farmerkeith/SolarChargerTwoAmp10percent/readme.md

This project is a minimal change to the MPPT solar charger published by deba168 on Instructables.

The changes are just to make the charging process work, and prevent reverse current flow into the panel from the battery. 
Software is still being checked at this stage.
