farmerkeith/SolarChargerTwoAmp10percent/spreadsheets/TwoAmp10%Design.ods

Sheet: ModelDeba168
ModelDeba168: Published as MPPT version 3
Design parameters
 | Min | Nominal | Max
Vpp | 17 | 18 | 25
Vbb | 11.7 | 12 | 14.2
No. of modules | 1
Design current (Amps) | 5
PWM freq | 50,000
Capacitor C1 | ESR | Count | Diameter | Length | Capacitance | C2 count |  | Current
C1 ESR (milli Ohms) | 120 | 1 | 13.5 | 20.5 | 220 | 1 |  | 1 | 3.2 | 5 | 6.67 | 10 | 20
 |  | Count | Rdson 175C | Ciss | Crss | Transconductance | Vth | Vpl-Vth
Q1 MOSFET | IRFZ44N | 1 | 39.375 | 1470 | 88 | 19
Q2 MOSFET (per module) | IRFZ44N | 1 | 39.375 | 1470 | 88 | 19 | 3 | 0.10 | 0.17 | 0.26 | 0.37 | 0.53 | 1.05
Q3 MOSFET (per module) | IRFZ44N | 1 | 39.375 | 1470 | 88 | 19
Vdrv | 12 |  | IR2110 | IR2184 | IR2104
ZdrvON | 71.43 |  | 7.5 |  | 71.43
ZdrvOFF | 41.67 |  | 7.5 |  | 41.67
Toroid | In use |  |  | Data in waiting
Toroid type code | T94-26 |  |  | T94-26 | T106-26 | T130-26 | T157-26 | T225-26B
No. of turns | 24
No. of strands | 1 | Fill factor
Wire diameter | 0.518 | 0.031936996627653 | 20 AWG
OD | 23.9 |  |  | 23.9 | 26.924 | 33 | 39.9 | 57.15
ID | 14.2 |  |  | 14.2 | 14.478 | 19.8 | 24.1 | 35.7
W | 7.9 |  |  | 7.9 | 11.0998 | 11.09 | 14.5 | 25.4
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
