farmerkeith/SolarChargerTwoAmp10percent/spreadsheets/Results1.ods

Sheet: CurentTest_2A
 | charger | 301
 |  |  |  |  |  |  |  |  |  |  | Ipp
pwm1.current_Test:Time | 0.5 | target | 2 | battery_soc | 0.5 | pv_illumination | 0.5 | Vpp | 20.14 | Ipp | 2.8302 | IppL | 0.5322 | Ipp | delta | 2.298 | soc | 0 | Vbb | 11.4898 | Vpp | 21.033 | Ipp | 0.5871 | Ipp | delta | 0.0549 | Ibb | 1.075 | Tt/16 | 12 | Tt | 192 | Tp/16 | 5.4375 | Tp | 87 | Tpe/16 | 6.4375 | Tpe | 103 | track | 8 | current | up, | dcm: | dutyChange | 8 | Tt/16 | 13.5 | Tt | 216 | Tp/16 | 5.9375 | Tp | 95 | Tpe/16 | 10.8125 | Tpe
pwm1.current_Test:Time | 2.356 | target | 2 | battery_soc | 0 | pv_illumination | 1 | Vpp | 21.033 | Ipp | 0.5871 | IppL | 0.5322 | Ipp | delta | 0.0549 | soc | 0.0011 | Vbb | 11.4994 | Vpp | 21.018 | Ipp | 0.6222 | Ipp | delta | -0.0009 | Ibb | 1.137 | Tt/16 | 13.5 | Tt | 216 | Tp/16 | 5.9375 | Tp | 95 | Tpe/16 | 10.8125 | Tpe | 173 | track | 8 | current | up, | dcm: | dutyChange | 8 | Tt/16 | 14.6875 | Tt | 235 | Tp/16 | 6.4375 | Tp | 103 | Tpe/16 | 11.75 | Tpe
pwm1.current_Test:Time | 2.5 | target | 2 | battery_soc | 0 | pv_illumination | 1 | Vpp | 21.018 | Ipp | 0.6222 | IppL | 0.623 | Ipp | delta | -0.0009 | soc | 0.0022 | Vbb | 11.5117 | Vpp | 20.999 | Ipp | 0.6702 | Ipp | delta | -0.0012 | Ibb | 1.223 | Tt/16 | 14.6875 | Tt | 235 | Tp/16 | 6.4375 | Tp | 103 | Tpe/16 | 11.75 | Tpe | 188 | track | 8 | current | up, | dcm: | dutyChange | 8 | Tt/16 | 15.75 | Tt | 252 | Tp/16 | 6.9375 | Tp | 111 | Tpe/16 | 12.625 | Tpe
pwm1.current_Test:Time | 3 | target | 2 | battery_soc | 0 | pv_illumination | 1 | Vpp | 20.999 | Ipp | 0.6702 | IppL | 0.6715 | Ipp | delta | -0.0012 | soc | 0.0034 | Vbb | 11.5252 | Vpp | 20.977 | Ipp | 0.7232 | Ipp | delta | -0.0016 | Ibb | 1.316 | Tt/16 | 15.75 | Tt | 252 | Tp/16 | 6.9375 | Tp | 111 | Tpe/16 | 12.625 | Tpe | 202 | track | 8 | current | up, | dcm: | dutyChange | 8 | Tt/16 | 16.875 | Tt | 270 | Tp/16 | 7.4375 | Tp | 119 | Tpe/16 | 13.5 | Tpe
pwm1.current_Test:Time | 3.5 | target | 2 | battery_soc | 0 | pv_illumination | 1 | Vpp | 20.977 | Ipp | 0.7232 | IppL | 0.7247 | Ipp | delta | -0.0016 | soc | 0.0048 | Vbb | 11.5381 | Vpp | 20.956 | Ipp | 0.7729 | Ipp | delta | -0.0017 | Ibb | 1.404 | Tt/16 | 16.875 | Tt | 270 | Tp/16 | 7.4375 | Tp | 119 | Tpe/16 | 13.5 | Tpe | 216 | track | 8 | current | up, | dcm: | dutyChange | 8 | Tt/16 | 17.9375 | Tt | 287 | Tp/16 | 7.9375 | Tp | 127 | Tpe/16 | 14.375 | Tpe
pwm1.current_Test:Time | 4 | target | 2 | battery_soc | 0.01 | pv_illumination | 1 | Vpp | 20.956 | Ipp | 0.7729 | IppL | 0.7745 | Ipp | delta | -0.0017 | soc | 0.0062 | Vbb | 11.5516 | Vpp | 20.934 | Ipp | 0.8253 | Ipp | delta | -0.0017 | Ibb | 1.496 | Tt/16 | 17.9375 | Tt | 287 | Tp/16 | 7.9375 | Tp | 127 | Tpe/16 | 14.375 | Tpe | 230 | track | 8 | current | up, | dcm: | dutyChange | 8 | Tt/16 | 19.0625 | Tt | 305 | Tp/16 | 8.4375 | Tp | 135 | Tpe/16 | 15.25 | Tpe
pwm1.current_Test:Time | 4.5 | target | 2 | battery_soc | 0.01 | pv_illumination | 1 | Vpp | 20.934 | Ipp | 0.8253 | IppL | 0.827 | Ipp | delta | -0.0017 | soc | 0.0077 | Vbb | 11.5645 | Vpp | 20.914 | Ipp | 0.8742 | Ipp | delta | -0.0018 | Ibb | 1.581 | Tt/16 | 19.0625 | Tt | 305 | Tp/16 | 8.4375 | Tp | 135 | Tpe/16 | 15.25 | Tpe | 244 | track | 8 | current | up, | dcm: | dutyChange | 8 | Tt/16 | 20.125 | Tt | 322 | Tp/16 | 8.9375 | Tp | 143 | Tpe/16 | 16.125 | Tpe
pwm1.current_Test:Time | 5 | target | 2 | battery_soc | 0.01 | pv_illumination | 1 | Vpp | 20.914 | Ipp | 0.8742 | IppL | 0.876 | Ipp | delta | -0.0018 | soc | 0.0092 | Vbb | 11.578 | Vpp | 20.893 | Ipp | 0.9257 | Ipp | delta | -0.0021 | Ibb | 1.67 | Tt/16 | 20.125 | Tt | 322 | Tp/16 | 8.9375 | Tp | 143 | Tpe/16 | 16.125 | Tpe | 258 | track | 8 | current | up, | dcm: | dutyChange | 8 | Tt/16 | 21.25 | Tt | 340 | Tp/16 | 9.4375 | Tp | 151 | Tpe/16 | 17 | Tpe
pwm1.current_Test:Time | 5.5 | target | 2 | battery_soc | 0.01 | pv_illumination | 1 | Vpp | 20.893 | Ipp | 0.9257 | IppL | 0.9278 | Ipp | delta | -0.0021 | soc | 0.0109 | Vbb | 11.5908 | Vpp | 20.873 | Ipp | 0.9741 | Ipp | delta | -0.002 | Ibb | 1.754 | Tt/16 | 21.25 | Tt | 340 | Tp/16 | 9.4375 | Tp | 151 | Tpe/16 | 17 | Tpe | 272 | track | 8 | current | up, | dcm: | dutyChange | 8 | Tt/16 | 22.3125 | Tt | 357 | Tp/16 | 9.9375 | Tp | 159 | Tpe/16 | 17.875 | Tpe
pwm1.current_Test:Time | 6 | target | 2 | battery_soc | 0.01 | pv_illumination | 1 | Vpp | 20.873 | Ipp | 0.9741 | IppL | 0.9761 | Ipp | delta | -0.002 | soc | 0.0127 | Vbb | 11.6044 | Vpp | 20.853 | Ipp | 1.025 | Ipp | delta | -0.0021 | Ibb | 1.842 | Tt/16 | 22.3125 | Tt | 357 | Tp/16 | 9.9375 | Tp | 159 | Tpe/16 | 17.875 | Tpe | 286 | track | 8 | current | up, | dcm: | dutyChange | 8 | Tt/16 | 23.4375 | Tt | 375 | Tp/16 | 10.4375 | Tp | 167 | Tpe/16 | 18.75 | Tpe
pwm1.current_Test:Time | 6.5 | target | 2 | battery_soc | 0.01 | pv_illumination | 1 | Vpp | 20.853 | Ipp | 1.025 | IppL | 1.0271 | Ipp | delta | -0.0021 | soc | 0.0145 | Vbb | 11.6172 | Vpp | 20.833 | Ipp | 1.0726 | Ipp | delta | -0.0021 | Ibb | 1.924 | Tt/16 | 23.4375 | Tt | 375 | Tp/16 | 10.4375 | Tp | 167 | Tpe/16 | 18.75 | Tpe | 300 | track | 8 | current | up, | dcm: | dutyChange | 8 | Tt/16 | 24.4375 | Tt | 391 | Tp/16 | 10.9375 | Tp | 175 | Tpe/16 | 19.5625 | Tpe
pwm1.current_Test:Time | 7 | target | 2 | battery_soc | 0.02 | pv_illumination | 1 | Vpp | 20.833 | Ipp | 1.0726 | IppL | 1.0747 | Ipp | delta | -0.0021 | soc | 0.0164 | Vbb | 11.6313 | Vpp | 20.812 | Ipp | 1.1254 | Ipp | delta | -0.0024 | Ibb | 2.014 | Tt/16 | 24.4375 | Tt | 391 | Tp/16 | 10.9375 | Tp | 175 | Tpe/16 | 19.5625 | Tpe | 313 | track | 8 | current | up, | dcm: | dutyChange | 8 | Tt/16 | 20 | Tt | 320 | Tp/16 | 11.4375 | Tp | 183 | Tpe/16 | 20.4375 | Tpe
pwm1.current_Test:Time | 7.5 | target | 2 | battery_soc | 0.02 | pv_illumination | 1 | Vpp | 20.812 | Ipp | 1.1254 | IppL | 1.1279 | Ipp | delta | -0.0024 | soc | 0.0185 | Vbb | 11.8879 | Vpp | 20.339 | Ipp | 2.3135 | Ipp | delta | 0 | Ibb | 3.958 | Tt/16 | 20 | Tt | 320 | Tp/16 | 11.4375 | Tp | 183 | Tpe/16 | 20.4375 | Tpe | 327 | track | 4 | current | dn, | ccm: | dutyChange | -4 | Tt/16 | 20 | Tt | 320 | Tp/16 | 11.1875 | Tp | 179 | Tpe/16 | 20.4375 | Tpe
pwm1.current_Test:Time | 8 | target | 2 | battery_soc | 0.02 | pv_illumination | 1 | Vpp | 20.339 | Ipp | 2.3135 | IppL | 2.3135 | Ipp | delta | 0 | soc | 0.0225 | Vbb | 11.4027 | Vpp | 21.252 | Ipp | 0.0656 | Ipp | delta | 0 | Ibb | 0.122 | Tt/16 | 20 | Tt | 320 | Tp/16 | 11.1875 | Tp | 179 | Tpe/16 | 20.4375 | Tpe | 327 | track | 5 | current | up, | ccm: | dutyChange | 4 | Tt/16 | 26.625 | Tt | 426 | Tp/16 | 11.4375 | Tp | 183 | Tpe/16 | 21.3125 | Tpe
pwm1.current_Test:Time | 8.5 | target | 2 | battery_soc | 0.02 | pv_illumination | 1 | Vpp | 21.252 | Ipp | 0.0656 | IppL | 0.0656 | Ipp | delta | 0 | soc | 0.0226 | Vbb | 11.6515 | Vpp | 20.8 | Ipp | 1.1545 | Ipp | delta | -0.0553 | Ibb | 2.061 | Tt/16 | 26.625 | Tt | 426 | Tp/16 | 11.4375 | Tp | 183 | Tpe/16 | 21.3125 | Tpe | 341 | track | 5 | current | up, | dcm: | dutyChange | 4 | Tt/16 | 20 | Tt | 320 | Tp/16 | 11.6875 | Tp | 187 | Tpe/16 | 20.8125 | Tpe
pwm1.current_Test:Time | 9.455 | target | 2 | battery_soc | 0.02 | pv_illumination | 1 | Vpp | 20.8 | Ipp | 1.1545 | IppL | 1.2098 | Ipp | delta | -0.0553 | soc | 0.0247 | Vbb | 12.111 | Vpp | 19.938 | Ipp | 3.3645 | Ipp | delta | 0 | Ibb | 5.539 | Tt/16 | 20 | Tt | 320 | Tp/16 | 11.6875 | Tp | 187 | Tpe/16 | 20.8125 | Tpe | 333 | track | 1 | current | dn, | ccm: | dutyChange | -1 | Tt/16 | 20 | Tt | 320 | Tp/16 | 11.625 | Tp | 186 | Tpe/16 | 20.8125 | Tpe
pwm1.current_Test:Time | 9.5 | target | 2 | battery_soc | 0.03 | pv_illumination | 1 | Vpp | 19.938 | Ipp | 3.3645 | IppL | 3.3645 | Ipp | delta | 0 | soc | 0.0305 | Vbb | 11.6287 | Vpp | 20.836 | Ipp | 1.0653 | Ipp | delta | 0 | Ibb | 1.909 | Tt/16 | 20 | Tt | 320 | Tp/16 | 11.625 | Tp | 186 | Tpe/16 | 20.8125 | Tpe | 333 | track | 2 | current | up, | ccm: | dutyChange | 1 | Tt/16 | 20 | Tt | 320 | Tp/16 | 11.6875 | Tp | 187 | Tpe/16 | 20.8125 | Tpe
pwm1.current_Test:Time | 10 | target | 2 | battery_soc | 0.03 | pv_illumination | 1 | Vpp | 20.836 | Ipp | 1.0653 | IppL | 1.0653 | Ipp | delta | 0 | soc | 0.0323 | Vbb | 12.1443 | Vpp | 19.899 | Ipp | 3.4691 | Ipp | delta | 0 | Ibb | 5.684 | Tt/16 | 20 | Tt | 320 | Tp/16 | 11.6875 | Tp | 187 | Tpe/16 | 20.8125 | Tpe | 333 | track | 0 | current | dn, | ccm: | dutyChange | -1 | Tt/16 | 20 | Tt | 320 | Tp/16 | 11.625 | Tp | 186 | Tpe/16 | 20.8125 | Tpe
pwm1.current_Test:Time | 10.5 | target | 2 | battery_soc | 0.04 | pv_illumination | 1 | Vpp | 19.899 | Ipp | 3.4691 | IppL | 3.4691 | Ipp | delta | 0 | soc | 0.0382 | Vbb | 11.6098 | Vpp | 20.893 | Ipp | 0.9252 | Ipp | delta | 0 | Ibb | 1.665 | Tt/16 | 20 | Tt | 320 | Tp/16 | 11.625 | Tp | 186 | Tpe/16 | 20.8125 | Tpe | 333 | track | 2 | current | up, | ccm: | dutyChange | 1 | Tt/16 | 26.25 | Tt | 420 | Tp/16 | 11.6875 | Tp | 187 | Tpe/16 | 21 | Tpe
pwm1.current_Test:Time | 11 | target | 2 | battery_soc | 0.04 | pv_illumination | 1 | Vpp | 20.893 | Ipp | 0.9252 | IppL | 0.9252 | Ipp | delta | 0 | soc | 0.0398 | Vbb | 11.6802 | Vpp | 20.784 | Ipp | 1.1935 | Ipp | delta | -0.0142 | Ibb | 2.124 | Tt/16 | 26.25 | Tt | 420 | Tp/16 | 11.6875 | Tp | 187 | Tpe/16 | 21 | Tpe | 336 | track | 3 | current | up, | dcm: | dutyChange | 1 | Tt/16 | 20 | Tt | 320 | Tp/16 | 11.75 | Tp | 188 | Tpe/16 | 20.875 | Tpe
pwm1.current_Test:Time | 11.5 | target | 2 | battery_soc | 0.04 | pv_illumination | 1 | Vpp | 20.784 | Ipp | 1.1935 | IppL | 1.2077 | Ipp | delta | -0.0142 | soc | 0.042 | Vbb | 12.1647 | Vpp | 19.881 | Ipp | 3.518 | Ipp | delta | 0 | Ibb | 5.75 | Tt/16 | 20 | Tt | 320 | Tp/16 | 11.75 | Tp | 188 | Tpe/16 | 20.875 | Tpe | 334 | track | 0 | current | dn, | ccm: | dutyChange | -1 | Tt/16 | 20 | Tt | 320 | Tp/16 | 11.6875 | Tp | 187 | Tpe/16 | 20.875 | Tpe
pwm1.current_Test:Time | 12 | target | 2 | battery_soc | 0.05 | pv_illumination | 1 | Vpp | 19.881 | Ipp | 3.518 | IppL | 3.518 | Ipp | delta | 0 | soc | 0.048 | Vbb | 11.6629 | Vpp | 20.817 | Ipp | 1.1131 | Ipp | delta | 0 | Ibb | 1.987 | Tt/16 | 20 | Tt | 320 | Tp/16 | 11.6875 | Tp | 187 | Tpe/16 | 20.875 | Tpe | 334 | track | 2 | current | up, | ccm: | dutyChange | 1 | Tt/16 | 20 | Tt | 320 | Tp/16 | 11.75 | Tp | 188 | Tpe/16 | 20.875 | Tpe
pwm1.current_Test:Time | 12.5 | target | 2 | battery_soc | 0.05 | pv_illumination | 1 | Vpp | 20.817 | Ipp | 1.1131 | IppL | 1.1131 | Ipp | delta | 0 | soc | 0.0499 | Vbb | 12.1929 | Vpp | 19.852 | Ipp | 3.5972 | Ipp | delta | 0 | Ibb | 5.857 | Tt/16 | 20 | Tt | 320 | Tp/16 | 11.75 | Tp | 188 | Tpe/16 | 20.875 | Tpe | 334 | track | 0 | current | dn, | ccm: | dutyChange | -1 | Tt/16 | 20 | Tt | 320 | Tp/16 | 11.6875 | Tp | 187 | Tpe/16 | 20.875 | Tpe
pwm1.current_Test:Time | 13 | target | 2 | battery_soc | 0.06 | pv_illumination | 1 | Vpp | 19.852 | Ipp | 3.5972 | IppL | 3.5972 | Ipp | delta | 0 | soc | 0.056 | Vbb | 11.6492 | Vpp | 20.865 | Ipp | 0.9946 | Ipp | delta | 0 | Ibb | 1.782 | Tt/16 | 20 | Tt | 320 | Tp/16 | 11.6875 | Tp | 187 | Tpe/16 | 20.875 | Tpe | 334 | track | 2 | current | up, | ccm: | dutyChange | 1 | Tt/16 | 26.25 | Tt | 420 | Tp/16 | 11.75 | Tp | 188 | Tpe/16 | 21 | Tpe
pwm1.current_Test:Time | 13.5 | target | 2 | battery_soc | 0.06 | pv_illumination | 1 | Vpp | 20.865 | Ipp | 0.9946 | IppL | 0.9946 | Ipp | delta | 0 | soc | 0.0577 | Vbb | 11.7067 | Vpp | 20.781 | Ipp | 1.2008 | Ipp | delta | -0.011 | Ibb | 2.132 | Tt/16 | 26.25 | Tt | 420 | Tp/16 | 11.75 | Tp | 188 | Tpe/16 | 21 | Tpe | 336 | track | 3 | current | up, | dcm: | dutyChange | 1 | Tt/16 | 20 | Tt | 320 | Tp/16 | 11.8125 | Tp | 189 | Tpe/16 | 20.9375 | Tpe
pwm1.current_Test:Time | 14 | target | 2 | battery_soc | 0.06 | pv_illumination | 1 | Vpp | 20.781 | Ipp | 1.2008 | IppL | 1.2118 | Ipp | delta | -0.011 | soc | 0.0598 | Vbb | 12.221 | Vpp | 19.821 | Ipp | 3.681 | Ipp | delta | 0 | Ibb | 5.97 | Tt/16 | 20 | Tt | 320 | Tp/16 | 11.8125 | Tp | 189 | Tpe/16 | 20.9375 | Tpe | 335 | track | 0 | current | dn, | ccm: | dutyChange | -1 | Tt/16 | 20 | Tt | 320 | Tp/16 | 11.75 | Tp | 188 | Tpe/16 | 20.9375 | Tpe
pwm1.current_Test:Time | 14.5 | target | 2 | battery_soc | 0.07 | pv_illumination | 1 | Vpp | 19.821 | Ipp | 3.681 | IppL | 3.681 | Ipp | delta | 0 | soc | 0.0661 | Vbb | 11.6956 | Vpp | 20.802 | Ipp | 1.1495 | Ipp | delta | 0 | Ibb | 2.045 | Tt/16 | 20 | Tt | 320 | Tp/16 | 11.75 | Tp | 188 | Tpe/16 | 20.9375 | Tpe | 335 | track | 2 | current | up, | ccm: | dutyChange | 1 | Tt/16 | 20 | Tt | 320 | Tp/16 | 11.8125 | Tp | 189 | Tpe/16 | 20.9375 | Tpe
pwm1.current_Test:Time | 15 | target | 2 | battery_soc | 0.07 | pv_illumination | 1 | Vpp | 20.802 | Ipp | 1.1495 | IppL | 1.1495 | Ipp | delta | 0 | soc | 0.068 | Vbb | 12.2436 | Vpp | 19.802 | Ipp | 3.7319 | Ipp | delta | 0 | Ibb | 6.036 | Tt/16 | 20 | Tt | 320 | Tp/16 | 11.8125 | Tp | 189 | Tpe/16 | 20.9375 | Tpe | 335 | track | 0 | current | dn, | ccm: | dutyChange | -1 | Tt/16 | 20 | Tt | 320 | Tp/16 | 11.75 | Tp | 188 | Tpe/16 | 20.9375 | Tpe
pwm1.current_Test:Time | 15.5 | target | 2 | battery_soc | 0.07 | pv_illumination | 1 | Vpp | 19.802 | Ipp | 3.7319 | IppL | 3.7319 | Ipp | delta | 0 | soc | 0.0743 | Vbb | 11.6874 | Vpp | 20.84 | Ipp | 1.0551 | Ipp | delta | 0 | Ibb | 1.881 | Tt/16 | 20 | Tt | 320 | Tp/16 | 11.75 | Tp | 188 | Tpe/16 | 20.9375 | Tpe | 335 | track | 2 | current | up, | ccm: | dutyChange | 1 | Tt/16 | 20 | Tt | 320 | Tp/16 | 11.8125 | Tp | 189 | Tpe/16 | 20.9375 | Tpe
pwm1.current_Test:Time | 16 | target | 2 | battery_soc | 0.08 | pv_illumination | 1 | Vpp | 20.84 | Ipp | 1.0551 | IppL | 1.0551 | Ipp | delta | 0 | soc | 0.0761 | Vbb | 12.2633 | Vpp | 19.788 | Ipp | 3.7693 | Ipp | delta | 0 | Ibb | 6.082 | Tt/16 | 20 | Tt | 320 | Tp/16 | 11.8125 | Tp | 189 | Tpe/16 | 20.9375 | Tpe | 335 | track | 0 | current | dn, | ccm: | dutyChange | -1 | Tt/16 | 20 | Tt | 320 | Tp/16 | 11.75 | Tp | 188 | Tpe/16 | 20.9375 | Tpe
pwm1.current_Test:Time | 16.5 | target | 2 | battery_soc | 0.08 | pv_illumination | 1 | Vpp | 19.788 | Ipp | 3.7693 | IppL | 3.7693 | Ipp | delta | 0 | soc | 0.0825 | Vbb | 11.6819 | Vpp | 20.874 | Ipp | 0.9733 | Ipp | delta | 0 | Ibb | 1.739 | Tt/16 | 20 | Tt | 320 | Tp/16 | 11.75 | Tp | 188 | Tpe/16 | 20.9375 | Tpe | 335 | track | 2 | current | up, | ccm: | dutyChange | 1 | Tt/16 | 26.3125 | Tt | 421 | Tp/16 | 11.8125 | Tp | 189 | Tpe/16 | 21.0625 | Tpe
pwm1.current_Test:Time | 17 | target | 2 | battery_soc | 0.08 | pv_illumination | 1 | Vpp | 20.874 | Ipp | 0.9733 | IppL | 0.9733 | Ipp | delta | 0 | soc | 0.0842 | Vbb | 11.7453 | Vpp | 20.779 | Ipp | 1.2062 | Ipp | delta | -0.0124 | Ibb | 2.134 | Tt/16 | 26.3125 | Tt | 421 | Tp/16 | 11.8125 | Tp | 189 | Tpe/16 | 21.0625 | Tpe | 337 | track | 3 | current | up, | dcm: | dutyChange | 1 | Tt/16 | 20 | Tt | 320 | Tp/16 | 11.875 | Tp | 190 | Tpe/16 | 21 | Tpe
pwm1.current_Test:Time | 17.5 | target | 2 | battery_soc | 0.09 | pv_illumination | 1 | Vpp | 20.779 | Ipp | 1.2062 | IppL | 1.2186 | Ipp | delta | -0.0124 | soc | 0.0863 | Vbb | 12.2776 | Vpp | 19.782 | Ipp | 3.7873 | Ipp | delta | 0 | Ibb | 6.102 | Tt/16 | 20 | Tt | 320 | Tp/16 | 11.875 | Tp | 190 | Tpe/16 | 21 | Tpe | 336 | track | 0 | current | dn, | ccm: | dutyChange | -1 | Tt/16 | 20 | Tt | 320 | Tp/16 | 11.8125 | Tp | 189 | Tpe/16 | 21 | Tpe
pwm1.current_Test:Time | 18 | target | 2 | battery_soc | 0.09 | pv_illumination | 1 | Vpp | 19.782 | Ipp | 3.7873 | IppL | 3.7873 | Ipp | delta | 0 | soc | 0.0927 | Vbb | 11.7402 | Vpp | 20.787 | Ipp | 1.1848 | Ipp | delta | 0 | Ibb | 2.098 | Tt/16 | 20 | Tt | 320 | Tp/16 | 11.8125 | Tp | 189 | Tpe/16 | 21 | Tpe | 336 | track | 2 | current | up, | ccm: | dutyChange | 1 | Tt/16 | 20 | Tt | 320 | Tp/16 | 11.875 | Tp | 190 | Tpe/16 | 21 | Tpe
pwm1.current_Test:Time | 18.5 | target | 2 | battery_soc | 0.09 | pv_illumination | 1 | Vpp | 20.787 | Ipp | 1.1848 | IppL | 1.1848 | Ipp | delta | 0 | soc | 0.0947 | Vbb | 12.2946 | Vpp | 19.773 | Ipp | 3.8108 | Ipp | delta | 0 | Ibb | 6.129 | Tt/16 | 20 | Tt | 320 | Tp/16 | 11.875 | Tp | 190 | Tpe/16 | 21 | Tpe | 336 | track | 0 | current | dn, | ccm: | dutyChange | -1 | Tt/16 | 20 | Tt | 320 | Tp/16 | 11.8125 | Tp | 189 | Tpe/16 | 21 | Tpe
pwm1.current_Test:Time | 19 | target | 2 | battery_soc | 0.1 | pv_illumination | 1 | Vpp | 19.773 | Ipp | 3.8108 | IppL | 3.8108 | Ipp | delta | 0 | soc | 0.1011 | Vbb | 11.7373 | Vpp | 20.816 | Ipp | 1.1138 | Ipp | delta | 0 | Ibb | 1.975 | Tt/16 | 20 | Tt | 320 | Tp/16 | 11.8125 | Tp | 189 | Tpe/16 | 21 | Tpe | 336 | track | 2 | current | up, | ccm: | dutyChange | 1 | Tt/16 | 20 | Tt | 320 | Tp/16 | 11.875 | Tp | 190 | Tpe/16 | 21 | Tpe
pwm1.current_Test:Time | 19.5 | target | 2 | battery_soc | 0.1 | pv_illumination | 1 | Vpp | 20.816 | Ipp | 1.1138 | IppL | 1.1138 | Ipp | delta | 0 | soc | 0.103 | Vbb | 12.3094 | Vpp | 19.768 | Ipp | 3.8239 | Ipp | delta | 0 | Ibb | 6.141 | Tt/16 | 20 | Tt | 320 | Tp/16 | 11.875 | Tp | 190 | Tpe/16 | 21 | Tpe | 336 | track | 0 | current | dn, | ccm: | dutyChange | -1 | Tt/16 | 20 | Tt | 320 | Tp/16 | 11.8125 | Tp | 189 | Tpe/16 | 21 | Tpe
pwm1.current_Test:Time | 20 | target | 2 | battery_soc | 0.11 | pv_illumination | 1 | Vpp | 19.768 | Ipp | 3.8239 | IppL | 3.8239 | Ipp | delta | 0 | soc | 0.1095 | Vbb | 11.7364 | Vpp | 20.841 | Ipp | 1.0525 | Ipp | delta | 0 | Ibb | 1.869 | Tt/16 | 20 | Tt | 320 | Tp/16 | 11.8125 | Tp | 189 | Tpe/16 | 21 | Tpe | 336 | track | 2 | current | up, | ccm: | dutyChange | 1 | Tt/16 | 20 | Tt | 320 | Tp/16 | 11.875 | Tp | 190 | Tpe/16 | 21 | Tpe
pwm1.current_Test:Time | 20.5 | target | 2 | battery_soc | 0.11 | pv_illumination | 1 | Vpp | 20.841 | Ipp | 1.0525 | IppL | 1.0525 | Ipp | delta | 0 | soc | 0.1112 | Vbb | 12.3222 | Vpp | 19.767 | Ipp | 3.8282 | Ipp | delta | 0 | Ibb | 6.141 | Tt/16 | 20 | Tt | 320 | Tp/16 | 11.875 | Tp | 190 | Tpe/16 | 21 | Tpe | 336 | track | 0 | current | dn, | ccm: | dutyChange | -1 | Tt/16 | 20 | Tt | 320 | Tp/16 | 11.8125 | Tp | 189 | Tpe/16 | 21 | Tpe
pwm1.current_Test:Time | 21 | target | 2 | battery_soc | 0.12 | pv_illumination | 1 | Vpp | 19.767 | Ipp | 3.8282 | IppL | 3.8282 | Ipp | delta | 0 | soc | 0.1177 | Vbb | 11.7371 | Vpp | 20.863 | Ipp | 0.9995 | Ipp | delta | 0 | Ibb | 1.777 | Tt/16 | 20 | Tt | 320 | Tp/16 | 11.8125 | Tp | 189 | Tpe/16 | 21 | Tpe | 336 | track | 2 | current | up, | ccm: | dutyChange | 1 | Tt/16 | 26.3125 | Tt | 421 | Tp/16 | 11.875 | Tp | 190 | Tpe/16 | 21.0625 | Tpe
pwm1.current_Test:Time | 21.5 | target | 2 | battery_soc | 0.12 | pv_illumination | 1 | Vpp | 20.863 | Ipp | 0.9995 | IppL | 0.9995 | Ipp | delta | 0 | soc | 0.1194 | Vbb | 11.796 | Vpp | 20.777 | Ipp | 1.2113 | Ipp | delta | -0.0114 | Ibb | 2.134 | Tt/16 | 26.3125 | Tt | 421 | Tp/16 | 11.875 | Tp | 190 | Tpe/16 | 21.0625 | Tpe | 337 | track | 3 | current | up, | dcm: | dutyChange | 1 | Tt/16 | 20 | Tt | 320 | Tp/16 | 11.9375 | Tp | 191 | Tpe/16 | 21 | Tpe
pwm1.current_Test:Time | 22 | target | 2 | battery_soc | 0.12 | pv_illumination | 1 | Vpp | 20.777 | Ipp | 1.2113 | IppL | 1.2227 | Ipp | delta | -0.0114 | soc | 0.1215 | Vbb | 12.3349 | Vpp | 19.763 | Ipp | 3.8381 | Ipp | delta | 0 | Ibb | 6.149 | Tt/16 | 20 | Tt | 320 | Tp/16 | 11.9375 | Tp | 191 | Tpe/16 | 21 | Tpe | 336 | track | 0 | current | dn, | ccm: | dutyChange | -1 | Tt/16 | 20 | Tt | 320 | Tp/16 | 11.875 | Tp | 190 | Tpe/16 | 21 | Tpe
pwm1.current_Test:Time | 22.5 | target | 2 | battery_soc | 0.13 | pv_illumination | 1 | Vpp | 19.763 | Ipp | 3.8381 | IppL | 3.8381 | Ipp | delta | 0 | soc | 0.128 | Vbb | 11.7965 | Vpp | 20.775 | Ipp | 1.2166 | Ipp | delta | 0 | Ibb | 2.143 | Tt/16 | 20 | Tt | 320 | Tp/16 | 11.875 | Tp | 190 | Tpe/16 | 21 | Tpe | 336 | track | 2 | current | up, | ccm: | dutyChange | 1 | Tt/16 | 20 | Tt | 320 | Tp/16 | 11.9375 | Tp | 191 | Tpe/16 | 21 | Tpe
pwm1.current_Test:Time | 23 | target | 2 | battery_soc | 0.13 | pv_illumination | 1 | Vpp | 20.775 | Ipp | 1.2166 | IppL | 1.2166 | Ipp | delta | 0 | soc | 0.13 | Vbb | 12.3467 | Vpp | 19.764 | Ipp | 3.8359 | Ipp | delta | 0 | Ibb | 6.14 | Tt/16 | 20 | Tt | 320 | Tp/16 | 11.9375 | Tp | 191 | Tpe/16 | 21 | Tpe | 336 | track | 0 | current | dn, | ccm: | dutyChange | -1 | Tt/16 | 20 | Tt | 320 | Tp/16 | 11.875 | Tp | 190 | Tpe/16 | 21 | Tpe
pwm1.current_Test:Time | 23.5 | target | 2 | battery_soc | 0.14 | pv_illumination | 1 | Vpp | 19.764 | Ipp | 3.8359 | IppL | 3.8359 | Ipp | delta | 0 | soc | 0.1364 | Vbb | 11.7984 | Vpp | 20.794 | Ipp | 1.1677 | Ipp | delta | 0 | Ibb | 2.058 | Tt/16 | 20 | Tt | 320 | Tp/16 | 11.875 | Tp | 190 | Tpe/16 | 21 | Tpe | 336 | track | 2 | current | up, | ccm: | dutyChange | 1 | Tt/16 | 20 | Tt | 320 | Tp/16 | 11.9375 | Tp | 191 | Tpe/16 | 21 | Tpe
pwm1.current_Test:Time | 24 | target | 2 | battery_soc | 0.14 | pv_illumination | 1 | Vpp | 20.794 | Ipp | 1.1677 | IppL | 1.1677 | Ipp | delta | 0 | soc | 0.1384 | Vbb | 12.3569 | Vpp | 19.767 | Ipp | 3.827 | Ipp | delta | 0 | Ibb | 6.122 | Tt/16 | 20 | Tt | 320 | Tp/16 | 11.9375 | Tp | 191 | Tpe/16 | 21 | Tpe | 336 | track | 0 | current | dn, | ccm: | dutyChange | -1 | Tt/16 | 20 | Tt | 320 | Tp/16 | 11.875 | Tp | 190 | Tpe/16 | 21 | Tpe
pwm1.current_Test:Time | 24.5 | target | 2 | battery_soc | 0.14 | pv_illumination | 1 | Vpp | 19.767 | Ipp | 3.827 | IppL | 3.827 | Ipp | delta | 0 | soc | 0.1448 | Vbb | 11.8016 | Vpp | 20.812 | Ipp | 1.1252 | Ipp | delta | 0 | Ibb | 1.984 | Tt/16 | 20 | Tt | 320 | Tp/16 | 11.875 | Tp | 190 | Tpe/16 | 21 | Tpe | 336 | track | 2 | current | up, | ccm: | dutyChange | 1 | Tt/16 | 20 | Tt | 320 | Tp/16 | 11.9375 | Tp | 191 | Tpe/16 | 21 | Tpe
pwm1.current_Test:Time | 25 | target | 2 | battery_soc | 0.15 | pv_illumination | 1 | Vpp | 20.812 | Ipp | 1.1252 | IppL | 1.1252 | Ipp | delta | 0 | soc | 0.1467 | Vbb | 12.3659 | Vpp | 19.772 | Ipp | 3.8126 | Ipp | delta | 0 | Ibb | 6.096 | Tt/16 | 20 | Tt | 320 | Tp/16 | 11.9375 | Tp | 191 | Tpe/16 | 21 | Tpe | 336 | track | 0 | current | dn, | ccm: | dutyChange | -1 | Tt/16 | 20 | Tt | 320 | Tp/16 | 11.875 | Tp | 190 | Tpe/16 | 21 | Tpe
pwm1.current_Test:Time | 25.5 | target | 2 | battery_soc | 0.15 | pv_illumination | 1 | Vpp | 19.772 | Ipp | 3.8126 | IppL | 3.8126 | Ipp | delta | 0 | soc | 0.1531 | Vbb | 11.8057 | Vpp | 20.827 | Ipp | 1.088 | Ipp | delta | 0 | Ibb | 1.919 | Tt/16 | 20 | Tt | 320 | Tp/16 | 11.875 | Tp | 190 | Tpe/16 | 21 | Tpe | 336 | track | 2 | current | up, | ccm: | dutyChange | 1 | Tt/16 | 20 | Tt | 320 | Tp/16 | 11.9375 | Tp | 191 | Tpe/16 | 21 | Tpe
pwm1.current_Test:Time | 26 | target | 2 | battery_soc | 0.15 | pv_illumination | 1 | Vpp | 20.827 | Ipp | 1.088 | IppL | 1.088 | Ipp | delta | 0 | soc | 0.1549 | Vbb | 12.3738 | Vpp | 19.779 | Ipp | 3.7938 | Ipp | delta | 0 | Ibb | 6.064 | Tt/16 | 20 | Tt | 320 | Tp/16 | 11.9375 | Tp | 191 | Tpe/16 | 21 | Tpe | 336 | track | 0 | current | dn, | ccm: | dutyChange | -1 | Tt/16 | 20 | Tt | 320 | Tp/16 | 11.875 | Tp | 190 | Tpe/16 | 21 | Tpe
pwm1.current_Test:Time | 26.5 | target | 2 | battery_soc | 0.16 | pv_illumination | 1 | Vpp | 19.779 | Ipp | 3.7938 | IppL | 3.7938 | Ipp | delta | 0 | soc | 0.1613 | Vbb | 11.8107 | Vpp | 20.84 | Ipp | 1.0553 | Ipp | delta | 0 | Ibb | 1.862 | Tt/16 | 20 | Tt | 320 | Tp/16 | 11.875 | Tp | 190 | Tpe/16 | 21 | Tpe | 336 | track | 2 | current | up, | ccm: | dutyChange | 1 | Tt/16 | 20 | Tt | 320 | Tp/16 | 11.9375 | Tp | 191 | Tpe/16 | 21 | Tpe
pwm1.current_Test:Time | 27 | target | 2 | battery_soc | 0.16 | pv_illumination | 1 | Vpp | 20.84 | Ipp | 1.0553 | IppL | 1.0553 | Ipp | delta | 0 | soc | 0.1631 | Vbb | 12.3809 | Vpp | 19.788 | Ipp | 3.7712 | Ipp | delta | 0 | Ibb | 6.027 | Tt/16 | 20 | Tt | 320 | Tp/16 | 11.9375 | Tp | 191 | Tpe/16 | 21 | Tpe | 336 | track | 0 | current | dn, | ccm: | dutyChange | -1 | Tt/16 | 20 | Tt | 320 | Tp/16 | 11.875 | Tp | 190 | Tpe/16 | 21 | Tpe
pwm1.current_Test:Time | 27.5 | target | 2 | battery_soc | 0.17 | pv_illumination | 1 | Vpp | 19.788 | Ipp | 3.7712 | IppL | 3.7712 | Ipp | delta | 0 | soc | 0.1694 | Vbb | 11.8163 | Vpp | 20.852 | Ipp | 1.0263 | Ipp | delta | 0 | Ibb | 1.811 | Tt/16 | 20 | Tt | 320 | Tp/16 | 11.875 | Tp | 190 | Tpe/16 | 21 | Tpe | 336 | track | 2 | current | up, | ccm: | dutyChange | 1 | Tt/16 | 20 | Tt | 320 | Tp/16 | 11.9375 | Tp | 191 | Tpe/16 | 21 | Tpe
pwm1.current_Test:Time | 28 | target | 2 | battery_soc | 0.17 | pv_illumination | 1 | Vpp | 20.852 | Ipp | 1.0263 | IppL | 1.0263 | Ipp | delta | 0 | soc | 0.1711 | Vbb | 12.3872 | Vpp | 19.797 | Ipp | 3.7458 | Ipp | delta | 0 | Ibb | 5.986 | Tt/16 | 20 | Tt | 320 | Tp/16 | 11.9375 | Tp | 191 | Tpe/16 | 21 | Tpe | 336 | track | 0 | current | dn, | ccm: | dutyChange | -1 | Tt/16 | 20 | Tt | 320 | Tp/16 | 11.875 | Tp | 190 | Tpe/16 | 21 | Tpe
pwm1.current_Test:Time | 28.5 | target | 2 | battery_soc | 0.18 | pv_illumination | 1 | Vpp | 19.797 | Ipp | 3.7458 | IppL | 3.7458 | Ipp | delta | 0 | soc | 0.1774 | Vbb | 11.8224 | Vpp | 20.863 | Ipp | 1.0004 | Ipp | delta | 0 | Ibb | 1.765 | Tt/16 | 20 | Tt | 320 | Tp/16 | 11.875 | Tp | 190 | Tpe/16 | 21 | Tpe | 336 | track | 2 | current | up, | ccm: | dutyChange | 1 | Tt/16 | 26.3125 | Tt | 421 | Tp/16 | 11.9375 | Tp | 191 | Tpe/16 | 21.0625 | Tpe
pwm1.current_Test:Time | 29 | target | 2 | battery_soc | 0.18 | pv_illumination | 1 | Vpp | 20.863 | Ipp | 1.0004 | IppL | 1.0004 | Ipp | delta | 0 | soc | 0.1791

Sheet: CurrentTest_2A.2
 | charger | 301
 |  |  |  |  |  |  |  |  |  |  |  |  |  |  |  |  |  |  |  | Vbb |  |  |  | Ipp
pwm1.current_Test:Time | 0.5 | target | 2 | battery_soc | 0.5 | pv_illumination | 0.5 | Vpp | 20.14 | Ipp | 2.8302 | IppL | 0.5322 | Ipp | delta | 2.298 | soc | 0 | Vbb | 11.4898 | Vpp | 21.033 | Ipp | 0.5871 | Ipp | delta | 0.0549 | Ibb | 1.075 | Tt/16 | 12 | Tt | 192 | Tp/16 | 5.4375 | Tp | 87 | Tpe/16 | 6.4375 | Tpe | 103 | track | 8 | current | up, | dcm: | dutyChange | 8 | Tt/16 | 13.5 | Tt | 216 | Tp/16 | 5.9375 | Tp | 95 | Tpe/16 | 10.8125 | Tpe
pwm1.current_Test:Time | 2.356 | target | 2 | battery_soc | 0 | pv_illumination | 1 | Vpp | 21.033 | Ipp | 0.5871 | IppL | 0.5322 | Ipp | delta | 0.0549 | soc | 0.0011 | Vbb | 11.4994 | Vpp | 21.018 | Ipp | 0.6222 | Ipp | delta | -0.0009 | Ibb | 1.137 | Tt/16 | 13.5 | Tt | 216 | Tp/16 | 5.9375 | Tp | 95 | Tpe/16 | 10.8125 | Tpe | 173 | track | 8 | current | up, | dcm: | dutyChange | 8 | Tt/16 | 14.6875 | Tt | 235 | Tp/16 | 6.4375 | Tp | 103 | Tpe/16 | 11.75 | Tpe
pwm1.current_Test:Time | 2.5 | target | 2 | battery_soc | 0 | pv_illumination | 1 | Vpp | 21.018 | Ipp | 0.6222 | IppL | 0.623 | Ipp | delta | -0.0009 | soc | 0.0022 | Vbb | 11.5117 | Vpp | 20.999 | Ipp | 0.6702 | Ipp | delta | -0.0012 | Ibb | 1.223 | Tt/16 | 14.6875 | Tt | 235 | Tp/16 | 6.4375 | Tp | 103 | Tpe/16 | 11.75 | Tpe | 188 | track | 8 | current | up, | dcm: | dutyChange | 8 | Tt/16 | 15.75 | Tt | 252 | Tp/16 | 6.9375 | Tp | 111 | Tpe/16 | 12.625 | Tpe
pwm1.current_Test:Time | 3 | target | 2 | battery_soc | 0 | pv_illumination | 1 | Vpp | 20.999 | Ipp | 0.6702 | IppL | 0.6715 | Ipp | delta | -0.0012 | soc | 0.0034 | Vbb | 11.5252 | Vpp | 20.977 | Ipp | 0.7232 | Ipp | delta | -0.0016 | Ibb | 1.316 | Tt/16 | 15.75 | Tt | 252 | Tp/16 | 6.9375 | Tp | 111 | Tpe/16 | 12.625 | Tpe | 202 | track | 8 | current | up, | dcm: | dutyChange | 8 | Tt/16 | 16.875 | Tt | 270 | Tp/16 | 7.4375 | Tp | 119 | Tpe/16 | 13.5 | Tpe
pwm1.current_Test:Time | 3.5 | target | 2 | battery_soc | 0 | pv_illumination | 1 | Vpp | 20.977 | Ipp | 0.7232 | IppL | 0.7247 | Ipp | delta | -0.0016 | soc | 0.0048 | Vbb | 11.5381 | Vpp | 20.956 | Ipp | 0.7729 | Ipp | delta | -0.0017 | Ibb | 1.404 | Tt/16 | 16.875 | Tt | 270 | Tp/16 | 7.4375 | Tp | 119 | Tpe/16 | 13.5 | Tpe | 216 | track | 8 | current | up, | dcm: | dutyChange | 8 | Tt/16 | 17.9375 | Tt | 287 | Tp/16 | 7.9375 | Tp | 127 | Tpe/16 | 14.375 | Tpe
pwm1.current_Test:Time | 4 | target | 2 | battery_soc | 0.01 | pv_illumination | 1 | Vpp | 20.956 | Ipp | 0.7729 | IppL | 0.7745 | Ipp | delta | -0.0017 | soc | 0.0062 | Vbb | 11.5516 | Vpp | 20.934 | Ipp | 0.8253 | Ipp | delta | -0.0017 | Ibb | 1.496 | Tt/16 | 17.9375 | Tt | 287 | Tp/16 | 7.9375 | Tp | 127 | Tpe/16 | 14.375 | Tpe | 230 | track | 8 | current | up, | dcm: | dutyChange | 8 | Tt/16 | 19.0625 | Tt | 305 | Tp/16 | 8.4375 | Tp | 135 | Tpe/16 | 15.25 | Tpe
pwm1.current_Test:Time | 4.5 | target | 2 | battery_soc | 0.01 | pv_illumination | 1 | Vpp | 20.934 | Ipp | 0.8253 | IppL | 0.827 | Ipp | delta | -0.0017 | soc | 0.0077 | Vbb | 11.5645 | Vpp | 20.914 | Ipp | 0.8742 | Ipp | delta | -0.0018 | Ibb | 1.581 | Tt/16 | 19.0625 | Tt | 305 | Tp/16 | 8.4375 | Tp | 135 | Tpe/16 | 15.25 | Tpe | 244 | track | 8 | current | up, | dcm: | dutyChange | 8 | Tt/16 | 20.125 | Tt | 322 | Tp/16 | 8.9375 | Tp | 143 | Tpe/16 | 16.125 | Tpe
pwm1.current_Test:Time | 5 | target | 2 | battery_soc | 0.01 | pv_illumination | 1 | Vpp | 20.914 | Ipp | 0.8742 | IppL | 0.876 | Ipp | delta | -0.0018 | soc | 0.0092 | Vbb | 11.578 | Vpp | 20.893 | Ipp | 0.9257 | Ipp | delta | -0.0021 | Ibb | 1.67 | Tt/16 | 20.125 | Tt | 322 | Tp/16 | 8.9375 | Tp | 143 | Tpe/16 | 16.125 | Tpe | 258 | track | 8 | current | up, | dcm: | dutyChange | 8 | Tt/16 | 21.25 | Tt | 340 | Tp/16 | 9.4375 | Tp | 151 | Tpe/16 | 17 | Tpe
pwm1.current_Test:Time | 5.5 | target | 2 | battery_soc | 0.01 | pv_illumination | 1 | Vpp | 20.893 | Ipp | 0.9257 | IppL | 0.9278 | Ipp | delta | -0.0021 | soc | 0.0109 | Vbb | 11.5908 | Vpp | 20.873 | Ipp | 0.9741 | Ipp | delta | -0.002 | Ibb | 1.754 | Tt/16 | 21.25 | Tt | 340 | Tp/16 | 9.4375 | Tp | 151 | Tpe/16 | 17 | Tpe | 272 | track | 8 | current | up, | dcm: | dutyChange | 8 | Tt/16 | 22.3125 | Tt | 357 | Tp/16 | 9.9375 | Tp | 159 | Tpe/16 | 17.875 | Tpe
pwm1.current_Test:Time | 6 | target | 2 | battery_soc | 0.01 | pv_illumination | 1 | Vpp | 20.873 | Ipp | 0.9741 | IppL | 0.9761 | Ipp | delta | -0.002 | soc | 0.0127 | Vbb | 11.6044 | Vpp | 20.853 | Ipp | 1.025 | Ipp | delta | -0.0021 | Ibb | 1.842 | Tt/16 | 22.3125 | Tt | 357 | Tp/16 | 9.9375 | Tp | 159 | Tpe/16 | 17.875 | Tpe | 286 | track | 8 | current | up, | dcm: | dutyChange | 8 | Tt/16 | 23.4375 | Tt | 375 | Tp/16 | 10.4375 | Tp | 167 | Tpe/16 | 18.75 | Tpe
pwm1.current_Test:Time | 6.5 | target | 2 | battery_soc | 0.01 | pv_illumination | 1 | Vpp | 20.853 | Ipp | 1.025 | IppL | 1.0271 | Ipp | delta | -0.0021 | soc | 0.0145 | Vbb | 11.6172 | Vpp | 20.833 | Ipp | 1.0726 | Ipp | delta | -0.0021 | Ibb | 1.924 | Tt/16 | 23.4375 | Tt | 375 | Tp/16 | 10.4375 | Tp | 167 | Tpe/16 | 18.75 | Tpe | 300 | track | 8 | current | up, | dcm: | dutyChange | 8 | Tt/16 | 24.4375 | Tt | 391 | Tp/16 | 10.9375 | Tp | 175 | Tpe/16 | 19.5625 | Tpe
pwm1.current_Test:Time | 7 | target | 2 | battery_soc | 0.02 | pv_illumination | 1 | Vpp | 20.833 | Ipp | 1.0726 | IppL | 1.0747 | Ipp | delta | -0.0021 | soc | 0.0164 | Vbb | 11.6313 | Vpp | 20.812 | Ipp | 1.1254 | Ipp | delta | -0.0024 | Ibb | 2.014 | Tt/16 | 24.4375 | Tt | 391 | Tp/16 | 10.9375 | Tp | 175 | Tpe/16 | 19.5625 | Tpe | 313 | track | 8 | current | up, | dcm: | dutyChange | 8 | Tt/16 | 20 | Tt | 320 | Tp/16 | 11.4375 | Tp | 183 | Tpe/16 | 20.4375 | Tpe
pwm1.current_Test:Time | 7.5 | target | 2 | battery_soc | 0.02 | pv_illumination | 1 | Vpp | 20.812 | Ipp | 1.1254 | IppL | 1.1279 | Ipp | delta | -0.0024 | soc | 0.0185 | Vbb | 11.8879 | Vpp | 20.339 | Ipp | 2.3135 | Ipp | delta | 0 | Ibb | 3.958 | Tt/16 | 20 | Tt | 320 | Tp/16 | 11.4375 | Tp | 183 | Tpe/16 | 20.4375 | Tpe | 327 | track | 4 | current | dn, | ccm: | dutyChange | -4 | Tt/16 | 20 | Tt | 320 | Tp/16 | 11.1875 | Tp | 179 | Tpe/16 | 20.4375 | Tpe
pwm1.current_Test:Time | 8 | target | 2 | battery_soc | 0.02 | pv_illumination | 1 | Vpp | 20.339 | Ipp | 2.3135 | IppL | 2.3135 | Ipp | delta | 0 | soc | 0.0225 | Vbb | 11.4027 | Vpp | 21.252 | Ipp | 0.0656 | Ipp | delta | 0 | Ibb | 0.122 | Tt/16 | 20 | Tt | 320 | Tp/16 | 11.1875 | Tp | 179 | Tpe/16 | 20.4375 | Tpe | 327 | track | 5 | current | up, | ccm: | dutyChange | 4 | Tt/16 | 26.625 | Tt | 426 | Tp/16 | 11.4375 | Tp | 183 | Tpe/16 | 21.3125 | Tpe
pwm1.current_Test:Time | 8.5 | target | 2 | battery_soc | 0.02 | pv_illumination | 1 | Vpp | 21.252 | Ipp | 0.0656 | IppL | 0.0656 | Ipp | delta | 0 | soc | 0.0226 | Vbb | 11.6515 | Vpp | 20.8 | Ipp | 1.1545 | Ipp | delta | -0.0553 | Ibb | 2.061 | Tt/16 | 26.625 | Tt | 426 | Tp/16 | 11.4375 | Tp | 183 | Tpe/16 | 21.3125 | Tpe | 341 | track | 5 | current | up, | dcm: | dutyChange | 4 | Tt/16 | 20 | Tt | 320 | Tp/16 | 11.6875 | Tp | 187 | Tpe/16 | 20.8125 | Tpe
pwm1.current_Test:Time | 9.455 | target | 2 | battery_soc | 0.02 | pv_illumination | 1 | Vpp | 20.8 | Ipp | 1.1545 | IppL | 1.2098 | Ipp | delta | -0.0553 | soc | 0.0247 | Vbb | 12.111 | Vpp | 19.938 | Ipp | 3.3645 | Ipp | delta | 0 | Ibb | 5.539 | Tt/16 | 20 | Tt | 320 | Tp/16 | 11.6875 | Tp | 187 | Tpe/16 | 20.8125 | Tpe | 333 | track | 1 | current | dn, | ccm: | dutyChange | -1 | Tt/16 | 20 | Tt | 320 | Tp/16 | 11.625 | Tp | 186 | Tpe/16 | 20.8125 | Tpe
pwm1.current_Test:Time | 9.5 | target | 2 | battery_soc | 0.03 | pv_illumination | 1 | Vpp | 19.938 | Ipp | 3.3645 | IppL | 3.3645 | Ipp | delta | 0 | soc | 0.0305 | Vbb | 11.6287 | Vpp | 20.836 | Ipp | 1.0653 | Ipp | delta | 0 | Ibb | 1.909 | Tt/16 | 20 | Tt | 320 | Tp/16 | 11.625 | Tp | 186 | Tpe/16 | 20.8125 | Tpe | 333 | track | 2 | current | up, | ccm: | dutyChange | 1 | Tt/16 | 20 | Tt | 320 | Tp/16 | 11.6875 | Tp | 187 | Tpe/16 | 20.8125 | Tpe
pwm1.current_Test:Time | 10 | target | 2 | battery_soc | 0.03 | pv_illumination | 1 | Vpp | 20.836 | Ipp | 1.0653 | IppL | 1.0653 | Ipp | delta | 0 | soc | 0.0323 | Vbb | 12.1443 | Vpp | 19.899 | Ipp | 3.4691 | Ipp | delta | 0 | Ibb | 5.684 | Tt/16 | 20 | Tt | 320 | Tp/16 | 11.6875 | Tp | 187 | Tpe/16 | 20.8125 | Tpe | 333 | track | 0 | current | dn, | ccm: | dutyChange | -1 | Tt/16 | 20 | Tt | 320 | Tp/16 | 11.625 | Tp | 186 | Tpe/16 | 20.8125 | Tpe
pwm1.current_Test:Time | 10.5 | target | 2 | battery_soc | 0.04 | pv_illumination | 1 | Vpp | 19.899 | Ipp | 3.4691 | IppL | 3.4691 | Ipp | delta | 0 | soc | 0.0382 | Vbb | 11.6098 | Vpp | 20.893 | Ipp | 0.9252 | Ipp | delta | 0 | Ibb | 1.665 | Tt/16 | 20 | Tt | 320 | Tp/16 | 11.625 | Tp | 186 | Tpe/16 | 20.8125 | Tpe | 333 | track | 2 | current | up, | ccm: | dutyChange | 1 | Tt/16 | 26.25 | Tt | 420 | Tp/16 | 11.6875 | Tp | 187 | Tpe/16 | 21 | Tpe
pwm1.current_Test:Time | 11 | target | 2 | battery_soc | 0.04 | pv_illumination | 1 | Vpp | 20.893 | Ipp | 0.9252 | IppL | 0.9252 | Ipp | delta | 0 | soc | 0.0398 | Vbb | 11.6802 | Vpp | 20.784 | Ipp | 1.1935 | Ipp | delta | -0.0142 | Ibb | 2.124 | Tt/16 | 26.25 | Tt | 420 | Tp/16 | 11.6875 | Tp | 187 | Tpe/16 | 21 | Tpe | 336 | track | 3 | current | up, | dcm: | dutyChange | 1 | Tt/16 | 20 | Tt | 320 | Tp/16 | 11.75 | Tp | 188 | Tpe/16 | 20.875 | Tpe
pwm1.current_Test:Time | 11.5 | target | 2 | battery_soc | 0.04 | pv_illumination | 1 | Vpp | 20.784 | Ipp | 1.1935 | IppL | 1.2077 | Ipp | delta | -0.0142 | soc | 0.042 | Vbb | 12.1647 | Vpp | 19.881 | Ipp | 3.518 | Ipp | delta | 0 | Ibb | 5.75 | Tt/16 | 20 | Tt | 320 | Tp/16 | 11.75 | Tp | 188 | Tpe/16 | 20.875 | Tpe | 334 | track | 0 | current | dn, | ccm: | dutyChange | -1 | Tt/16 | 20 | Tt | 320 | Tp/16 | 11.6875 | Tp | 187 | Tpe/16 | 20.875 | Tpe
pwm1.current_Test:Time | 12 | target | 2 | battery_soc | 0.05 | pv_illumination | 1 | Vpp | 19.881 | Ipp | 3.518 | IppL | 3.518 | Ipp | delta | 0 | soc | 0.048 | Vbb | 11.6629 | Vpp | 20.817 | Ipp | 1.1131 | Ipp | delta | 0 | Ibb | 1.987 | Tt/16 | 20 | Tt | 320 | Tp/16 | 11.6875 | Tp | 187 | Tpe/16 | 20.875 | Tpe | 334 | track | 2 | current | up, | ccm: | dutyChange | 1 | Tt/16 | 20 | Tt | 320 | Tp/16 | 11.75 | Tp | 188 | Tpe/16 | 20.875 | Tpe
pwm1.current_Test:Time | 12.5 | target | 2 | battery_soc | 0.05 | pv_illumination | 1 | Vpp | 20.817 | Ipp | 1.1131 | IppL | 1.1131 | Ipp | delta | 0 | soc | 0.0499 | Vbb | 12.1929 | Vpp | 19.852 | Ipp | 3.5972 | Ipp | delta | 0 | Ibb | 5.857 | Tt/16 | 20 | Tt | 320 | Tp/16 | 11.75 | Tp | 188 | Tpe/16 | 20.875 | Tpe | 334 | track | 0 | current | dn, | ccm: | dutyChange | -1 | Tt/16 | 20 | Tt | 320 | Tp/16 | 11.6875 | Tp | 187 | Tpe/16 | 20.875 | Tpe
pwm1.current_Test:Time | 13 | target | 2 | battery_soc | 0.06 | pv_illumination | 1 | Vpp | 19.852 | Ipp | 3.5972 | IppL | 3.5972 | Ipp | delta | 0 | soc | 0.056 | Vbb | 11.6492 | Vpp | 20.865 | Ipp | 0.9946 | Ipp | delta | 0 | Ibb | 1.782 | Tt/16 | 20 | Tt | 320 | Tp/16 | 11.6875 | Tp | 187 | Tpe/16 | 20.875 | Tpe | 334 | track | 2 | current | up, | ccm: | dutyChange | 1 | Tt/16 | 26.25 | Tt | 420 | Tp/16 | 11.75 | Tp | 188 | Tpe/16 | 21 | Tpe
pwm1.current_Test:Time | 13.5 | target | 2 | battery_soc | 0.06 | pv_illumination | 1 | Vpp | 20.865 | Ipp | 0.9946 | IppL | 0.9946 | Ipp | delta | 0 | soc | 0.0577 | Vbb | 11.7067 | Vpp | 20.781 | Ipp | 1.2008 | Ipp | delta | -0.011 | Ibb | 2.132 | Tt/16 | 26.25 | Tt | 420 | Tp/16 | 11.75 | Tp | 188 | Tpe/16 | 21 | Tpe | 336 | track | 3 | current | up, | dcm: | dutyChange | 1 | Tt/16 | 20 | Tt | 320 | Tp/16 | 11.8125 | Tp | 189 | Tpe/16 | 20.9375 | Tpe
pwm1.current_Test:Time | 14 | target | 2 | battery_soc | 0.06 | pv_illumination | 1 | Vpp | 20.781 | Ipp | 1.2008 | IppL | 1.2118 | Ipp | delta | -0.011 | soc | 0.0598 | Vbb | 12.221 | Vpp | 19.821 | Ipp | 3.681 | Ipp | delta | 0 | Ibb | 5.97 | Tt/16 | 20 | Tt | 320 | Tp/16 | 11.8125 | Tp | 189 | Tpe/16 | 20.9375 | Tpe | 335 | track | 0 | current | dn, | ccm: | dutyChange | -1 | Tt/16 | 20 | Tt | 320 | Tp/16 | 11.75 | Tp | 188 | Tpe/16 | 20.9375 | Tpe
pwm1.current_Test:Time | 14.5 | target | 2 | battery_soc | 0.07 | pv_illumination | 1 | Vpp | 19.821 | Ipp | 3.681 | IppL | 3.681 | Ipp | delta | 0 | soc | 0.0661 | Vbb | 11.6956 | Vpp | 20.802 | Ipp | 1.1495 | Ipp | delta | 0 | Ibb | 2.045 | Tt/16 | 20 | Tt | 320 | Tp/16 | 11.75 | Tp | 188 | Tpe/16 | 20.9375 | Tpe | 335 | track | 2 | current | up, | ccm: | dutyChange | 1 | Tt/16 | 20 | Tt | 320 | Tp/16 | 11.8125 | Tp | 189 | Tpe/16 | 20.9375 | Tpe
pwm1.current_Test:Time | 15 | target | 2 | battery_soc | 0.07 | pv_illumination | 1 | Vpp | 20.802 | Ipp | 1.1495 | IppL | 1.1495 | Ipp | delta | 0 | soc | 0.068 | Vbb | 12.2436 | Vpp | 19.802 | Ipp | 3.7319 | Ipp | delta | 0 | Ibb | 6.036 | Tt/16 | 20 | Tt | 320 | Tp/16 | 11.8125 | Tp | 189 | Tpe/16 | 20.9375 | Tpe | 335 | track | 0 | current | dn, | ccm: | dutyChange | -1 | Tt/16 | 20 | Tt | 320 | Tp/16 | 11.75 | Tp | 188 | Tpe/16 | 20.9375 | Tpe
pwm1.current_Test:Time | 15.5 | target | 2 | battery_soc | 0.07 | pv_illumination | 1 | Vpp | 19.802 | Ipp | 3.7319 | IppL | 3.7319 | Ipp | delta | 0 | soc | 0.0743 | Vbb | 11.6874 | Vpp | 20.84 | Ipp | 1.0551 | Ipp | delta | 0 | Ibb | 1.881 | Tt/16 | 20 | Tt | 320 | Tp/16 | 11.75 | Tp | 188 | Tpe/16 | 20.9375 | Tpe | 335 | track | 2 | current | up, | ccm: | dutyChange | 1 | Tt/16 | 20 | Tt | 320 | Tp/16 | 11.8125 | Tp | 189 | Tpe/16 | 20.9375 | Tpe
pwm1.current_Test:Time | 16 | target | 2 | battery_soc | 0.08 | pv_illumination | 1 | Vpp | 20.84 | Ipp | 1.0551 | IppL | 1.0551 | Ipp | delta | 0 | soc | 0.0761 | Vbb | 12.2633 | Vpp | 19.788 | Ipp | 3.7693 | Ipp | delta | 0 | Ibb | 6.082 | Tt/16 | 20 | Tt | 320 | Tp/16 | 11.8125 | Tp | 189 | Tpe/16 | 20.9375 | Tpe | 335 | track | 0 | current | dn, | ccm: | dutyChange | -1 | Tt/16 | 20 | Tt | 320 | Tp/16 | 11.75 | Tp | 188 | Tpe/16 | 20.9375 | Tpe
pwm1.current_Test:Time | 16.5 | target | 2 | battery_soc | 0.08 | pv_illumination | 1 | Vpp | 19.788 | Ipp | 3.7693 | IppL | 3.7693 | Ipp | delta | 0 | soc | 0.0825 | Vbb | 11.6819 | Vpp | 20.874 | Ipp | 0.9733 | Ipp | delta | 0 | Ibb | 1.739 | Tt/16 | 20 | Tt | 320 | Tp/16 | 11.75 | Tp | 188 | Tpe/16 | 20.9375 | Tpe | 335 | track | 2 | current | up, | ccm: | dutyChange | 1 | Tt/16 | 26.3125 | Tt | 421 | Tp/16 | 11.8125 | Tp | 189 | Tpe/16 | 21.0625 | Tpe
pwm1.current_Test:Time | 17 | target | 2 | battery_soc | 0.08 | pv_illumination | 1 | Vpp | 20.874 | Ipp | 0.9733 | IppL | 0.9733 | Ipp | delta | 0 | soc | 0.0842 | Vbb | 11.7453 | Vpp | 20.779 | Ipp | 1.2062 | Ipp | delta | -0.0124 | Ibb | 2.134 | Tt/16 | 26.3125 | Tt | 421 | Tp/16 | 11.8125 | Tp | 189 | Tpe/16 | 21.0625 | Tpe | 337 | track | 3 | current | up, | dcm: | dutyChange | 1 | Tt/16 | 20 | Tt | 320 | Tp/16 | 11.875 | Tp | 190 | Tpe/16 | 21 | Tpe
pwm1.current_Test:Time | 17.5 | target | 2 | battery_soc | 0.09 | pv_illumination | 1 | Vpp | 20.779 | Ipp | 1.2062 | IppL | 1.2186 | Ipp | delta | -0.0124 | soc | 0.0863 | Vbb | 12.2776 | Vpp | 19.782 | Ipp | 3.7873 | Ipp | delta | 0 | Ibb | 6.102 | Tt/16 | 20 | Tt | 320 | Tp/16 | 11.875 | Tp | 190 | Tpe/16 | 21 | Tpe | 336 | track | 0 | current | dn, | ccm: | dutyChange | -1 | Tt/16 | 20 | Tt | 320 | Tp/16 | 11.8125 | Tp | 189 | Tpe/16 | 21 | Tpe
pwm1.current_Test:Time | 18 | target | 2 | battery_soc | 0.09 | pv_illumination | 1 | Vpp | 19.782 | Ipp | 3.7873 | IppL | 3.7873 | Ipp | delta | 0 | soc | 0.0927 | Vbb | 11.7402 | Vpp | 20.787 | Ipp | 1.1848 | Ipp | delta | 0 | Ibb | 2.098 | Tt/16 | 20 | Tt | 320 | Tp/16 | 11.8125 | Tp | 189 | Tpe/16 | 21 | Tpe | 336 | track | 2 | current | up, | ccm: | dutyChange | 1 | Tt/16 | 20 | Tt | 320 | Tp/16 | 11.875 | Tp | 190 | Tpe/16 | 21 | Tpe
pwm1.current_Test:Time | 18.5 | target | 2 | battery_soc | 0.09 | pv_illumination | 1 | Vpp | 20.787 | Ipp | 1.1848 | IppL | 1.1848 | Ipp | delta | 0 | soc | 0.0947 | Vbb | 12.2946 | Vpp | 19.773 | Ipp | 3.8108 | Ipp | delta | 0 | Ibb | 6.129 | Tt/16 | 20 | Tt | 320 | Tp/16 | 11.875 | Tp | 190 | Tpe/16 | 21 | Tpe | 336 | track | 0 | current | dn, | ccm: | dutyChange | -1 | Tt/16 | 20 | Tt | 320 | Tp/16 | 11.8125 | Tp | 189 | Tpe/16 | 21 | Tpe
pwm1.current_Test:Time | 19 | target | 2 | battery_soc | 0.1 | pv_illumination | 1 | Vpp | 19.773 | Ipp | 3.8108 | IppL | 3.8108 | Ipp | delta | 0 | soc | 0.1011 | Vbb | 11.7373 | Vpp | 20.816 | Ipp | 1.1138 | Ipp | delta | 0 | Ibb | 1.975 | Tt/16 | 20 | Tt | 320 | Tp/16 | 11.8125 | Tp | 189 | Tpe/16 | 21 | Tpe | 336 | track | 2 | current | up, | ccm: | dutyChange | 1 | Tt/16 | 20 | Tt | 320 | Tp/16 | 11.875 | Tp | 190 | Tpe/16 | 21 | Tpe
pwm1.current_Test:Time | 19.5 | target | 2 | battery_soc | 0.1 | pv_illumination | 1 | Vpp | 20.816 | Ipp | 1.1138 | IppL | 1.1138 | Ipp | delta | 0 | soc | 0.103 | Vbb | 12.3094 | Vpp | 19.768 | Ipp | 3.8239 | Ipp | delta | 0 | Ibb | 6.141 | Tt/16 | 20 | Tt | 320 | Tp/16 | 11.875 | Tp | 190 | Tpe/16 | 21 | Tpe | 336 | track | 0 | current | dn, | ccm: | dutyChange | -1 | Tt/16 | 20 | Tt | 320 | Tp/16 | 11.8125 | Tp | 189 | Tpe/16 | 21 | Tpe
pwm1.current_Test:Time | 20 | target | 2 | battery_soc | 0.11 | pv_illumination | 1 | Vpp | 19.768 | Ipp | 3.8239 | IppL | 3.8239 | Ipp | delta | 0 | soc | 0.1095 | Vbb | 11.7364 | Vpp | 20.841 | Ipp | 1.0525 | Ipp | delta | 0 | Ibb | 1.869 | Tt/16 | 20 | Tt | 320 | Tp/16 | 11.8125 | Tp | 189 | Tpe/16 | 21 | Tpe | 336 | track | 2 | current | up, | ccm: | dutyChange | 1 | Tt/16 | 20 | Tt | 320 | Tp/16 | 11.875 | Tp | 190 | Tpe/16 | 21 | Tpe
pwm1.current_Test:Time | 20.5 | target | 2 | battery_soc | 0.11 | pv_illumination | 1 | Vpp | 20.841 | Ipp | 1.0525 | IppL | 1.0525 | Ipp | delta | 0 | soc | 0.1112 | Vbb | 12.3222 | Vpp | 19.767 | Ipp | 3.8282 | Ipp | delta | 0 | Ibb | 6.141 | Tt/16 | 20 | Tt | 320 | Tp/16 | 11.875 | Tp | 190 | Tpe/16 | 21 | Tpe | 336 | track | 0 | current | dn, | ccm: | dutyChange | -1 | Tt/16 | 20 | Tt | 320 | Tp/16 | 11.8125 | Tp | 189 | Tpe/16 | 21 | Tpe
pwm1.current_Test:Time | 21 | target | 2 | battery_soc | 0.12 | pv_illumination | 1 | Vpp | 19.767 | Ipp | 3.8282 | IppL | 3.8282 | Ipp | delta | 0 | soc | 0.1177 | Vbb | 11.7371 | Vpp | 20.863 | Ipp | 0.9995 | Ipp | delta | 0 | Ibb | 1.777 | Tt/16 | 20 | Tt | 320 | Tp/16 | 11.8125 | Tp | 189 | Tpe/16 | 21 | Tpe | 336 | track | 2 | current | up, | ccm: | dutyChange | 1 | Tt/16 | 26.3125 | Tt | 421 | Tp/16 | 11.875 | Tp | 190 | Tpe/16 | 21.0625 | Tpe
pwm1.current_Test:Time | 21.5 | target | 2 | battery_soc | 0.12 | pv_illumination | 1 | Vpp | 20.863 | Ipp | 0.9995 | IppL | 0.9995 | Ipp | delta | 0 | soc | 0.1194 | Vbb | 11.796 | Vpp | 20.777 | Ipp | 1.2113 | Ipp | delta | -0.0114 | Ibb | 2.134 | Tt/16 | 26.3125 | Tt | 421 | Tp/16 | 11.875 | Tp | 190 | Tpe/16 | 21.0625 | Tpe | 337 | track | 3 | current | up, | dcm: | dutyChange | 1 | Tt/16 | 20 | Tt | 320 | Tp/16 | 11.9375 | Tp | 191 | Tpe/16 | 21 | Tpe
pwm1.current_Test:Time | 22 | target | 2 | battery_soc | 0.12 | pv_illumination | 1 | Vpp | 20.777 | Ipp | 1.2113 | IppL | 1.2227 | Ipp | delta | -0.0114 | soc | 0.1215 | Vbb | 12.3349 | Vpp | 19.763 | Ipp | 3.8381 | Ipp | delta | 0 | Ibb | 6.149 | Tt/16 | 20 | Tt | 320 | Tp/16 | 11.9375 | Tp | 191 | Tpe/16 | 21 | Tpe | 336 | track | 0 | current | dn, | ccm: | dutyChange | -1 | Tt/16 | 20 | Tt | 320 | Tp/16 | 11.875 | Tp | 190 | Tpe/16 | 21 | Tpe
pwm1.current_Test:Time | 22.5 | target | 2 | battery_soc | 0.13 | pv_illumination | 1 | Vpp | 19.763 | Ipp | 3.8381 | IppL | 3.8381 | Ipp | delta | 0 | soc | 0.128 | Vbb | 11.7965 | Vpp | 20.775 | Ipp | 1.2166 | Ipp | delta | 0 | Ibb | 2.143 | Tt/16 | 20 | Tt | 320 | Tp/16 | 11.875 | Tp | 190 | Tpe/16 | 21 | Tpe | 336 | track | 2 | current | up, | ccm: | dutyChange | 1 | Tt/16 | 20 | Tt | 320 | Tp/16 | 11.9375 | Tp | 191 | Tpe/16 | 21 | Tpe
pwm1.current_Test:Time | 23 | target | 2 | battery_soc | 0.13 | pv_illumination | 1 | Vpp | 20.775 | Ipp | 1.2166 | IppL | 1.2166 | Ipp | delta | 0 | soc | 0.13 | Vbb | 12.3467 | Vpp | 19.764 | Ipp | 3.8359 | Ipp | delta | 0 | Ibb | 6.14 | Tt/16 | 20 | Tt | 320 | Tp/16 | 11.9375 | Tp | 191 | Tpe/16 | 21 | Tpe | 336 | track | 0 | current | dn, | ccm: | dutyChange | -1 | Tt/16 | 20 | Tt | 320 | Tp/16 | 11.875 | Tp | 190 | Tpe/16 | 21 | Tpe
pwm1.current_Test:Time | 23.5 | target | 2 | battery_soc | 0.14 | pv_illumination | 1 | Vpp | 19.764 | Ipp | 3.8359 | IppL | 3.8359 | Ipp | delta | 0 | soc | 0.1364 | Vbb | 11.7984 | Vpp | 20.794 | Ipp | 1.1677 | Ipp | delta | 0 | Ibb | 2.058 | Tt/16 | 20 | Tt | 320 | Tp/16 | 11.875 | Tp | 190 | Tpe/16 | 21 | Tpe | 336 | track | 2 | current | up, | ccm: | dutyChange | 1 | Tt/16 | 20 | Tt | 320 | Tp/16 | 11.9375 | Tp | 191 | Tpe/16 | 21 | Tpe
pwm1.current_Test:Time | 24 | target | 2 | battery_soc | 0.14 | pv_illumination | 1 | Vpp | 20.794 | Ipp | 1.1677 | IppL | 1.1677 | Ipp | delta | 0 | soc | 0.1384 | Vbb | 12.3569 | Vpp | 19.767 | Ipp | 3.827 | Ipp | delta | 0 | Ibb | 6.122 | Tt/16 | 20 | Tt | 320 | Tp/16 | 11.9375 | Tp | 191 | Tpe/16 | 21 | Tpe | 336 | track | 0 | current | dn, | ccm: | dutyChange | -1 | Tt/16 | 20 | Tt | 320 | Tp/16 | 11.875 | Tp | 190 | Tpe/16 | 21 | Tpe
pwm1.current_Test:Time | 24.5 | target | 2 | battery_soc | 0.14 | pv_illumination | 1 | Vpp | 19.767 | Ipp | 3.827 | IppL | 3.827 | Ipp | delta | 0 | soc | 0.1448 | Vbb | 11.8016 | Vpp | 20.812 | Ipp | 1.1252 | Ipp | delta | 0 | Ibb | 1.984 | Tt/16 | 20 | Tt | 320 | Tp/16 | 11.875 | Tp | 190 | Tpe/16 | 21 | Tpe | 336 | track | 2 | current | up, | ccm: | dutyChange | 1 | Tt/16 | 20 | Tt | 320 | Tp/16 | 11.9375 | Tp | 191 | Tpe/16 | 21 | Tpe
pwm1.current_Test:Time | 25 | target | 2 | battery_soc | 0.15 | pv_illumination | 1 | Vpp | 20.812 | Ipp | 1.1252 | IppL | 1.1252 | Ipp | delta | 0 | soc | 0.1467 | Vbb | 12.3659 | Vpp | 19.772 | Ipp | 3.8126 | Ipp | delta | 0 | Ibb | 6.096 | Tt/16 | 20 | Tt | 320 | Tp/16 | 11.9375 | Tp | 191 | Tpe/16 | 21 | Tpe | 336 | track | 0 | current | dn, | ccm: | dutyChange | -1 | Tt/16 | 20 | Tt | 320 | Tp/16 | 11.875 | Tp | 190 | Tpe/16 | 21 | Tpe
pwm1.current_Test:Time | 25.5 | target | 2 | battery_soc | 0.15 | pv_illumination | 1 | Vpp | 19.772 | Ipp | 3.8126 | IppL | 3.8126 | Ipp | delta | 0 | soc | 0.1531 | Vbb | 11.8057 | Vpp | 20.827 | Ipp | 1.088 | Ipp | delta | 0 | Ibb | 1.919 | Tt/16 | 20 | Tt | 320 | Tp/16 | 11.875 | Tp | 190 | Tpe/16 | 21 | Tpe | 336 | track | 2 | current | up, | ccm: | dutyChange | 1 | Tt/16 | 20 | Tt | 320 | Tp/16 | 11.9375 | Tp | 191 | Tpe/16 | 21 | Tpe
pwm1.current_Test:Time | 26 | target | 2 | battery_soc | 0.15 | pv_illumination | 1 | Vpp | 20.827 | Ipp | 1.088 | IppL | 1.088 | Ipp | delta | 0 | soc | 0.1549 | Vbb | 12.3738 | Vpp | 19.779 | Ipp | 3.7938 | Ipp | delta | 0 | Ibb | 6.064 | Tt/16 | 20 | Tt | 320 | Tp/16 | 11.9375 | Tp | 191 | Tpe/16 | 21 | Tpe | 336 | track | 0 | current | dn, | ccm: | dutyChange | -1 | Tt/16 | 20 | Tt | 320 | Tp/16 | 11.875 | Tp | 190 | Tpe/16 | 21 | Tpe
pwm1.current_Test:Time | 26.5 | target | 2 | battery_soc | 0.16 | pv_illumination | 1 | Vpp | 19.779 | Ipp | 3.7938 | IppL | 3.7938 | Ipp | delta | 0 | soc | 0.1613 | Vbb | 11.8107 | Vpp | 20.84 | Ipp | 1.0553 | Ipp | delta | 0 | Ibb | 1.862 | Tt/16 | 20 | Tt | 320 | Tp/16 | 11.875 | Tp | 190 | Tpe/16 | 21 | Tpe | 336 | track | 2 | current | up, | ccm: | dutyChange | 1 | Tt/16 | 20 | Tt | 320 | Tp/16 | 11.9375 | Tp | 191 | Tpe/16 | 21 | Tpe
pwm1.current_Test:Time | 27 | target | 2 | battery_soc | 0.16 | pv_illumination | 1 | Vpp | 20.84 | Ipp | 1.0553 | IppL | 1.0553 | Ipp | delta | 0 | soc | 0.1631 | Vbb | 12.3809 | Vpp | 19.788 | Ipp | 3.7712 | Ipp | delta | 0 | Ibb | 6.027 | Tt/16 | 20 | Tt | 320 | Tp/16 | 11.9375 | Tp | 191 | Tpe/16 | 21 | Tpe | 336 | track | 0 | current | dn, | ccm: | dutyChange | -1 | Tt/16 | 20 | Tt | 320 | Tp/16 | 11.875 | Tp | 190 | Tpe/16 | 21 | Tpe
pwm1.current_Test:Time | 27.5 | target | 2 | battery_soc | 0.17 | pv_illumination | 1 | Vpp | 19.788 | Ipp | 3.7712 | IppL | 3.7712 | Ipp | delta | 0 | soc | 0.1694 | Vbb | 11.8163 | Vpp | 20.852 | Ipp | 1.0263 | Ipp | delta | 0 | Ibb | 1.811 | Tt/16 | 20 | Tt | 320 | Tp/16 | 11.875 | Tp | 190 | Tpe/16 | 21 | Tpe | 336 | track | 2 | current | up, | ccm: | dutyChange | 1 | Tt/16 | 20 | Tt | 320 | Tp/16 | 11.9375 | Tp | 191 | Tpe/16 | 21 | Tpe
pwm1.current_Test:Time | 28 | target | 2 | battery_soc | 0.17 | pv_illumination | 1 | Vpp | 20.852 | Ipp | 1.0263 | IppL | 1.0263 | Ipp | delta | 0 | soc | 0.1711 | Vbb | 12.3872 | Vpp | 19.797 | Ipp | 3.7458 | Ipp | delta | 0 | Ibb | 5.986 | Tt/16 | 20 | Tt | 320 | Tp/16 | 11.9375 | Tp | 191 | Tpe/16 | 21 | Tpe | 336 | track | 0 | current | dn, | ccm: | dutyChange | -1 | Tt/16 | 20 | Tt | 320 | Tp/16 | 11.875 | Tp | 190 | Tpe/16 | 21 | Tpe
pwm1.current_Test:Time | 28.5 | target | 2 | battery_soc | 0.18 | pv_illumination | 1 | Vpp | 19.797 | Ipp | 3.7458 | IppL | 3.7458 | Ipp | delta | 0 | soc | 0.1774 | Vbb | 11.8224 | Vpp | 20.863 | Ipp | 1.0004 | Ipp | delta | 0 | Ibb | 1.765 | Tt/16 | 20 | Tt | 320 | Tp/16 | 11.875 | Tp | 190 | Tpe/16 | 21 | Tpe | 336 | track | 2 | current | up, | ccm: | dutyChange | 1 | Tt/16 | 26.3125 | Tt | 421 | Tp/16 | 11.9375 | Tp | 191 | Tpe/16 | 21.0625 | Tpe
pwm1.current_Test:Time | 29 | target | 2 | battery_soc | 0.18 | pv_illumination | 1 | Vpp | 20.863 | Ipp | 1.0004 | IppL | 1.0004 | Ipp | delta | 0 | soc | 0.1791 | Vbb | 11.8805 | Vpp | 20.776 | Ipp | 1.2124 | Ipp | delta | -0.0116 | Ibb | 2.12 | Tt/16 | 26.3125 | Tt | 421 | Tp/16 | 11.9375 | Tp | 191 | Tpe/16 | 21.0625 | Tpe | 337 | track | 3 | current | up, | dcm: | dutyChange | 1 | Tt/16 | 20 | Tt | 320 | Tp/16 | 12 | Tp | 192 | Tpe/16 | 20.9375 | Tpe
pwm1.current_Test:Time | 29.5 | target | 2 | battery_soc | 0.18 | pv_illumination | 1 | Vpp | 20.776 | Ipp | 1.2124 | IppL | 1.224 | Ipp | delta | -0.0116 | soc | 0.1812 | Vbb | 12.3954 | Vpp | 19.801 | Ipp | 3.7349 | Ipp | delta | 0 | Ibb | 5.966 | Tt/16 | 20 | Tt | 320 | Tp/16 | 12 | Tp | 192 | Tpe/16 | 20.9375 | Tpe | 335 | track | 0 | current | dn, | ccm: | dutyChange | -1 | Tt/16 | 20 | Tt | 320 | Tp/16 | 11.9375 | Tp | 191 | Tpe/16 | 20.9375 | Tpe
pwm1.current_Test:Time | 30 | target | 2 | battery_soc | 0.19 | pv_illumination | 1 | Vpp | 19.801 | Ipp | 3.7349 | IppL | 3.7349 | Ipp | delta | 0 | soc | 0.1874 | Vbb | 11.8849 | Vpp | 20.767 | Ipp | 1.2348 | Ipp | delta | 0 | Ibb | 2.158 | Tt/16 | 20 | Tt | 320 | Tp/16 | 11.9375 | Tp | 191 | Tpe/16 | 20.9375 | Tpe | 335 | track | 2 | current | up, | ccm: | dutyChange | 1 | Tt/16 | 20 | Tt | 320 | Tp/16 | 12 | Tp | 192 | Tpe/16 | 20.9375 | Tpe
pwm1.current_Test:Time | 30.5 | target | 2 | battery_soc | 0.19 | pv_illumination | 1 | Vpp | 20.767 | Ipp | 1.2348 | IppL | 1.2348 | Ipp | delta | 0 | soc | 0.1895 | Vbb | 12.4033 | Vpp | 19.808 | Ipp | 3.7154 | Ipp | delta | 0 | Ibb | 5.934 | Tt/16 | 20 | Tt | 320 | Tp/16 | 12 | Tp | 192 | Tpe/16 | 20.9375 | Tpe | 335 | track | 0 | current | dn, | ccm: | dutyChange | -1 | Tt/16 | 20 | Tt | 320 | Tp/16 | 11.9375 | Tp | 191 | Tpe/16 | 20.9375 | Tpe
pwm1.current_Test:Time | 31 | target | 2 | battery_soc | 0.2 | pv_illumination | 1 | Vpp | 19.808 | Ipp | 3.7154 | IppL | 3.7154 | Ipp | delta | 0 | soc | 0.1957 | Vbb | 11.8899 | Vpp | 20.78 | Ipp | 1.2021 | Ipp | delta | 0 | Ibb | 2.101 | Tt/16 | 20 | Tt | 320 | Tp/16 | 11.9375 | Tp | 191 | Tpe/16 | 20.9375 | Tpe | 335 | track | 2 | current | up, | ccm: | dutyChange | 1 | Tt/16 | 20 | Tt | 320 | Tp/16 | 12 | Tp | 192 | Tpe/16 | 20.9375 | Tpe
pwm1.current_Test:Time | 31.5 | target | 2 | battery_soc | 0.2 | pv_illumination | 1 | Vpp | 20.78 | Ipp | 1.2021 | IppL | 1.2021 | Ipp | delta | 0 | soc | 0.1977 | Vbb | 12.4104 | Vpp | 19.817 | Ipp | 3.6924 | Ipp | delta | 0 | Ibb | 5.896 | Tt/16 | 20 | Tt | 320 | Tp/16 | 12 | Tp | 192 | Tpe/16 | 20.9375 | Tpe | 335 | track | 0 | current | dn, | ccm: | dutyChange | -1 | Tt/16 | 20 | Tt | 320 | Tp/16 | 11.9375 | Tp | 191 | Tpe/16 | 20.9375 | Tpe
pwm1.current_Test:Time | 32 | target | 2 | battery_soc | 0.2 | pv_illumination | 1 | Vpp | 19.817 | Ipp | 3.6924 | IppL | 3.6924 | Ipp | delta | 0 | soc | 0.2038 | Vbb | 11.8956 | Vpp | 20.792 | Ipp | 1.173 | Ipp | delta | 0 | Ibb | 2.05 | Tt/16 | 20 | Tt | 320 | Tp/16 | 11.9375 | Tp | 191 | Tpe/16 | 20.9375 | Tpe | 335 | track | 2 | current | up, | ccm: | dutyChange | 1 | Tt/16 | 20 | Tt | 320 | Tp/16 | 12 | Tp | 192 | Tpe/16 | 20.9375 | Tpe
pwm1.current_Test:Time | 32.5 | target | 2 | battery_soc | 0.21 | pv_illumination | 1 | Vpp | 20.792 | Ipp | 1.173 | IppL | 1.173 | Ipp | delta | 0 | soc | 0.2058 | Vbb | 12.4167 | Vpp | 19.826 | Ipp | 3.6667 | Ipp | delta | 0 | Ibb | 5.855 | Tt/16 | 20 | Tt | 320 | Tp/16 | 12 | Tp | 192 | Tpe/16 | 20.9375 | Tpe | 335 | track | 0 | current | dn, | ccm: | dutyChange | -1 | Tt/16 | 20 | Tt | 320 | Tp/16 | 11.9375 | Tp | 191 | Tpe/16 | 20.9375 | Tpe
pwm1.current_Test:Time | 33 | target | 2 | battery_soc | 0.21 | pv_illumination | 1 | Vpp | 19.826 | Ipp | 3.6667 | IppL | 3.6667 | Ipp | delta | 0 | soc | 0.2119 | Vbb | 11.9018 | Vpp | 20.803 | Ipp | 1.1467 | Ipp | delta | 0 | Ibb | 2.004 | Tt/16 | 20 | Tt | 320 | Tp/16 | 11.9375 | Tp | 191 | Tpe/16 | 20.9375 | Tpe | 335 | track | 2 | current | up, | ccm: | dutyChange | 1 | Tt/16 | 20 | Tt | 320 | Tp/16 | 12 | Tp | 192 | Tpe/16 | 20.9375 | Tpe
pwm1.current_Test:Time | 33.5 | target | 2 | battery_soc | 0.21 | pv_illumination | 1 | Vpp | 20.803 | Ipp | 1.1467 | IppL | 1.1467 | Ipp | delta | 0 | soc | 0.2138 | Vbb | 12.4225 | Vpp | 19.836 | Ipp | 3.6389 | Ipp | delta | 0 | Ibb | 5.811 | Tt/16 | 20 | Tt | 320 | Tp/16 | 12 | Tp | 192 | Tpe/16 | 20.9375 | Tpe | 335 | track | 0 | current | dn, | ccm: | dutyChange | -1 | Tt/16 | 20 | Tt | 320 | Tp/16 | 11.9375 | Tp | 191 | Tpe/16 | 20.9375 | Tpe
pwm1.current_Test:Time | 34 | target | 2 | battery_soc | 0.22 | pv_illumination | 1 | Vpp | 19.836 | Ipp | 3.6389 | IppL | 3.6389 | Ipp | delta | 0 | soc | 0.2199 | Vbb | 11.9083 | Vpp | 20.813 | Ipp | 1.1228 | Ipp | delta | 0 | Ibb | 1.962 | Tt/16 | 20 | Tt | 320 | Tp/16 | 11.9375 | Tp | 191 | Tpe/16 | 20.9375 | Tpe | 335 | track | 2 | current | up, | ccm: | dutyChange | 1 | Tt/16 | 20 | Tt | 320 | Tp/16 | 12 | Tp | 192 | Tpe/16 | 20.9375 | Tpe
pwm1.current_Test:Time | 34.5 | target | 2 | battery_soc | 0.22 | pv_illumination | 1 | Vpp | 20.813 | Ipp | 1.1228 | IppL | 1.1228 | Ipp | delta | 0 | soc | 0.2218 | Vbb | 12.4279 | Vpp | 19.847 | Ipp | 3.6095 | Ipp | delta | 0 | Ibb | 5.764 | Tt/16 | 20 | Tt | 320 | Tp/16 | 12 | Tp | 192 | Tpe/16 | 20.9375 | Tpe | 335 | track | 0 | current | dn, | ccm: | dutyChange | -1 | Tt/16 | 20 | Tt | 320 | Tp/16 | 11.9375 | Tp | 191 | Tpe/16 | 20.9375 | Tpe
pwm1.current_Test:Time | 35 | target | 2 | battery_soc | 0.23 | pv_illumination | 1 | Vpp | 19.847 | Ipp | 3.6095 | IppL | 3.6095 | Ipp | delta | 0 | soc | 0.2278 | Vbb | 11.9151 | Vpp | 20.822 | Ipp | 1.1008 | Ipp | delta | 0 | Ibb | 1.924 | Tt/16 | 20 | Tt | 320 | Tp/16 | 11.9375 | Tp | 191 | Tpe/16 | 20.9375 | Tpe | 335 | track | 2 | current | up, | ccm: | dutyChange | 1 | Tt/16 | 20 | Tt | 320 | Tp/16 | 12 | Tp | 192 | Tpe/16 | 20.9375 | Tpe
pwm1.current_Test:Time | 35.5 | target | 2 | battery_soc | 0.23 | pv_illumination | 1 | Vpp | 20.822 | Ipp | 1.1008 | IppL | 1.1008 | Ipp | delta | 0 | soc | 0.2296 | Vbb | 12.4329 | Vpp | 19.859 | Ipp | 3.5789 | Ipp | delta | 0 | Ibb | 5.716 | Tt/16 | 20 | Tt | 320 | Tp/16 | 12 | Tp | 192 | Tpe/16 | 20.9375 | Tpe | 335 | track | 0 | current | dn, | ccm: | dutyChange | -1 | Tt/16 | 20 | Tt | 320 | Tp/16 | 11.9375 | Tp | 191 | Tpe/16 | 20.9375 | Tpe
pwm1.current_Test:Time | 36 | target | 2 | battery_soc | 0.24 | pv_illumination | 1 | Vpp | 19.859 | Ipp | 3.5789 | IppL | 3.5789 | Ipp | delta | 0 | soc | 0.2356 | Vbb | 11.9221 | Vpp | 20.83 | Ipp | 1.0803 | Ipp | delta | 0 | Ibb | 1.887 | Tt/16 | 20 | Tt | 320 | Tp/16 | 11.9375 | Tp | 191 | Tpe/16 | 20.9375 | Tpe | 335 | track | 2 | current | up, | ccm: | dutyChange | 1 | Tt/16 | 20 | Tt | 320 | Tp/16 | 12 | Tp | 192 | Tpe/16 | 20.9375 | Tpe
pwm1.current_Test:Time | 36.5 | target | 2 | battery_soc | 0.24 | pv_illumination | 1 | Vpp | 20.83 | Ipp | 1.0803 | IppL | 1.0803 | Ipp | delta | 0 | soc | 0.2374 | Vbb | 12.4376 | Vpp | 19.87 | Ipp | 3.5475 | Ipp | delta | 0 | Ibb | 5.667 | Tt/16 | 20 | Tt | 320 | Tp/16 | 12 | Tp | 192 | Tpe/16 | 20.9375 | Tpe | 335 | track | 0 | current | dn, | ccm: | dutyChange | -1 | Tt/16 | 20 | Tt | 320 | Tp/16 | 11.9375 | Tp | 191 | Tpe/16 | 20.9375 | Tpe
pwm1.current_Test:Time | 37 | target | 2 | battery_soc | 0.24 | pv_illumination | 1 | Vpp | 19.87 | Ipp | 3.5475 | IppL | 3.5475 | Ipp | delta | 0 | soc | 0.2433 | Vbb | 11.9293 | Vpp | 20.838 | Ipp | 1.0611 | Ipp | delta | 0 | Ibb | 1.853 | Tt/16 | 20 | Tt | 320 | Tp/16 | 11.9375 | Tp | 191 | Tpe/16 | 20.9375 | Tpe | 335 | track | 2 | current | up, | ccm: | dutyChange | 1 | Tt/16 | 20 | Tt | 320 | Tp/16 | 12 | Tp | 192 | Tpe/16 | 20.9375 | Tpe
pwm1.current_Test:Time | 37.5 | target | 2 | battery_soc | 0.25 | pv_illumination | 1 | Vpp | 20.838 | Ipp | 1.0611 | IppL | 1.0611 | Ipp | delta | 0 | soc | 0.2451 | Vbb | 12.442 | Vpp | 19.882 | Ipp | 3.5155 | Ipp | delta | 0 | Ibb | 5.618 | Tt/16 | 20 | Tt | 320 | Tp/16 | 12 | Tp | 192 | Tpe/16 | 20.9375 | Tpe | 335 | track | 0 | current | dn, | ccm: | dutyChange | -1 | Tt/16 | 20 | Tt | 320 | Tp/16 | 11.9375 | Tp | 191 | Tpe/16 | 20.9375 | Tpe
pwm1.current_Test:Time | 38 | target | 2 | battery_soc | 0.25 | pv_illumination | 1 | Vpp | 19.882 | Ipp | 3.5155 | IppL | 3.5155 | Ipp | delta | 0 | soc | 0.251 | Vbb | 11.9365 | Vpp | 20.845 | Ipp | 1.0428 | Ipp | delta | 0 | Ibb | 1.821 | Tt/16 | 20 | Tt | 320 | Tp/16 | 11.9375 | Tp | 191 | Tpe/16 | 20.9375 | Tpe | 335 | track | 2 | current | up, | ccm: | dutyChange | 1 | Tt/16 | 20 | Tt | 320 | Tp/16 | 12 | Tp | 192 | Tpe/16 | 20.9375 | Tpe
pwm1.current_Test:Time | 38.5 | target | 2 | battery_soc | 0.25 | pv_illumination | 1 | Vpp | 20.845 | Ipp | 1.0428 | IppL | 1.0428 | Ipp | delta | 0 | soc | 0.2527 | Vbb | 12.4463 | Vpp | 19.894 | Ipp | 3.4832 | Ipp | delta | 0 | Ibb | 5.568 | Tt/16 | 20 | Tt | 320 | Tp/16 | 12 | Tp | 192 | Tpe/16 | 20.9375 | Tpe | 335 | track | 0 | current | dn, | ccm: | dutyChange | -1 | Tt/16 | 20 | Tt | 320 | Tp/16 | 11.9375 | Tp | 191 | Tpe/16 | 20.9375 | Tpe
pwm1.current_Test:Time | 39 | target | 2 | battery_soc | 0.26 | pv_illumination | 1 | Vpp | 19.894 | Ipp | 3.4832 | IppL | 3.4832 | Ipp | delta | 0 | soc | 0.2585 | Vbb | 11.9437 | Vpp | 20.852 | Ipp | 1.0254 | Ipp | delta | 0 | Ibb | 1.79 | Tt/16 | 20 | Tt | 320 | Tp/16 | 11.9375 | Tp | 191 | Tpe/16 | 20.9375 | Tpe | 335 | track | 2 | current | up, | ccm: | dutyChange | 1 | Tt/16 | 20 | Tt | 320 | Tp/16 | 12 | Tp | 192 | Tpe/16 | 20.9375 | Tpe
pwm1.current_Test:Time | 39.5 | target | 2 | battery_soc | 0.26 | pv_illumination | 1 | Vpp | 20.852 | Ipp | 1.0254 | IppL | 1.0254 | Ipp | delta | 0 | soc | 0.2602 | Vbb | 12.4504 | Vpp | 19.906 | Ipp | 3.4507 | Ipp | delta | 0 | Ibb | 5.517 | Tt/16 | 20 | Tt | 320 | Tp/16 | 12 | Tp | 192 | Tpe/16 | 20.9375 | Tpe | 335 | track | 0 | current | dn, | ccm: | dutyChange | -1 | Tt/16 | 20 | Tt | 320 | Tp/16 | 11.9375 | Tp | 191 | Tpe/16 | 20.9375 | Tpe
pwm1.current_Test:Time | 40 | target | 2 | battery_soc | 0.27 | pv_illumination | 1 | Vpp | 19.906 | Ipp | 3.4507 | IppL | 3.4507 | Ipp | delta | 0 | soc | 0.266 | Vbb | 11.951 | Vpp | 20.859 | Ipp | 1.0086 | Ipp | delta | 0 | Ibb | 1.76 | Tt/16 | 20 | Tt | 320 | Tp/16 | 11.9375 | Tp | 191 | Tpe/16 | 20.9375 | Tpe | 335 | track | 2 | current | up, | ccm: | dutyChange | 1 | Tt/16 | 26.125 | Tt | 418 | Tp/16 | 12 | Tp | 192 | Tpe/16 | 20.9375 | Tpe
pwm1.current_Test:Time | 40.5 | target | 2 | battery_soc | 0.27 | pv_illumination | 1 | Vpp | 20.859 | Ipp | 1.0086 | IppL | 1.0086 | Ipp | delta | 0 | soc | 0.2677 | Vbb | 12.0064 | Vpp | 20.775 | Ipp | 1.2161 | Ipp | delta | -0.0115 | Ibb | 2.104 | Tt/16 | 26.125 | Tt | 418 | Tp/16 | 12 | Tp | 192 | Tpe/16 | 20.9375 | Tpe | 335 | track | 3 | current | up, | dcm: | dutyChange | 1 | Tt/16 | 20 | Tt | 320 | Tp/16 | 12.0625 | Tp | 193 | Tpe/16 | 20.8125 | Tpe
pwm1.current_Test:Time | 41 | target | 2 | battery_soc | 0.27 | pv_illumination | 1 | Vpp | 20.775 | Ipp | 1.2161 | IppL | 1.2275 | Ipp | delta | -0.0115 | soc | 0.2698 | Vbb | 12.4599 | Vpp | 19.907 | Ipp | 3.4484 | Ipp | delta | 0 | Ibb | 5.509 | Tt/16 | 20 | Tt | 320 | Tp/16 | 12.0625 | Tp | 193 | Tpe/16 | 20.8125 | Tpe | 333 | track | 0 | current | dn, | ccm: | dutyChange | -1 | Tt/16 | 20 | Tt | 320 | Tp/16 | 12 | Tp | 192 | Tpe/16 | 20.8125 | Tpe
pwm1.current_Test:Time | 41.5 | target | 2 | battery_soc | 0.28 | pv_illumination | 1 | Vpp | 19.907 | Ipp | 3.4484 | IppL | 3.4484 | Ipp | delta | 0 | soc | 0.2755 | Vbb | 12.0111 | Vpp | 20.767 | Ipp | 1.2362 | Ipp | delta | 0 | Ibb | 2.137 | Tt/16 | 20 | Tt | 320 | Tp/16 | 12 | Tp | 192 | Tpe/16 | 20.8125 | Tpe | 333 | track | 2 | current | up, | ccm: | dutyChange | 1 | Tt/16 | 20 | Tt | 320 | Tp/16 | 12.0625 | Tp | 193 | Tpe/16 | 20.8125 | Tpe
pwm1.current_Test:Time | 42 | target | 2 | battery_soc | 0.28 | pv_illumination | 1 | Vpp | 20.767 | Ipp | 1.2362 | IppL | 1.2362 | Ipp | delta | 0 | soc | 0.2776 | Vbb | 12.4669 | Vpp | 19.915 | Ipp | 3.4279 | Ipp | delta | 0 | Ibb | 5.476 | Tt/16 | 20 | Tt | 320 | Tp/16 | 12.0625 | Tp | 193 | Tpe/16 | 20.8125 | Tpe | 333 | track | 0 | current | dn, | ccm: | dutyChange | -1 | Tt/16 | 20 | Tt | 320 | Tp/16 | 12 | Tp | 192 | Tpe/16 | 20.8125 | Tpe
pwm1.current_Test:Time | 42.5 | target | 2 | battery_soc | 0.28 | pv_illumination | 1 | Vpp | 19.915 | Ipp | 3.4279 | IppL | 3.4279 | Ipp | delta | 0 | soc | 0.2833 | Vbb | 12.0163 | Vpp | 20.778 | Ipp | 1.2075 | Ipp | delta | 0 | Ibb | 2.088 | Tt/16 | 20 | Tt | 320 | Tp/16 | 12 | Tp | 192 | Tpe/16 | 20.8125 | Tpe | 333 | track | 2 | current | up, | ccm: | dutyChange | 1 | Tt/16 | 20 | Tt | 320 | Tp/16 | 12.0625 | Tp | 193 | Tpe/16 | 20.8125 | Tpe
pwm1.current_Test:Time | 43 | target | 2 | battery_soc | 0.29 | pv_illumination | 1 | Vpp | 20.778 | Ipp | 1.2075 | IppL | 1.2075 | Ipp | delta | 0 | soc | 0.2853 | Vbb | 12.4733 | Vpp | 19.923 | Ipp | 3.4047 | Ipp | delta | 0 | Ibb | 5.438 | Tt/16 | 20 | Tt | 320 | Tp/16 | 12.0625 | Tp | 193 | Tpe/16 | 20.8125 | Tpe | 333 | track | 0 | current | dn, | ccm: | dutyChange | -1 | Tt/16 | 20 | Tt | 320 | Tp/16 | 12 | Tp | 192 | Tpe/16 | 20.8125 | Tpe
pwm1.current_Test:Time | 43.5 | target | 2 | battery_soc | 0.29 | pv_illumination | 1 | Vpp | 19.923 | Ipp | 3.4047 | IppL | 3.4047 | Ipp | delta | 0 | soc | 0.2909 | Vbb | 12.0219 | Vpp | 20.789 | Ipp | 1.1815 | Ipp | delta | 0 | Ibb | 2.043 | Tt/16 | 20 | Tt | 320 | Tp/16 | 12 | Tp | 192 | Tpe/16 | 20.8125 | Tpe | 333 | track | 2 | current | up, | ccm: | dutyChange | 1 | Tt/16 | 20 | Tt | 320 | Tp/16 | 12.0625 | Tp | 193 | Tpe/16 | 20.8125 | Tpe
pwm1.current_Test:Time | 44 | target | 2 | battery_soc | 0.29 | pv_illumination | 1 | Vpp | 20.789 | Ipp | 1.1815 | IppL | 1.1815 | Ipp | delta | 0 | soc | 0.2929 | Vbb | 12.479 | Vpp | 19.933 | Ipp | 3.3796 | Ipp | delta | 0 | Ibb | 5.398 | Tt/16 | 20 | Tt | 320 | Tp/16 | 12.0625 | Tp | 193 | Tpe/16 | 20.8125 | Tpe | 333 | track | 0 | current | dn, | ccm: | dutyChange | -1 | Tt/16 | 20 | Tt | 320 | Tp/16 | 12 | Tp | 192 | Tpe/16 | 20.8125 | Tpe
pwm1.current_Test:Time | 44.5 | target | 2 | battery_soc | 0.3 | pv_illumination | 1 | Vpp | 19.933 | Ipp | 3.3796 | IppL | 3.3796 | Ipp | delta | 0 | soc | 0.2985 | Vbb | 12.0279 | Vpp | 20.798 | Ipp | 1.1577 | Ipp | delta | 0 | Ibb | 2.002 | Tt/16 | 20 | Tt | 320 | Tp/16 | 12 | Tp | 192 | Tpe/16 | 20.8125 | Tpe | 333 | track | 2 | current | up, | ccm: | dutyChange | 1 | Tt/16 | 20 | Tt | 320 | Tp/16 | 12.0625 | Tp | 193 | Tpe/16 | 20.8125 | Tpe
pwm1.current_Test:Time | 45 | target | 2 | battery_soc | 0.3 | pv_illumination | 1 | Vpp | 20.798 | Ipp | 1.1577 | IppL | 1.1577 | Ipp | delta | 0 | soc | 0.3004 | Vbb | 12.4844 | Vpp | 19.943 | Ipp | 3.353 | Ipp | delta | 0 | Ibb | 5.356 | Tt/16 | 20 | Tt | 320 | Tp/16 | 12.0625 | Tp | 193 | Tpe/16 | 20.8125 | Tpe | 333 | track | 0 | current | dn, | ccm: | dutyChange | -1 | Tt/16 | 20 | Tt | 320 | Tp/16 | 12 | Tp | 192 | Tpe/16 | 20.8125 | Tpe
pwm1.current_Test:Time | 45.5 | target | 2 | battery_soc | 0.31 | pv_illumination | 1 | Vpp | 19.943 | Ipp | 3.353 | IppL | 3.353 | Ipp | delta | 0 | soc | 0.306 | Vbb | 12.0341 | Vpp | 20.807 | Ipp | 1.1357 | Ipp | delta | 0 | Ibb | 1.964 | Tt/16 | 20 | Tt | 320 | Tp/16 | 12 | Tp | 192 | Tpe/16 | 20.8125 | Tpe | 333 | track | 2 | current | up, | ccm: | dutyChange | 1 | Tt/16 | 20 | Tt | 320 | Tp/16 | 12.0625 | Tp | 193 | Tpe/16 | 20.8125 | Tpe
pwm1.current_Test:Time | 46 | target | 2 | battery_soc | 0.31 | pv_illumination | 1 | Vpp | 20.807 | Ipp | 1.1357 | IppL | 1.1357 | Ipp | delta | 0 | soc | 0.3079 | Vbb | 12.4895 | Vpp | 19.953 | Ipp | 3.3254 | Ipp | delta | 0 | Ibb | 5.313 | Tt/16 | 20 | Tt | 320 | Tp/16 | 12.0625 | Tp | 193 | Tpe/16 | 20.8125 | Tpe | 333 | track | 0 | current | dn, | ccm: | dutyChange | -1 | Tt/16 | 20 | Tt | 320 | Tp/16 | 12 | Tp | 192 | Tpe/16 | 20.8125 | Tpe
pwm1.current_Test:Time | 46.5 | target | 2 | battery_soc | 0.31 | pv_illumination | 1 | Vpp | 19.953 | Ipp | 3.3254 | IppL | 3.3254 | Ipp | delta | 0 | soc | 0.3134 | Vbb | 12.0405 | Vpp | 20.816 | Ipp | 1.1151 | Ipp | delta | 0 | Ibb | 1.928 | Tt/16 | 20 | Tt | 320 | Tp/16 | 12 | Tp | 192 | Tpe/16 | 20.8125 | Tpe | 333 | track | 2 | current | up, | ccm: | dutyChange | 1 | Tt/16 | 20 | Tt | 320 | Tp/16 | 12.0625 | Tp | 193 | Tpe/16 | 20.8125 | Tpe
pwm1.current_Test:Time | 47 | target | 2 | battery_soc | 0.32 | pv_illumination | 1 | Vpp | 20.816 | Ipp | 1.1151 | IppL | 1.1151 | Ipp | delta | 0 | soc | 0.3152 | Vbb | 12.4942 | Vpp | 19.964 | Ipp | 3.2971 | Ipp | delta | 0 | Ibb | 5.268 | Tt/16 | 20 | Tt | 320 | Tp/16 | 12.0625 | Tp | 193 | Tpe/16 | 20.8125 | Tpe | 333 | track | 0 | current | dn, | ccm: | dutyChange | -1 | Tt/16 | 20 | Tt | 320 | Tp/16 | 12 | Tp | 192 | Tpe/16 | 20.8125 | Tpe
pwm1.current_Test:Time | 47.5 | target | 2 | battery_soc | 0.32 | pv_illumination | 1 | Vpp | 19.964 | Ipp | 3.2971 | IppL | 3.2971 | Ipp | delta | 0 | soc | 0.3207 | Vbb | 12.047 | Vpp | 20.824 | Ipp | 1.0956 | Ipp | delta | 0 | Ibb | 1.894 | Tt/16 | 20 | Tt | 320 | Tp/16 | 12 | Tp | 192 | Tpe/16 | 20.8125 | Tpe | 333 | track | 2 | current | up, | ccm: | dutyChange | 1 | Tt/16 | 20 | Tt | 320 | Tp/16 | 12.0625 | Tp | 193 | Tpe/16 | 20.8125 | Tpe
pwm1.current_Test:Time | 48 | target | 2 | battery_soc | 0.32 | pv_illumination | 1 | Vpp | 20.824 | Ipp | 1.0956 | IppL | 1.0956 | Ipp | delta | 0 | soc | 0.3225 | Vbb | 12.4988 | Vpp | 19.974 | Ipp | 3.2682 | Ipp | delta | 0 | Ibb | 5.223 | Tt/16 | 20 | Tt | 320 | Tp/16 | 12.0625 | Tp | 193 | Tpe/16 | 20.8125 | Tpe | 333 | track | 0 | current | dn, | ccm: | dutyChange | -1 | Tt/16 | 20 | Tt | 320 | Tp/16 | 12 | Tp | 192 | Tpe/16 | 20.8125 | Tpe
pwm1.current_Test:Time | 48.5 | target | 2 | battery_soc | 0.33 | pv_illumination | 1 | Vpp | 19.974 | Ipp | 3.2682 | IppL | 3.2682 | Ipp | delta | 0 | soc | 0.328 | Vbb | 12.0536 | Vpp | 20.831 | Ipp | 1.0769 | Ipp | delta | 0 | Ibb | 1.861 | Tt/16 | 20 | Tt | 320 | Tp/16 | 12 | Tp | 192 | Tpe/16 | 20.8125 | Tpe | 333 | track | 2 | current | up, | ccm: | dutyChange | 1 | Tt/16 | 20 | Tt | 320 | Tp/16 | 12.0625 | Tp | 193 | Tpe/16 | 20.8125 | Tpe
pwm1.current_Test:Time | 49 | target | 2 | battery_soc | 0.33 | pv_illumination | 1 | Vpp | 20.831 | Ipp | 1.0769 | IppL | 1.0769 | Ipp | delta | 0 | soc | 0.3297 | Vbb | 12.5032 | Vpp | 19.985 | Ipp | 3.2392 | Ipp | delta | 0 | Ibb | 5.178 | Tt/16 | 20 | Tt | 320 | Tp/16 | 12.0625 | Tp | 193 | Tpe/16 | 20.8125 | Tpe | 333 | track | 0 | current | dn, | ccm: | dutyChange | -1 | Tt/16 | 20 | Tt | 320 | Tp/16 | 12 | Tp | 192 | Tpe/16 | 20.8125 | Tpe
pwm1.current_Test:Time | 49.5 | target | 2 | battery_soc | 0.34 | pv_illumination | 1 | Vpp | 19.985 | Ipp | 3.2392 | IppL | 3.2392 | Ipp | delta | 0 | soc | 0.3351 | Vbb | 12.0602 | Vpp | 20.839 | Ipp | 1.059 | Ipp | delta | 0 | Ibb | 1.83 | Tt/16 | 20 | Tt | 320 | Tp/16 | 12 | Tp | 192 | Tpe/16 | 20.8125 | Tpe | 333 | track | 2 | current | up, | ccm: | dutyChange | 1 | Tt/16 | 20 | Tt | 320 | Tp/16 | 12.0625 | Tp | 193 | Tpe/16 | 20.8125 | Tpe
pwm1.current_Test:Time | 50 | target | 2 | battery_soc | 0.34 | pv_illumination | 1 | Vpp | 20.839 | Ipp | 1.059 | IppL | 1.059 | Ipp | delta | 0 | soc | 0.3369 | Vbb | 12.5074 | Vpp | 19.996 | Ipp | 3.21 | Ipp | delta | 0 | Ibb | 5.132 | Tt/16 | 20 | Tt | 320 | Tp/16 | 12.0625 | Tp | 193 | Tpe/16 | 20.8125 | Tpe | 333 | track | 0 | current | dn, | ccm: | dutyChange | -1 | Tt/16 | 20 | Tt | 320 | Tp/16 | 12 | Tp | 192 | Tpe/16 | 20.8125 | Tpe
pwm1.current_Test:Time | 50.5 | target | 2 | battery_soc | 0.34 | pv_illumination | 1 | Vpp | 19.996 | Ipp | 3.21 | IppL | 3.21 | Ipp | delta | 0 | soc | 0.3422 | Vbb | 12.0669 | Vpp | 20.846 | Ipp | 1.0416 | Ipp | delta | 0 | Ibb | 1.799 | Tt/16 | 20 | Tt | 320 | Tp/16 | 12 | Tp | 192 | Tpe/16 | 20.8125 | Tpe | 333 | track | 2 | current | up, | ccm: | dutyChange | 1 | Tt/16 | 20 | Tt | 320 | Tp/16 | 12.0625 | Tp | 193 | Tpe/16 | 20.8125 | Tpe
pwm1.current_Test:Time | 51 | target | 2 | battery_soc | 0.34 | pv_illumination | 1 | Vpp | 20.846 | Ipp | 1.0416 | IppL | 1.0416 | Ipp | delta | 0 | soc | 0.3439 | Vbb | 12.5116 | Vpp | 20.007 | Ipp | 3.1808 | Ipp | delta | 0 | Ibb | 5.086 | Tt/16 | 20 | Tt | 320 | Tp/16 | 12.0625 | Tp | 193 | Tpe/16 | 20.8125 | Tpe | 333 | track | 0 | current | dn, | ccm: | dutyChange | -1 | Tt/16 | 20 | Tt | 320 | Tp/16 | 12 | Tp | 192 | Tpe/16 | 20.8125 | Tpe
pwm1.current_Test:Time | 51.5 | target | 2 | battery_soc | 0.35 | pv_illumination | 1 | Vpp | 20.007 | Ipp | 3.1808 | IppL | 3.1808 | Ipp | delta | 0 | soc | 0.3492 | Vbb | 12.0735 | Vpp | 20.853 | Ipp | 1.0247 | Ipp | delta | 0 | Ibb | 1.77 | Tt/16 | 20 | Tt | 320 | Tp/16 | 12 | Tp | 192 | Tpe/16 | 20.8125 | Tpe | 333 | track | 2 | current | up, | ccm: | dutyChange | 1 | Tt/16 | 20 | Tt | 320 | Tp/16 | 12.0625 | Tp | 193 | Tpe/16 | 20.8125 | Tpe
pwm1.current_Test:Time | 52 | target | 2 | battery_soc | 0.35 | pv_illumination | 1 | Vpp | 20.853 | Ipp | 1.0247 | IppL | 1.0247 | Ipp | delta | 0 | soc | 0.3509 | Vbb | 12.5157 | Vpp | 20.018 | Ipp | 3.1517 | Ipp | delta | 0 | Ibb | 5.041 | Tt/16 | 20 | Tt | 320 | Tp/16 | 12.0625 | Tp | 193 | Tpe/16 | 20.8125 | Tpe | 333 | track | 0 | current | dn, | ccm: | dutyChange | -1 | Tt/16 | 20 | Tt | 320 | Tp/16 | 12 | Tp | 192 | Tpe/16 | 20.8125 | Tpe
pwm1.current_Test:Time | 52.5 | target | 2 | battery_soc | 0.36 | pv_illumination | 1 | Vpp | 20.018 | Ipp | 3.1517 | IppL | 3.1517 | Ipp | delta | 0 | soc | 0.3562 | Vbb | 12.08 | Vpp | 20.859 | Ipp | 1.0081 | Ipp | delta | 0 | Ibb | 1.741 | Tt/16 | 20 | Tt | 320 | Tp/16 | 12 | Tp | 192 | Tpe/16 | 20.8125 | Tpe | 333 | track | 2 | current | up, | ccm: | dutyChange | 1 | Tt/16 | 26 | Tt | 416 | Tp/16 | 12.0625 | Tp | 193 | Tpe/16 | 20.8125 | Tpe
pwm1.current_Test:Time | 53 | target | 2 | battery_soc | 0.36 | pv_illumination | 1 | Vpp | 20.859 | Ipp | 1.0081 | IppL | 1.0081 | Ipp | delta | 0 | soc | 0.3578 | Vbb | 12.1339 | Vpp | 20.775 | Ipp | 1.2166 | Ipp | delta | -0.0117 | Ibb | 2.083 | Tt/16 | 26 | Tt | 416 | Tp/16 | 12.0625 | Tp | 193 | Tpe/16 | 20.8125 | Tpe | 333 | track | 3 | current | up, | dcm: | dutyChange | 1 | Tt/16 | 20 | Tt | 320 | Tp/16 | 12.125 | Tp | 194 | Tpe/16 | 20.75 | Tpe
pwm1.current_Test:Time | 53.5 | target | 2 | battery_soc | 0.36 | pv_illumination | 1 | Vpp | 20.775 | Ipp | 1.2166 | IppL | 1.2283 | Ipp | delta | -0.0117 | soc | 0.3599 | Vbb | 12.5272 | Vpp | 20.015 | Ipp | 3.1608 | Ipp | delta | 0 | Ibb | 5.05 | Tt/16 | 20 | Tt | 320 | Tp/16 | 12.125 | Tp | 194 | Tpe/16 | 20.75 | Tpe | 332 | track | 0 | current | dn, | ccm: | dutyChange | -1 | Tt/16 | 20 | Tt | 320 | Tp/16 | 12.0625 | Tp | 193 | Tpe/16 | 20.75 | Tpe
pwm1.current_Test:Time | 54 | target | 2 | battery_soc | 0.37 | pv_illumination | 1 | Vpp | 20.015 | Ipp | 3.1608 | IppL | 3.1608 | Ipp | delta | 0 | soc | 0.3651 | Vbb | 12.1372 | Vpp | 20.77 | Ipp | 1.2267 | Ipp | delta | 0 | Ibb | 2.099 | Tt/16 | 20 | Tt | 320 | Tp/16 | 12.0625 | Tp | 193 | Tpe/16 | 20.75 | Tpe | 332 | track | 2 | current | up, | ccm: | dutyChange | 1 | Tt/16 | 20 | Tt | 320 | Tp/16 | 12.125 | Tp | 194 | Tpe/16 | 20.75 | Tpe
pwm1.current_Test:Time | 54.5 | target | 2 | battery_soc | 0.37 | pv_illumination | 1 | Vpp | 20.77 | Ipp | 1.2267 | IppL | 1.2267 | Ipp | delta | 0 | soc | 0.3672 | Vbb | 12.5347 | Vpp | 20.02 | Ipp | 3.1464 | Ipp | delta | 0 | Ibb | 5.025 | Tt/16 | 20 | Tt | 320 | Tp/16 | 12.125 | Tp | 194 | Tpe/16 | 20.75 | Tpe | 332 | track | 0 | current | dn, | ccm: | dutyChange | -1 | Tt/16 | 20 | Tt | 320 | Tp/16 | 12.0625 | Tp | 193 | Tpe/16 | 20.75 | Tpe
pwm1.current_Test:Time | 55 | target | 2 | battery_soc | 0.37 | pv_illumination | 1 | Vpp | 20.02 | Ipp | 3.1464 | IppL | 3.1464 | Ipp | delta | 0 | soc | 0.3724 | Vbb | 12.1413 | Vpp | 20.783 | Ipp | 1.196 | Ipp | delta | 0 | Ibb | 2.047 | Tt/16 | 20 | Tt | 320 | Tp/16 | 12.0625 | Tp | 193 | Tpe/16 | 20.75 | Tpe | 332 | track | 2 | current | up, | ccm: | dutyChange | 1 | Tt/16 | 20 | Tt | 320 | Tp/16 | 12.125 | Tp | 194 | Tpe/16 | 20.75 | Tpe
pwm1.current_Test:Time | 55.5 | target | 2 | battery_soc | 0.37 | pv_illumination | 1 | Vpp | 20.783 | Ipp | 1.196 | IppL | 1.196 | Ipp | delta | 0 | soc | 0.3743 | Vbb | 12.5414 | Vpp | 20.027 | Ipp | 3.1286 | Ipp | delta | 0 | Ibb | 4.996 | Tt/16 | 20 | Tt | 320 | Tp/16 | 12.125 | Tp | 194 | Tpe/16 | 20.75 | Tpe | 332 | track | 0 | current | dn, | ccm: | dutyChange | -1 | Tt/16 | 20 | Tt | 320 | Tp/16 | 12.0625 | Tp | 193 | Tpe/16 | 20.75 | Tpe
pwm1.current_Test:Time | 56 | target | 2 | battery_soc | 0.38 | pv_illumination | 1 | Vpp | 20.027 | Ipp | 3.1286 | IppL | 3.1286 | Ipp | delta | 0 | soc | 0.3795 | Vbb | 12.146 | Vpp | 20.794 | Ipp | 1.1687 | Ipp | delta | 0 | Ibb | 2.001 | Tt/16 | 20 | Tt | 320 | Tp/16 | 12.0625 | Tp | 193 | Tpe/16 | 20.75 | Tpe | 332 | track | 2 | current | up, | ccm: | dutyChange | 1 | Tt/16 | 20 | Tt | 320 | Tp/16 | 12.125 | Tp | 194 | Tpe/16 | 20.75 | Tpe
pwm1.current_Test:Time | 56.5 | target | 2 | battery_soc | 0.38 | pv_illumination | 1 | Vpp | 20.794 | Ipp | 1.1687 | IppL | 1.1687 | Ipp | delta | 0 | soc | 0.3814 | Vbb | 12.5474 | Vpp | 20.035 | Ipp | 3.1082 | Ipp | delta | 0 | Ibb | 4.963 | Tt/16 | 20 | Tt | 320 | Tp/16 | 12.125 | Tp | 194 | Tpe/16 | 20.75 | Tpe | 332 | track | 0 | current | dn, | ccm: | dutyChange | -1 | Tt/16 | 20 | Tt | 320 | Tp/16 | 12.0625 | Tp | 193 | Tpe/16 | 20.75 | Tpe
pwm1.current_Test:Time | 57 | target | 2 | battery_soc | 0.39 | pv_illumination | 1 | Vpp | 20.035 | Ipp | 3.1082 | IppL | 3.1082 | Ipp | delta | 0 | soc | 0.3866 | Vbb | 12.151 | Vpp | 20.804 | Ipp | 1.1441 | Ipp | delta | 0 | Ibb | 1.959 | Tt/16 | 20 | Tt | 320 | Tp/16 | 12.0625 | Tp | 193 | Tpe/16 | 20.75 | Tpe | 332 | track | 2 | current | up, | ccm: | dutyChange | 1 | Tt/16 | 20 | Tt | 320 | Tp/16 | 12.125 | Tp | 194 | Tpe/16 | 20.75 | Tpe
pwm1.current_Test:Time | 57.5 | target | 2 | battery_soc | 0.39 | pv_illumination | 1 | Vpp | 20.804 | Ipp | 1.1441 | IppL | 1.1441 | Ipp | delta | 0 | soc | 0.3885 | Vbb | 12.553 | Vpp | 20.043 | Ipp | 3.086 | Ipp | delta | 0 | Ibb | 4.927 | Tt/16 | 20 | Tt | 320 | Tp/16 | 12.125 | Tp | 194 | Tpe/16 | 20.75 | Tpe | 332 | track | 0 | current | dn, | ccm: | dutyChange | -1 | Tt/16 | 20 | Tt | 320 | Tp/16 | 12.0625 | Tp | 193 | Tpe/16 | 20.75 | Tpe
pwm1.current_Test:Time | 58 | target | 2 | battery_soc | 0.39 | pv_illumination | 1 | Vpp | 20.043 | Ipp | 3.086 | IppL | 3.086 | Ipp | delta | 0 | soc | 0.3936 | Vbb | 12.1564 | Vpp | 20.813 | Ipp | 1.1214 | Ipp | delta | 0 | Ibb | 1.92 | Tt/16 | 20 | Tt | 320 | Tp/16 | 12.0625 | Tp | 193 | Tpe/16 | 20.75 | Tpe | 332 | track | 2 | current | up, | ccm: | dutyChange | 1 | Tt/16 | 20 | Tt | 320 | Tp/16 | 12.125 | Tp | 194 | Tpe/16 | 20.75 | Tpe
pwm1.current_Test:Time | 58.5 | target | 2 | battery_soc | 0.4 | pv_illumination | 1 | Vpp | 20.813 | Ipp | 1.1214 | IppL | 1.1214 | Ipp | delta | 0 | soc | 0.3954 | Vbb | 12.5581 | Vpp | 20.052 | Ipp | 3.0624 | Ipp | delta | 0 | Ibb | 4.89 | Tt/16 | 20 | Tt | 320 | Tp/16 | 12.125 | Tp | 194 | Tpe/16 | 20.75 | Tpe | 332 | track | 0 | current | dn, | ccm: | dutyChange | -1 | Tt/16 | 20 | Tt | 320 | Tp/16 | 12.0625 | Tp | 193 | Tpe/16 | 20.75 | Tpe
pwm1.current_Test:Time | 59 | target | 2 | battery_soc | 0.4 | pv_illumination | 1 | Vpp | 20.052 | Ipp | 3.0624 | IppL | 3.0624 | Ipp | delta | 0 | soc | 0.4005 | Vbb | 12.1621 | Vpp | 20.822 | Ipp | 1.1004 | Ipp | delta | 0 | Ibb | 1.884 | Tt/16 | 20 | Tt | 320 | Tp/16 | 12.0625 | Tp | 193 | Tpe/16 | 20.75 | Tpe | 332 | track | 2 | current | up, | ccm: | dutyChange | 1 | Tt/16 | 20 | Tt | 320 | Tp/16 | 12.125 | Tp | 194 | Tpe/16 | 20.75 | Tpe
pwm1.current_Test:Time | 59.5 | target | 2 | battery_soc | 0.4 | pv_illumination | 1 | Vpp | 20.822 | Ipp | 1.1004 | IppL | 1.1004 | Ipp | delta | 0 | soc | 0.4023 | Vbb | 12.563 | Vpp | 20.061 | Ipp | 3.0379 | Ipp | delta | 0 | Ibb | 4.851 | Tt/16 | 20 | Tt | 320 | Tp/16 | 12.125 | Tp | 194 | Tpe/16 | 20.75 | Tpe | 332 | track | 0 | current | dn, | ccm: | dutyChange | -1 | Tt/16 | 20 | Tt | 320 | Tp/16 | 12.0625 | Tp | 193 | Tpe/16 | 20.75 | Tpe
pwm1.current_Test:Time | 60 | target | 2 | battery_soc | 0.41 | pv_illumination | 1 | Vpp | 20.061 | Ipp | 3.0379 | IppL | 3.0379 | Ipp | delta | 0 | soc | 0.4073 | Vbb | 12.1678 | Vpp | 20.83 | Ipp | 1.0805 | Ipp | delta | 0 | Ibb | 1.85 | Tt/16 | 20 | Tt | 320 | Tp/16 | 12.0625 | Tp | 193 | Tpe/16 | 20.75 | Tpe | 332 | track | 2 | current | up, | ccm: | dutyChange | 1 | Tt/16 | 20 | Tt | 320 | Tp/16 | 12.125 | Tp | 194 | Tpe/16 | 20.75 | Tpe
pwm1.current_Test:Time | 60.5 | target | 2 | battery_soc | 0.41 | pv_illumination | 1 | Vpp | 20.83 | Ipp | 1.0805 | IppL | 1.0805 | Ipp | delta | 0 | soc | 0.4091 | Vbb | 12.5677 | Vpp | 20.071 | Ipp | 3.0128 | Ipp | delta | 0 | Ibb | 4.811 | Tt/16 | 20 | Tt | 320 | Tp/16 | 12.125 | Tp | 194 | Tpe/16 | 20.75 | Tpe | 332 | track | 0 | current | dn, | ccm: | dutyChange | -1 | Tt/16 | 20 | Tt | 320 | Tp/16 | 12.0625 | Tp | 193 | Tpe/16 | 20.75 | Tpe
pwm1.current_Test:Time | 61 | target | 2 | battery_soc | 0.41 | pv_illumination | 1 | Vpp | 20.071 | Ipp | 3.0128 | IppL | 3.0128 | Ipp | delta | 0 | soc | 0.4141 | Vbb | 12.1737 | Vpp | 20.838 | Ipp | 1.0616 | Ipp | delta | 0 | Ibb | 1.817 | Tt/16 | 20 | Tt | 320 | Tp/16 | 12.0625 | Tp | 193 | Tpe/16 | 20.75 | Tpe | 332 | track | 2 | current | up, | ccm: | dutyChange | 1 | Tt/16 | 20 | Tt | 320 | Tp/16 | 12.125 | Tp | 194 | Tpe/16 | 20.75 | Tpe
pwm1.current_Test:Time | 61.5 | target | 2 | battery_soc | 0.42 | pv_illumination | 1 | Vpp | 20.838 | Ipp | 1.0616 | IppL | 1.0616 | Ipp | delta | 0 | soc | 0.4158 | Vbb | 12.5721 | Vpp | 20.08 | Ipp | 2.9873 | Ipp | delta | 0 | Ibb | 4.771 | Tt/16 | 20 | Tt | 320 | Tp/16 | 12.125 | Tp | 194 | Tpe/16 | 20.75 | Tpe | 332 | track | 0 | current | dn, | ccm: | dutyChange | -1 | Tt/16 | 20 | Tt | 320 | Tp/16 | 12.0625 | Tp | 193 | Tpe/16 | 20.75 | Tpe
pwm1.current_Test:Time | 62 | target | 2 | battery_soc | 0.42 | pv_illumination | 1 | Vpp | 20.08 | Ipp | 2.9873 | IppL | 2.9873 | Ipp | delta | 0 | soc | 0.4208 | Vbb | 12.1796 | Vpp | 20.845 | Ipp | 1.0435 | Ipp | delta | 0 | Ibb | 1.786 | Tt/16 | 20 | Tt | 320 | Tp/16 | 12.0625 | Tp | 193 | Tpe/16 | 20.75 | Tpe | 332 | track | 2 | current | up, | ccm: | dutyChange | 1 | Tt/16 | 20 | Tt | 320 | Tp/16 | 12.125 | Tp | 194 | Tpe/16 | 20.75 | Tpe
pwm1.current_Test:Time | 62.5 | target | 2 | battery_soc | 0.42 | pv_illumination | 1 | Vpp | 20.845 | Ipp | 1.0435 | IppL | 1.0435 | Ipp | delta | 0 | soc | 0.4225 | Vbb | 12.5765 | Vpp | 20.09 | Ipp | 2.9616 | Ipp | delta | 0 | Ibb | 4.731 | Tt/16 | 20 | Tt | 320 | Tp/16 | 12.125 | Tp | 194 | Tpe/16 | 20.75 | Tpe | 332 | track | 0 | current | dn, | ccm: | dutyChange | -1 | Tt/16 | 20 | Tt | 320 | Tp/16 | 12.0625 | Tp | 193 | Tpe/16 | 20.75 | Tpe
pwm1.current_Test:Time | 63 | target | 2 | battery_soc | 0.43 | pv_illumination | 1 | Vpp | 20.09 | Ipp | 2.9616 | IppL | 2.9616 | Ipp | delta | 0 | soc | 0.4274 | Vbb | 12.1855 | Vpp | 20.852 | Ipp | 1.0259 | Ipp | delta | 0 | Ibb | 1.756 | Tt/16 | 20 | Tt | 320 | Tp/16 | 12.0625 | Tp | 193 | Tpe/16 | 20.75 | Tpe | 332 | track | 2 | current | up, | ccm: | dutyChange | 1 | Tt/16 | 20 | Tt | 320 | Tp/16 | 12.125 | Tp | 194 | Tpe/16 | 20.75 | Tpe
pwm1.current_Test:Time | 63.5 | target | 2 | battery_soc | 0.43 | pv_illumination | 1 | Vpp | 20.852 | Ipp | 1.0259 | IppL | 1.0259 | Ipp | delta | 0 | soc | 0.4291 | Vbb | 12.5807 | Vpp | 20.1 | Ipp | 2.9359 | Ipp | delta | 0 | Ibb | 4.691 | Tt/16 | 20 | Tt | 320 | Tp/16 | 12.125 | Tp | 194 | Tpe/16 | 20.75 | Tpe | 332 | track | 0 | current | dn, | ccm: | dutyChange | -1 | Tt/16 | 20 | Tt | 320 | Tp/16 | 12.0625 | Tp | 193 | Tpe/16 | 20.75 | Tpe
pwm1.current_Test:Time | 64 | target | 2 | battery_soc | 0.43 | pv_illumination | 1 | Vpp | 20.1 | Ipp | 2.9359 | IppL | 2.9359 | Ipp | delta | 0 | soc | 0.4339 | Vbb | 12.1914 | Vpp | 20.859 | Ipp | 1.0088 | Ipp | delta | 0 | Ibb | 1.726 | Tt/16 | 20 | Tt | 320 | Tp/16 | 12.0625 | Tp | 193 | Tpe/16 | 20.75 | Tpe | 332 | track | 2 | current | up, | ccm: | dutyChange | 1 | Tt/16 | 25.8125 | Tt | 413 | Tp/16 | 12.125 | Tp | 194 | Tpe/16 | 20.6875 | Tpe
pwm1.current_Test:Time | 64.5 | target | 2 | battery_soc | 0.44 | pv_illumination | 1 | Vpp | 20.859 | Ipp | 1.0088 | IppL | 1.0088 | Ipp | delta | 0 | soc | 0.4356 | Vbb | 12.245 | Vpp | 20.772 | Ipp | 1.2219 | Ipp | delta | -0.0122 | Ibb | 2.073 | Tt/16 | 25.8125 | Tt | 413 | Tp/16 | 12.125 | Tp | 194 | Tpe/16 | 20.6875 | Tpe | 331 | track | 3 | current | up, | dcm: | dutyChange | 1 | Tt/16 | 20 | Tt | 320 | Tp/16 | 12.1875 | Tp | 195 | Tpe/16 | 20.625 | Tpe
pwm1.current_Test:Time | 65 | target | 2 | battery_soc | 0.44 | pv_illumination | 1 | Vpp | 20.772 | Ipp | 1.2219 | IppL | 1.2342 | Ipp | delta | -0.0122 | soc | 0.4377 | Vbb | 12.5929 | Vpp | 20.094 | Ipp | 2.9503 | Ipp | delta | 0 | Ibb | 4.708 | Tt/16 | 20 | Tt | 320 | Tp/16 | 12.1875 | Tp | 195 | Tpe/16 | 20.625 | Tpe | 330 | track | 0 | current | dn, | ccm: | dutyChange | -1 | Tt/16 | 20 | Tt | 320 | Tp/16 | 12.125 | Tp | 194 | Tpe/16 | 20.625 | Tpe
pwm1.current_Test:Time | 65.5 | target | 2 | battery_soc | 0.44 | pv_illumination | 1 | Vpp | 20.094 | Ipp | 2.9503 | IppL | 2.9503 | Ipp | delta | 0 | soc | 0.4425 | Vbb | 12.2469 | Vpp | 20.772 | Ipp | 1.2232 | Ipp | delta | 0 | Ibb | 2.075 | Tt/16 | 20 | Tt | 320 | Tp/16 | 12.125 | Tp | 194 | Tpe/16 | 20.625 | Tpe | 330 | track | 2 | current | up, | ccm: | dutyChange | 1 | Tt/16 | 20 | Tt | 320 | Tp/16 | 12.1875 | Tp | 195 | Tpe/16 | 20.625 | Tpe
pwm1.current_Test:Time | 66 | target | 2 | battery_soc | 0.44 | pv_illumination | 1 | Vpp | 20.772 | Ipp | 1.2232 | IppL | 1.2232 | Ipp | delta | 0 | soc | 0.4445 | Vbb | 12.6011 | Vpp | 20.098 | Ipp | 2.9418 | Ipp | delta | 0 | Ibb | 4.692 | Tt/16 | 20 | Tt | 320 | Tp/16 | 12.1875 | Tp | 195 | Tpe/16 | 20.625 | Tpe | 330 | track | 0 | current | dn, | ccm: | dutyChange | -1 | Tt/16 | 20 | Tt | 320 | Tp/16 | 12.125 | Tp | 194 | Tpe/16 | 20.625 | Tpe
pwm1.current_Test:Time | 66.5 | target | 2 | battery_soc | 0.45 | pv_illumination | 1 | Vpp | 20.098 | Ipp | 2.9418 | IppL | 2.9418 | Ipp | delta | 0 | soc | 0.4494 | Vbb | 12.25 | Vpp | 20.785 | Ipp | 1.19 | Ipp | delta | 0 | Ibb | 2.019 | Tt/16 | 20 | Tt | 320 | Tp/16 | 12.125 | Tp | 194 | Tpe/16 | 20.625 | Tpe | 330 | track | 2 | current | up, | ccm: | dutyChange | 1 | Tt/16 | 20 | Tt | 320 | Tp/16 | 12.1875 | Tp | 195 | Tpe/16 | 20.625 | Tpe
pwm1.current_Test:Time | 67 | target | 2 | battery_soc | 0.45 | pv_illumination | 1 | Vpp | 20.785 | Ipp | 1.19 | IppL | 1.19 | Ipp | delta | 0 | soc | 0.4513 | Vbb | 12.6082 | Vpp | 20.103 | Ipp | 2.9286 | Ipp | delta | 0 | Ibb | 4.669 | Tt/16 | 20 | Tt | 320 | Tp/16 | 12.1875 | Tp | 195 | Tpe/16 | 20.625 | Tpe | 330 | track | 0 | current | dn, | ccm: | dutyChange | -1 | Tt/16 | 20 | Tt | 320 | Tp/16 | 12.125 | Tp | 194 | Tpe/16 | 20.625 | Tpe
pwm1.current_Test:Time | 67.5 | target | 2 | battery_soc | 0.46 | pv_illumination | 1 | Vpp | 20.103 | Ipp | 2.9286 | IppL | 2.9286 | Ipp | delta | 0 | soc | 0.4561 | Vbb | 12.2538 | Vpp | 20.797 | Ipp | 1.1611 | Ipp | delta | 0 | Ibb | 1.971 | Tt/16 | 20 | Tt | 320 | Tp/16 | 12.125 | Tp | 194 | Tpe/16 | 20.625 | Tpe | 330 | track | 2 | current | up, | ccm: | dutyChange | 1 | Tt/16 | 20 | Tt | 320 | Tp/16 | 12.1875 | Tp | 195 | Tpe/16 | 20.625 | Tpe
pwm1.current_Test:Time | 68 | target | 2 | battery_soc | 0.46 | pv_illumination | 1 | Vpp | 20.797 | Ipp | 1.1611 | IppL | 1.1611 | Ipp | delta | 0 | soc | 0.458 | Vbb | 12.6145 | Vpp | 20.109 | Ipp | 2.9121 | Ipp | delta | 0 | Ibb | 4.642 | Tt/16 | 20 | Tt | 320 | Tp/16 | 12.1875 | Tp | 195 | Tpe/16 | 20.625 | Tpe | 330 | track | 0 | current | dn, | ccm: | dutyChange | -1 | Tt/16 | 20 | Tt | 320 | Tp/16 | 12.125 | Tp | 194 | Tpe/16 | 20.625 | Tpe
pwm1.current_Test:Time | 68.5 | target | 2 | battery_soc | 0.46 | pv_illumination | 1 | Vpp | 20.109 | Ipp | 2.9121 | IppL | 2.9121 | Ipp | delta | 0 | soc | 0.4628 | Vbb | 12.2582 | Vpp | 20.807 | Ipp | 1.1355 | Ipp | delta | 0 | Ibb | 1.927 | Tt/16 | 20 | Tt | 320 | Tp/16 | 12.125 | Tp | 194 | Tpe/16 | 20.625 | Tpe | 330 | track | 2 | current | up, | ccm: | dutyChange | 1 | Tt/16 | 20 | Tt | 320 | Tp/16 | 12.1875 | Tp | 195 | Tpe/16 | 20.625 | Tpe
pwm1.current_Test:Time | 69 | target | 2 | battery_soc | 0.46 | pv_illumination | 1 | Vpp | 20.807 | Ipp | 1.1355 | IppL | 1.1355 | Ipp | delta | 0 | soc | 0.4647 | Vbb | 12.6202 | Vpp | 20.116 | Ipp | 2.8932 | Ipp | delta | 0 | Ibb | 4.612 | Tt/16 | 20 | Tt | 320 | Tp/16 | 12.1875 | Tp | 195 | Tpe/16 | 20.625 | Tpe | 330 | track | 0 | current | dn, | ccm: | dutyChange | -1 | Tt/16 | 20 | Tt | 320 | Tp/16 | 12.125 | Tp | 194 | Tpe/16 | 20.625 | Tpe
pwm1.current_Test:Time | 69.5 | target | 2 | battery_soc | 0.47 | pv_illumination | 1 | Vpp | 20.116 | Ipp | 2.8932 | IppL | 2.8932 | Ipp | delta | 0 | soc | 0.4694 | Vbb | 12.263 | Vpp | 20.817 | Ipp | 1.1123 | Ipp | delta | 0 | Ibb | 1.888 | Tt/16 | 20 | Tt | 320 | Tp/16 | 12.125 | Tp | 194 | Tpe/16 | 20.625 | Tpe | 330 | track | 2 | current | up, | ccm: | dutyChange | 1 | Tt/16 | 20 | Tt | 320 | Tp/16 | 12.1875 | Tp | 195 | Tpe/16 | 20.625 | Tpe
pwm1.current_Test:Time | 70 | target | 2 | battery_soc | 0.47 | pv_illumination | 1 | Vpp | 20.817 | Ipp | 1.1123 | IppL | 1.1123 | Ipp | delta | 0 | soc | 0.4713 | Vbb | 12.6255 | Vpp | 20.124 | Ipp | 2.8726 | Ipp | delta | 0 | Ibb | 4.579 | Tt/16 | 20 | Tt | 320 | Tp/16 | 12.1875 | Tp | 195 | Tpe/16 | 20.625 | Tpe | 330 | track | 0 | current | dn, | ccm: | dutyChange | -1 | Tt/16 | 20 | Tt | 320 | Tp/16 | 12.125 | Tp | 194 | Tpe/16 | 20.625 | Tpe
pwm1.current_Test:Time | 70.5 | target | 2 | battery_soc | 0.48 | pv_illumination | 1 | Vpp | 20.124 | Ipp | 2.8726 | IppL | 2.8726 | Ipp | delta | 0 | soc | 0.476 | Vbb | 12.268 | Vpp | 20.826 | Ipp | 1.0909 | Ipp | delta | 0 | Ibb | 1.852 | Tt/16 | 20 | Tt | 320 | Tp/16 | 12.125 | Tp | 194 | Tpe/16 | 20.625 | Tpe | 330 | track | 2 | current | up, | ccm: | dutyChange | 1 | Tt/16 | 20 | Tt | 320 | Tp/16 | 12.1875 | Tp | 195 | Tpe/16 | 20.625 | Tpe
pwm1.current_Test:Time | 71 | target | 2 | battery_soc | 0.48 | pv_illumination | 1 | Vpp | 20.826 | Ipp | 1.0909 | IppL | 1.0909 | Ipp | delta | 0 | soc | 0.4778 | Vbb | 12.6305 | Vpp | 20.132 | Ipp | 2.8508 | Ipp | delta | 0 | Ibb | 4.544 | Tt/16 | 20 | Tt | 320 | Tp/16 | 12.1875 | Tp | 195 | Tpe/16 | 20.625 | Tpe | 330 | track | 0 | current | dn, | ccm: | dutyChange | -1 | Tt/16 | 20 | Tt | 320 | Tp/16 | 12.125 | Tp | 194 | Tpe/16 | 20.625 | Tpe
pwm1.current_Test:Time | 71.5 | target | 2 | battery_soc | 0.48 | pv_illumination | 1 | Vpp | 20.132 | Ipp | 2.8508 | IppL | 2.8508 | Ipp | delta | 0 | soc | 0.4825 | Vbb | 12.2733 | Vpp | 20.834 | Ipp | 1.0709 | Ipp | delta | 0 | Ibb | 1.818 | Tt/16 | 20 | Tt | 320 | Tp/16 | 12.125 | Tp | 194 | Tpe/16 | 20.625 | Tpe | 330 | track | 2 | current | up, | ccm: | dutyChange | 1 | Tt/16 | 20 | Tt | 320 | Tp/16 | 12.1875 | Tp | 195 | Tpe/16 | 20.625 | Tpe
pwm1.current_Test:Time | 72 | target | 2 | battery_soc | 0.48 | pv_illumination | 1 | Vpp | 20.834 | Ipp | 1.0709 | IppL | 1.0709 | Ipp | delta | 0 | soc | 0.4842 | Vbb | 12.6352 | Vpp | 20.141 | Ipp | 2.8283 | Ipp | delta | 0 | Ibb | 4.508 | Tt/16 | 20 | Tt | 320 | Tp/16 | 12.1875 | Tp | 195 | Tpe/16 | 20.625 | Tpe | 330 | track | 0 | current | dn, | ccm: | dutyChange | -1 | Tt/16 | 20 | Tt | 320 | Tp/16 | 12.125 | Tp | 194 | Tpe/16 | 20.625 | Tpe
pwm1.current_Test:Time | 72.5 | target | 2 | battery_soc | 0.49 | pv_illumination | 1 | Vpp | 20.141 | Ipp | 2.8283 | IppL | 2.8283 | Ipp | delta | 0 | soc | 0.4889 | Vbb | 12.2786 | Vpp | 20.841 | Ipp | 1.052 | Ipp | delta | 0 | Ibb | 1.786 | Tt/16 | 20 | Tt | 320 | Tp/16 | 12.125 | Tp | 194 | Tpe/16 | 20.625 | Tpe | 330 | track | 2 | current | up, | ccm: | dutyChange | 1 | Tt/16 | 20 | Tt | 320 | Tp/16 | 12.1875 | Tp | 195 | Tpe/16 | 20.625 | Tpe
pwm1.current_Test:Time | 73 | target | 2 | battery_soc | 0.49 | pv_illumination | 1 | Vpp | 20.841 | Ipp | 1.052 | IppL | 1.052 | Ipp | delta | 0 | soc | 0.4906 | Vbb | 12.6396 | Vpp | 20.15 | Ipp | 2.8052 | Ipp | delta | 0 | Ibb | 4.472 | Tt/16 | 20 | Tt | 320 | Tp/16 | 12.1875 | Tp | 195 | Tpe/16 | 20.625 | Tpe | 330 | track | 0 | current | dn, | ccm: | dutyChange | -1 | Tt/16 | 20 | Tt | 320 | Tp/16 | 12.125 | Tp | 194 | Tpe/16 | 20.625 | Tpe
pwm1.current_Test:Time | 73.5 | target | 2 | battery_soc | 0.5 | pv_illumination | 1 | Vpp | 20.15 | Ipp | 2.8052 | IppL | 2.8052 | Ipp | delta | 0 | soc | 0.4952 | Vbb | 12.284 | Vpp | 20.849 | Ipp | 1.0339 | Ipp | delta | 0 | Ibb | 1.755 | Tt/16 | 20 | Tt | 320 | Tp/16 | 12.125 | Tp | 194 | Tpe/16 | 20.625 | Tpe | 330 | track | 2 | current | up, | ccm: | dutyChange | 1 | Tt/16 | 20 | Tt | 320 | Tp/16 | 12.1875 | Tp | 195 | Tpe/16 | 20.625 | Tpe
pwm1.current_Test:Time | 74 | target | 2 | battery_soc | 0.5 | pv_illumination | 1 | Vpp | 20.849 | Ipp | 1.0339 | IppL | 1.0339 | Ipp | delta | 0 | soc | 0.4969 | Vbb | 12.644 | Vpp | 20.158 | Ipp | 2.782 | Ipp | delta | 0 | Ibb | 4.435 | Tt/16 | 20 | Tt | 320 | Tp/16 | 12.1875 | Tp | 195 | Tpe/16 | 20.625 | Tpe | 330 | track | 0 | current | dn, | ccm: | dutyChange | -1 | Tt/16 | 20 | Tt | 320 | Tp/16 | 12.125 | Tp | 194 | Tpe/16 | 20.625 | Tpe
pwm1.current_Test:Time | 74.5 | target | 2 | battery_soc | 0.5 | pv_illumination | 1 | Vpp | 20.158 | Ipp | 2.782 | IppL | 2.782 | Ipp | delta | 0 | soc | 0.5015 | Vbb | 12.2895 | Vpp | 20.856 | Ipp | 1.0164 | Ipp | delta | 0 | Ibb | 1.725 | Tt/16 | 20 | Tt | 320 | Tp/16 | 12.125 | Tp | 194 | Tpe/16 | 20.625 | Tpe | 330 | track | 2 | current | up, | ccm: | dutyChange | 1 | Tt/16 | 25.75 | Tt | 412 | Tp/16 | 12.1875 | Tp | 195 | Tpe/16 | 20.625 | Tpe
pwm1.current_Test:Time | 75 | target | 2 | battery_soc | 0.5 | pv_illumination | 1 | Vpp | 20.856 | Ipp | 1.0164 | IppL | 1.0164 | Ipp | delta | 0 | soc | 0.5032 | Vbb | 12.3408 | Vpp | 20.772 | Ipp | 1.2234 | Ipp | delta | -0.0119 | Ibb | 2.059 | Tt/16 | 25.75 | Tt | 412 | Tp/16 | 12.1875 | Tp | 195 | Tpe/16 | 20.625 | Tpe | 330 | track | 3 | current | up, | dcm: | dutyChange | 1 | Tt/16 | 20 | Tt | 320 | Tp/16 | 12.25 | Tp | 196 | Tpe/16 | 20.5625 | Tpe
pwm1.current_Test:Time | 75.5 | target | 2 | battery_soc | 0.51 | pv_illumination | 1 | Vpp | 20.772 | Ipp | 1.2234 | IppL | 1.2354 | Ipp | delta | -0.0119 | soc | 0.5052 | Vbb | 12.6585 | Vpp | 20.148 | Ipp | 2.8085 | Ipp | delta | 0 | Ibb | 4.47 | Tt/16 | 20 | Tt | 320 | Tp/16 | 12.25 | Tp | 196 | Tpe/16 | 20.5625 | Tpe | 329 | track | 0 | current | dn, | ccm: | dutyChange | -1 | Tt/16 | 20 | Tt | 320 | Tp/16 | 12.1875 | Tp | 195 | Tpe/16 | 20.5625 | Tpe
pwm1.current_Test:Time | 76 | target | 2 | battery_soc | 0.51 | pv_illumination | 1 | Vpp | 20.148 | Ipp | 2.8085 | IppL | 2.8085 | Ipp | delta | 0 | soc | 0.5098 | Vbb | 12.3423 | Vpp | 20.773 | Ipp | 1.2206 | Ipp | delta | 0 | Ibb | 2.054 | Tt/16 | 20 | Tt | 320 | Tp/16 | 12.1875 | Tp | 195 | Tpe/16 | 20.5625 | Tpe | 329 | track | 2 | current | up, | ccm: | dutyChange | 1 | Tt/16 | 20 | Tt | 320 | Tp/16 | 12.25 | Tp | 196 | Tpe/16 | 20.5625 | Tpe
pwm1.current_Test:Time | 76.5 | target | 2 | battery_soc | 0.51 | pv_illumination | 1 | Vpp | 20.773 | Ipp | 1.2206 | IppL | 1.2206 | Ipp | delta | 0 | soc | 0.5118 | Vbb | 12.6667 | Vpp | 20.151 | Ipp | 2.8021 | Ipp | delta | 0 | Ibb | 4.458 | Tt/16 | 20 | Tt | 320 | Tp/16 | 12.25 | Tp | 196 | Tpe/16 | 20.5625 | Tpe | 329 | track | 0 | current | dn, | ccm: | dutyChange | -1 | Tt/16 | 20 | Tt | 320 | Tp/16 | 12.1875 | Tp | 195 | Tpe/16 | 20.5625 | Tpe
pwm1.current_Test:Time | 77 | target | 2 | battery_soc | 0.52 | pv_illumination | 1 | Vpp | 20.151 | Ipp | 2.8021 | IppL | 2.8021 | Ipp | delta | 0 | soc | 0.5164 | Vbb | 12.345 | Vpp | 20.786 | Ipp | 1.1874 | Ipp | delta | 0 | Ibb | 1.999 | Tt/16 | 20 | Tt | 320 | Tp/16 | 12.1875 | Tp | 195 | Tpe/16 | 20.5625 | Tpe | 329 | track | 2 | current | up, | ccm: | dutyChange | 1 | Tt/16 | 20 | Tt | 320 | Tp/16 | 12.25 | Tp | 196 | Tpe/16 | 20.5625 | Tpe
pwm1.current_Test:Time | 77.5 | target | 2 | battery_soc | 0.52 | pv_illumination | 1 | Vpp | 20.786 | Ipp | 1.1874 | IppL | 1.1874 | Ipp | delta | 0 | soc | 0.5183 | Vbb | 12.6738 | Vpp | 20.155 | Ipp | 2.7905 | Ipp | delta | 0 | Ibb | 4.438 | Tt/16 | 20 | Tt | 320 | Tp/16 | 12.25 | Tp | 196 | Tpe/16 | 20.5625 | Tpe | 329 | track | 0 | current | dn, | ccm: | dutyChange | -1 | Tt/16 | 20 | Tt | 320 | Tp/16 | 12.1875 | Tp | 195 | Tpe/16 | 20.5625 | Tpe
pwm1.current_Test:Time | 78 | target | 2 | battery_soc | 0.52 | pv_illumination | 1 | Vpp | 20.155 | Ipp | 2.7905 | IppL | 2.7905 | Ipp | delta | 0 | soc | 0.5229 | Vbb | 12.3486 | Vpp | 20.798 | Ipp | 1.1589 | Ipp | delta | 0 | Ibb | 1.952 | Tt/16 | 20 | Tt | 320 | Tp/16 | 12.1875 | Tp | 195 | Tpe/16 | 20.5625 | Tpe | 329 | track | 2 | current | up, | ccm: | dutyChange | 1 | Tt/16 | 20 | Tt | 320 | Tp/16 | 12.25 | Tp | 196 | Tpe/16 | 20.5625 | Tpe
pwm1.current_Test:Time | 78.5 | target | 2 | battery_soc | 0.52 | pv_illumination | 1 | Vpp | 20.798 | Ipp | 1.1589 | IppL | 1.1589 | Ipp | delta | 0 | soc | 0.5248 | Vbb | 12.68 | Vpp | 20.161 | Ipp | 2.7754 | Ipp | delta | 0 | Ibb | 4.413 | Tt/16 | 20 | Tt | 320 | Tp/16 | 12.25 | Tp | 196 | Tpe/16 | 20.5625 | Tpe | 329 | track | 0 | current | dn, | ccm: | dutyChange | -1 | Tt/16 | 20 | Tt | 320 | Tp/16 | 12.1875 | Tp | 195 | Tpe/16 | 20.5625 | Tpe
pwm1.current_Test:Time | 79 | target | 2 | battery_soc | 0.53 | pv_illumination | 1 | Vpp | 20.161 | Ipp | 2.7754 | IppL | 2.7754 | Ipp | delta | 0 | soc | 0.5293 | Vbb | 12.3527 | Vpp | 20.808 | Ipp | 1.1337 | Ipp | delta | 0 | Ibb | 1.91 | Tt/16 | 20 | Tt | 320 | Tp/16 | 12.1875 | Tp | 195 | Tpe/16 | 20.5625 | Tpe | 329 | track | 2 | current | up, | ccm: | dutyChange | 1 | Tt/16 | 20 | Tt | 320 | Tp/16 | 12.25 | Tp | 196 | Tpe/16 | 20.5625 | Tpe
pwm1.current_Test:Time | 79.5 | target | 2 | battery_soc | 0.53 | pv_illumination | 1 | Vpp | 20.808 | Ipp | 1.1337 | IppL | 1.1337 | Ipp | delta | 0 | soc | 0.5312 | Vbb | 12.6856 | Vpp | 20.168 | Ipp | 2.7577 | Ipp | delta | 0 | Ibb | 4.384 | Tt/16 | 20 | Tt | 320 | Tp/16 | 12.25 | Tp | 196 | Tpe/16 | 20.5625 | Tpe | 329 | track | 0 | current | dn, | ccm: | dutyChange | -1 | Tt/16 | 20 | Tt | 320 | Tp/16 | 12.1875 | Tp | 195 | Tpe/16 | 20.5625 | Tpe
pwm1.current_Test:Time | 80 | target | 2 | battery_soc | 0.54 | pv_illumination | 1 | Vpp | 20.168 | Ipp | 2.7577 | IppL | 2.7577 | Ipp | delta | 0 | soc | 0.5357 | Vbb | 12.3572 | Vpp | 20.817 | Ipp | 1.111 | Ipp | delta | 0 | Ibb | 1.872 | Tt/16 | 20 | Tt | 320 | Tp/16 | 12.1875 | Tp | 195 | Tpe/16 | 20.5625 | Tpe | 329 | track | 2 | current | up, | ccm: | dutyChange | 1 | Tt/16 | 20 | Tt | 320 | Tp/16 | 12.25 | Tp | 196 | Tpe/16 | 20.5625 | Tpe
pwm1.current_Test:Time | 80.5 | target | 2 | battery_soc | 0.54 | pv_illumination | 1 | Vpp | 20.817 | Ipp | 1.111 | IppL | 1.111 | Ipp | delta | 0 | soc | 0.5375 | Vbb | 12.6908 | Vpp | 20.175 | Ipp | 2.7384 | Ipp | delta | 0 | Ibb | 4.353 | Tt/16 | 20 | Tt | 320 | Tp/16 | 12.25 | Tp | 196 | Tpe/16 | 20.5625 | Tpe | 329 | track | 0 | current | dn, | ccm: | dutyChange | -1 | Tt/16 | 20 | Tt | 320 | Tp/16 | 12.1875 | Tp | 195 | Tpe/16 | 20.5625 | Tpe
pwm1.current_Test:Time | 81 | target | 2 | battery_soc | 0.54 | pv_illumination | 1 | Vpp | 20.175 | Ipp | 2.7384 | IppL | 2.7384 | Ipp | delta | 0 | soc | 0.542 | Vbb | 12.362 | Vpp | 20.826 | Ipp | 1.0901 | Ipp | delta | 0 | Ibb | 1.836 | Tt/16 | 20 | Tt | 320 | Tp/16 | 12.1875 | Tp | 195 | Tpe/16 | 20.5625 | Tpe | 329 | track | 2 | current | up, | ccm: | dutyChange | 1 | Tt/16 | 20 | Tt | 320 | Tp/16 | 12.25 | Tp | 196 | Tpe/16 | 20.5625 | Tpe
pwm1.current_Test:Time | 81.5 | target | 2 | battery_soc | 0.54 | pv_illumination | 1 | Vpp | 20.826 | Ipp | 1.0901 | IppL | 1.0901 | Ipp | delta | 0 | soc | 0.5438 | Vbb | 12.6957 | Vpp | 20.183 | Ipp | 2.7179 | Ipp | delta | 0 | Ibb | 4.321 | Tt/16 | 20 | Tt | 320 | Tp/16 | 12.25 | Tp | 196 | Tpe/16 | 20.5625 | Tpe | 329 | track | 0 | current | dn, | ccm: | dutyChange | -1 | Tt/16 | 20 | Tt | 320 | Tp/16 | 12.1875 | Tp | 195 | Tpe/16 | 20.5625 | Tpe
pwm1.current_Test:Time | 82 | target | 2 | battery_soc | 0.55 | pv_illumination | 1 | Vpp | 20.183 | Ipp | 2.7179 | IppL | 2.7179 | Ipp | delta | 0 | soc | 0.5482 | Vbb | 12.367 | Vpp | 20.834 | Ipp | 1.0706 | Ipp | delta | 0 | Ibb | 1.803 | Tt/16 | 20 | Tt | 320 | Tp/16 | 12.1875 | Tp | 195 | Tpe/16 | 20.5625 | Tpe | 329 | track | 2 | current | up, | ccm: | dutyChange | 1 | Tt/16 | 20 | Tt | 320 | Tp/16 | 12.25 | Tp | 196 | Tpe/16 | 20.5625 | Tpe
pwm1.current_Test:Time | 82.5 | target | 2 | battery_soc | 0.55 | pv_illumination | 1 | Vpp | 20.834 | Ipp | 1.0706 | IppL | 1.0706 | Ipp | delta | 0 | soc | 0.55 | Vbb | 12.7003 | Vpp | 20.191 | Ipp | 2.6966 | Ipp | delta | 0 | Ibb | 4.287 | Tt/16 | 20 | Tt | 320 | Tp/16 | 12.25 | Tp | 196 | Tpe/16 | 20.5625 | Tpe | 329 | track | 0 | current | dn, | ccm: | dutyChange | -1 | Tt/16 | 20 | Tt | 320 | Tp/16 | 12.1875 | Tp | 195 | Tpe/16 | 20.5625 | Tpe
pwm1.current_Test:Time | 83 | target | 2 | battery_soc | 0.55 | pv_illumination | 1 | Vpp | 20.191 | Ipp | 2.6966 | IppL | 2.6966 | Ipp | delta | 0 | soc | 0.5544 | Vbb | 12.3721 | Vpp | 20.841 | Ipp | 1.052 | Ipp | delta | 0 | Ibb | 1.772 | Tt/16 | 20 | Tt | 320 | Tp/16 | 12.1875 | Tp | 195 | Tpe/16 | 20.5625 | Tpe | 329 | track | 2 | current | up, | ccm: | dutyChange | 1 | Tt/16 | 20 | Tt | 320 | Tp/16 | 12.25 | Tp | 196 | Tpe/16 | 20.5625 | Tpe
pwm1.current_Test:Time | 83.5 | target | 2 | battery_soc | 0.56 | pv_illumination | 1 | Vpp | 20.841 | Ipp | 1.052 | IppL | 1.052 | Ipp | delta | 0 | soc | 0.5561 | Vbb | 12.7047 | Vpp | 20.199 | Ipp | 2.675 | Ipp | delta | 0 | Ibb | 4.253 | Tt/16 | 20 | Tt | 320 | Tp/16 | 12.25 | Tp | 196 | Tpe/16 | 20.5625 | Tpe | 329 | track | 0 | current | dn, | ccm: | dutyChange | -1 | Tt/16 | 20 | Tt | 320 | Tp/16 | 12.1875 | Tp | 195 | Tpe/16 | 20.5625 | Tpe
pwm1.current_Test:Time | 84 | target | 2 | battery_soc | 0.56 | pv_illumination | 1 | Vpp | 20.199 | Ipp | 2.675 | IppL | 2.675 | Ipp | delta | 0 | soc | 0.5605 | Vbb | 12.3773 | Vpp | 20.849 | Ipp | 1.0342 | Ipp | delta | 0 | Ibb | 1.742 | Tt/16 | 20 | Tt | 320 | Tp/16 | 12.1875 | Tp | 195 | Tpe/16 | 20.5625 | Tpe | 329 | track | 2 | current | up, | ccm: | dutyChange | 1 | Tt/16 | 20 | Tt | 320 | Tp/16 | 12.25 | Tp | 196 | Tpe/16 | 20.5625 | Tpe
pwm1.current_Test:Time | 84.5 | target | 2 | battery_soc | 0.56 | pv_illumination | 1 | Vpp | 20.849 | Ipp | 1.0342 | IppL | 1.0342 | Ipp | delta | 0 | soc | 0.5622 | Vbb | 12.709 | Vpp | 20.208 | Ipp | 2.653 | Ipp | delta | 0 | Ibb | 4.218 | Tt/16 | 20 | Tt | 320 | Tp/16 | 12.25 | Tp | 196 | Tpe/16 | 20.5625 | Tpe | 329 | track | 0 | current | dn, | ccm: | dutyChange | -1 | Tt/16 | 20 | Tt | 320 | Tp/16 | 12.1875 | Tp | 195 | Tpe/16 | 20.5625 | Tpe
pwm1.current_Test:Time | 85 | target | 2 | battery_soc | 0.57 | pv_illumination | 1 | Vpp | 20.208 | Ipp | 2.653 | IppL | 2.653 | Ipp | delta | 0 | soc | 0.5665 | Vbb | 12.3824 | Vpp | 20.856 | Ipp | 1.017 | Ipp | delta | 0 | Ibb | 1.713 | Tt/16 | 20 | Tt | 320 | Tp/16 | 12.1875 | Tp | 195 | Tpe/16 | 20.5625 | Tpe | 329 | track | 2 | current | up, | ccm: | dutyChange | 1 | Tt/16 | 25.75 | Tt | 412 | Tp/16 | 12.25 | Tp | 196 | Tpe/16 | 20.625 | Tpe
pwm1.current_Test:Time | 85.5 | target | 2 | battery_soc | 0.57 | pv_illumination | 1 | Vpp | 20.856 | Ipp | 1.017 | IppL | 1.017 | Ipp | delta | 0 | soc | 0.5682 | Vbb | 12.4326 | Vpp | 20.772 | Ipp | 1.2224 | Ipp | delta | -0.0121 | Ibb | 2.042 | Tt/16 | 25.75 | Tt | 412 | Tp/16 | 12.25 | Tp | 196 | Tpe/16 | 20.625 | Tpe | 330 | track | 3 | current | up, | dcm: | dutyChange | 1 | Tt/16 | 20 | Tt | 320 | Tp/16 | 12.3125 | Tp | 197 | Tpe/16 | 20.5625 | Tpe
pwm1.current_Test:Time | 86 | target | 2 | battery_soc | 0.57 | pv_illumination | 1 | Vpp | 20.772 | Ipp | 1.2224 | IppL | 1.2345 | Ipp | delta | -0.0121 | soc | 0.5702 | Vbb | 12.7246 | Vpp | 20.195 | Ipp | 2.6863 | Ipp | delta | 0 | Ibb | 4.263 | Tt/16 | 20 | Tt | 320 | Tp/16 | 12.3125 | Tp | 197 | Tpe/16 | 20.5625 | Tpe | 329 | track | 0 | current | dn, | ccm: | dutyChange | -1 | Tt/16 | 20 | Tt | 320 | Tp/16 | 12.25 | Tp | 196 | Tpe/16 | 20.5625 | Tpe
pwm1.current_Test:Time | 86.5 | target | 2 | battery_soc | 0.57 | pv_illumination | 1 | Vpp | 20.195 | Ipp | 2.6863 | IppL | 2.6863 | Ipp | delta | 0 | soc | 0.5746 | Vbb | 12.4336 | Vpp | 20.775 | Ipp | 1.2156 | Ipp | delta | 0 | Ibb | 2.031 | Tt/16 | 20 | Tt | 320 | Tp/16 | 12.25 | Tp | 196 | Tpe/16 | 20.5625 | Tpe | 329 | track | 2 | current | up, | ccm: | dutyChange | 1 | Tt/16 | 20 | Tt | 320 | Tp/16 | 12.3125 | Tp | 197 | Tpe/16 | 20.5625 | Tpe
pwm1.current_Test:Time | 87 | target | 2 | battery_soc | 0.58 | pv_illumination | 1 | Vpp | 20.775 | Ipp | 1.2156 | IppL | 1.2156 | Ipp | delta | 0 | soc | 0.5766 | Vbb | 12.7329 | Vpp | 20.197 | Ipp | 2.6819 | Ipp | delta | 0 | Ibb | 4.254 | Tt/16 | 20 | Tt | 320 | Tp/16 | 12.3125 | Tp | 197 | Tpe/16 | 20.5625 | Tpe | 329 | track | 0 | current | dn, | ccm: | dutyChange | -1 | Tt/16 | 20 | Tt | 320 | Tp/16 | 12.25 | Tp | 196 | Tpe/16 | 20.5625 | Tpe
pwm1.current_Test:Time | 87.5 | target | 2 | battery_soc | 0.58 | pv_illumination | 1 | Vpp | 20.197 | Ipp | 2.6819 | IppL | 2.6819 | Ipp | delta | 0 | soc | 0.5809 | Vbb | 12.4359 | Vpp | 20.788 | Ipp | 1.1823 | Ipp | delta | 0 | Ibb | 1.976 | Tt/16 | 20 | Tt | 320 | Tp/16 | 12.25 | Tp | 196 | Tpe/16 | 20.5625 | Tpe | 329 | track | 2 | current | up, | ccm: | dutyChange | 1 | Tt/16 | 20 | Tt | 320 | Tp/16 | 12.3125 | Tp | 197 | Tpe/16 | 20.5625 | Tpe
pwm1.current_Test:Time | 88 | target | 2 | battery_soc | 0.58 | pv_illumination | 1 | Vpp | 20.788 | Ipp | 1.1823 | IppL | 1.1823 | Ipp | delta | 0 | soc | 0.5828 | Vbb | 12.74 | Vpp | 20.201 | Ipp | 2.6719 | Ipp | delta | 0 | Ibb | 4.237 | Tt/16 | 20 | Tt | 320 | Tp/16 | 12.3125 | Tp | 197 | Tpe/16 | 20.5625 | Tpe | 329 | track | 0 | current | dn, | ccm: | dutyChange | -1 | Tt/16 | 20 | Tt | 320 | Tp/16 | 12.25 | Tp | 196 | Tpe/16 | 20.5625 | Tpe
pwm1.current_Test:Time | 88.5 | target | 2 | battery_soc | 0.59 | pv_illumination | 1 | Vpp | 20.201 | Ipp | 2.6719 | IppL | 2.6719 | Ipp | delta | 0 | soc | 0.5872 | Vbb | 12.4392 | Vpp | 20.8 | Ipp | 1.154 | Ipp | delta | 0 | Ibb | 1.93 | Tt/16 | 20 | Tt | 320 | Tp/16 | 12.25 | Tp | 196 | Tpe/16 | 20.5625 | Tpe | 329 | track | 2 | current | up, | ccm: | dutyChange | 1 | Tt/16 | 20 | Tt | 320 | Tp/16 | 12.3125 | Tp | 197 | Tpe/16 | 20.5625 | Tpe
pwm1.current_Test:Time | 89 | target | 2 | battery_soc | 0.59 | pv_illumination | 1 | Vpp | 20.8 | Ipp | 1.154 | IppL | 1.154 | Ipp | delta | 0 | soc | 0.5891 | Vbb | 12.7461 | Vpp | 20.206 | Ipp | 2.6581 | Ipp | delta | 0 | Ibb | 4.214 | Tt/16 | 20 | Tt | 320 | Tp/16 | 12.3125 | Tp | 197 | Tpe/16 | 20.5625 | Tpe | 329 | track | 0 | current | dn, | ccm: | dutyChange | -1 | Tt/16 | 20 | Tt | 320 | Tp/16 | 12.25 | Tp | 196 | Tpe/16 | 20.5625 | Tpe
pwm1.current_Test:Time | 89.5 | target | 2 | battery_soc | 0.59 | pv_illumination | 1 | Vpp | 20.206 | Ipp | 2.6581 | IppL | 2.6581 | Ipp | delta | 0 | soc | 0.5934 | Vbb | 12.4431 | Vpp | 20.81 | Ipp | 1.1292 | Ipp | delta | 0 | Ibb | 1.889 | Tt/16 | 20 | Tt | 320 | Tp/16 | 12.25 | Tp | 196 | Tpe/16 | 20.5625 | Tpe | 329 | track | 2 | current | up, | ccm: | dutyChange | 1 | Tt/16 | 20 | Tt | 320 | Tp/16 | 12.3125 | Tp | 197 | Tpe/16 | 20.5625 | Tpe
pwm1.current_Test:Time | 90 | target | 2 | battery_soc | 0.6 | pv_illumination | 1 | Vpp | 20.81 | Ipp | 1.1292 | IppL | 1.1292 | Ipp | delta | 0 | soc | 0.5952 | Vbb | 12.7517 | Vpp | 20.212 | Ipp | 2.6415 | Ipp | delta | 0 | Ibb | 4.187 | Tt/16 | 20 | Tt | 320 | Tp/16 | 12.3125 | Tp | 197 | Tpe/16 | 20.5625 | Tpe | 329 | track | 0 | current | dn, | ccm: | dutyChange | -1 | Tt/16 | 20 | Tt | 320 | Tp/16 | 12.25 | Tp | 196 | Tpe/16 | 20.5625 | Tpe
pwm1.current_Test:Time | 90.5 | target | 2 | battery_soc | 0.6 | pv_illumination | 1 | Vpp | 20.212 | Ipp | 2.6415 | IppL | 2.6415 | Ipp | delta | 0 | soc | 0.5995 | Vbb | 12.4474 | Vpp | 20.819 | Ipp | 1.107 | Ipp | delta | 0 | Ibb | 1.851 | Tt/16 | 20 | Tt | 320 | Tp/16 | 12.25 | Tp | 196 | Tpe/16 | 20.5625 | Tpe | 329 | track | 2 | current | up, | ccm: | dutyChange | 1 | Tt/16 | 20 | Tt | 320 | Tp/16 | 12.3125 | Tp | 197 | Tpe/16 | 20.5625 | Tpe
pwm1.current_Test:Time | 91 | target | 2 | battery_soc | 0.6 | pv_illumination | 1 | Vpp | 20.819 | Ipp | 1.107 | IppL | 1.107 | Ipp | delta | 0 | soc | 0.6013 | Vbb | 12.7568 | Vpp | 20.219 | Ipp | 2.6233 | Ipp | delta | 0 | Ibb | 4.158 | Tt/16 | 20 | Tt | 320 | Tp/16 | 12.3125 | Tp | 197 | Tpe/16 | 20.5625 | Tpe | 329 | track | 0 | current | dn, | ccm: | dutyChange | -1 | Tt/16 | 20 | Tt | 320 | Tp/16 | 12.25 | Tp | 196 | Tpe/16 | 20.5625 | Tpe
pwm1.current_Test:Time | 91.5 | target | 2 | battery_soc | 0.61 | pv_illumination | 1 | Vpp | 20.219 | Ipp | 2.6233 | IppL | 2.6233 | Ipp | delta | 0 | soc | 0.6056 | Vbb | 12.452 | Vpp | 20.827 | Ipp | 1.0866 | Ipp | delta | 0 | Ibb | 1.817 | Tt/16 | 20 | Tt | 320 | Tp/16 | 12.25 | Tp | 196 | Tpe/16 | 20.5625 | Tpe | 329 | track | 2 | current | up, | ccm: | dutyChange | 1 | Tt/16 | 20 | Tt | 320 | Tp/16 | 12.3125 | Tp | 197 | Tpe/16 | 20.5625 | Tpe
pwm1.current_Test:Time | 92 | target | 2 | battery_soc | 0.61 | pv_illumination | 1 | Vpp | 20.827 | Ipp | 1.0866 | IppL | 1.0866 | Ipp | delta | 0 | soc | 0.6074 | Vbb | 12.7616 | Vpp | 20.227 | Ipp | 2.6038 | Ipp | delta | 0 | Ibb | 4.127 | Tt/16 | 20 | Tt | 320 | Tp/16 | 12.3125 | Tp | 197 | Tpe/16 | 20.5625 | Tpe | 329 | track | 0 | current | dn, | ccm: | dutyChange | -1 | Tt/16 | 20 | Tt | 320 | Tp/16 | 12.25 | Tp | 196 | Tpe/16 | 20.5625 | Tpe
pwm1.current_Test:Time | 92.5 | target | 2 | battery_soc | 0.61 | pv_illumination | 1 | Vpp | 20.227 | Ipp | 2.6038 | IppL | 2.6038 | Ipp | delta | 0 | soc | 0.6116 | Vbb | 12.4568 | Vpp | 20.835 | Ipp | 1.0675 | Ipp | delta | 0 | Ibb | 1.785 | Tt/16 | 20 | Tt | 320 | Tp/16 | 12.25 | Tp | 196 | Tpe/16 | 20.5625 | Tpe | 329 | track | 2 | current | up, | ccm: | dutyChange | 1 | Tt/16 | 20 | Tt | 320 | Tp/16 | 12.3125 | Tp | 197 | Tpe/16 | 20.5625 | Tpe
pwm1.current_Test:Time | 93 | target | 2 | battery_soc | 0.61 | pv_illumination | 1 | Vpp | 20.835 | Ipp | 1.0675 | IppL | 1.0675 | Ipp | delta | 0 | soc | 0.6133 | Vbb | 12.7661 | Vpp | 20.234 | Ipp | 2.5837 | Ipp | delta | 0 | Ibb | 4.095 | Tt/16 | 20 | Tt | 320 | Tp/16 | 12.3125 | Tp | 197 | Tpe/16 | 20.5625 | Tpe | 329 | track | 0 | current | dn, | ccm: | dutyChange | -1 | Tt/16 | 20 | Tt | 320 | Tp/16 | 12.25 | Tp | 196 | Tpe/16 | 20.5625 | Tpe
pwm1.current_Test:Time | 93.5 | target | 2 | battery_soc | 0.62 | pv_illumination | 1 | Vpp | 20.234 | Ipp | 2.5837 | IppL | 2.5837 | Ipp | delta | 0 | soc | 0.6175 | Vbb | 12.4617 | Vpp | 20.843 | Ipp | 1.0493 | Ipp | delta | 0 | Ibb | 1.755 | Tt/16 | 20 | Tt | 320 | Tp/16 | 12.25 | Tp | 196 | Tpe/16 | 20.5625 | Tpe | 329 | track | 2 | current | up, | ccm: | dutyChange | 1 | Tt/16 | 20 | Tt | 320 | Tp/16 | 12.3125 | Tp | 197 | Tpe/16 | 20.5625 | Tpe
pwm1.current_Test:Time | 94 | target | 2 | battery_soc | 0.62 | pv_illumination | 1 | Vpp | 20.843 | Ipp | 1.0493 | IppL | 1.0493 | Ipp | delta | 0 | soc | 0.6192 | Vbb | 12.7704 | Vpp | 20.242 | Ipp | 2.5631 | Ipp | delta | 0 | Ibb | 4.063 | Tt/16 | 20 | Tt | 320 | Tp/16 | 12.3125 | Tp | 197 | Tpe/16 | 20.5625 | Tpe | 329 | track | 0 | current | dn, | ccm: | dutyChange | -1 | Tt/16 | 20 | Tt | 320 | Tp/16 | 12.25 | Tp | 196 | Tpe/16 | 20.5625 | Tpe
pwm1.current_Test:Time | 94.5 | target | 2 | battery_soc | 0.62 | pv_illumination | 1 | Vpp | 20.242 | Ipp | 2.5631 | IppL | 2.5631 | Ipp | delta | 0 | soc | 0.6234 | Vbb | 12.4666 | Vpp | 20.85 | Ipp | 1.0319 | Ipp | delta | 0 | Ibb | 1.726 | Tt/16 | 20 | Tt | 320 | Tp/16 | 12.25 | Tp | 196 | Tpe/16 | 20.5625 | Tpe | 329 | track | 2 | current | up, | ccm: | dutyChange | 1 | Tt/16 | 20 | Tt | 320 | Tp/16 | 12.3125 | Tp | 197 | Tpe/16 | 20.5625 | Tpe
pwm1.current_Test:Time | 95 | target | 2 | battery_soc | 0.63 | pv_illumination | 1 | Vpp | 20.85 | Ipp | 1.0319 | IppL | 1.0319 | Ipp | delta | 0 | soc | 0.6251 | Vbb | 12.7747 | Vpp | 20.25 | Ipp | 2.5423 | Ipp | delta | 0 | Ibb | 4.03 | Tt/16 | 20 | Tt | 320 | Tp/16 | 12.3125 | Tp | 197 | Tpe/16 | 20.5625 | Tpe | 329 | track | 0 | current | dn, | ccm: | dutyChange | -1 | Tt/16 | 20 | Tt | 320 | Tp/16 | 12.25 | Tp | 196 | Tpe/16 | 20.5625 | Tpe
pwm1.current_Test:Time | 95.5 | target | 2 | battery_soc | 0.63 | pv_illumination | 1 | Vpp | 20.25 | Ipp | 2.5423 | IppL | 2.5423 | Ipp | delta | 0 | soc | 0.6292 | Vbb | 12.4716 | Vpp | 20.857 | Ipp | 1.015 | Ipp | delta | 0 | Ibb | 1.697 | Tt/16 | 20 | Tt | 320 | Tp/16 | 12.25 | Tp | 196 | Tpe/16 | 20.5625 | Tpe | 329 | track | 2 | current | up, | ccm: | dutyChange | 1 | Tt/16 | 25.6875 | Tt | 411 | Tp/16 | 12.3125 | Tp | 197 | Tpe/16 | 20.5625 | Tpe
pwm1.current_Test:Time | 96 | target | 2 | battery_soc | 0.63 | pv_illumination | 1 | Vpp | 20.857 | Ipp | 1.015 | IppL | 1.015 | Ipp | delta | 0 | soc | 0.6309 | Vbb | 12.5218 | Vpp | 20.771 | Ipp | 1.2248 | Ipp | delta | -0.0124 | Ibb | 2.032 | Tt/16 | 25.6875 | Tt | 411 | Tp/16 | 12.3125 | Tp | 197 | Tpe/16 | 20.5625 | Tpe | 329 | track | 3 | current | up, | dcm: | dutyChange | 1 | Tt/16 | 20 | Tt | 320 | Tp/16 | 12.375 | Tp | 198 | Tpe/16 | 20.5 | Tpe
pwm1.current_Test:Time | 96.5 | target | 2 | battery_soc | 0.63 | pv_illumination | 1 | Vpp | 20.771 | Ipp | 1.2248 | IppL | 1.2371 | Ipp | delta | -0.0124 | soc | 0.6329 | Vbb | 12.7902 | Vpp | 20.237 | Ipp | 2.5763 | Ipp | delta | 0 | Ibb | 4.076 | Tt/16 | 20 | Tt | 320 | Tp/16 | 12.375 | Tp | 198 | Tpe/16 | 20.5 | Tpe | 328 | track | 0 | current | dn, | ccm: | dutyChange | -1 | Tt/16 | 20 | Tt | 320 | Tp/16 | 12.3125 | Tp | 197 | Tpe/16 | 20.5 | Tpe
pwm1.current_Test:Time | 97 | target | 2 | battery_soc | 0.64 | pv_illumination | 1 | Vpp | 20.237 | Ipp | 2.5763 | IppL | 2.5763 | Ipp | delta | 0 | soc | 0.6371 | Vbb | 12.5221 | Vpp | 20.776 | Ipp | 1.2129 | Ipp | delta | 0 | Ibb | 2.012 | Tt/16 | 20 | Tt | 320 | Tp/16 | 12.3125 | Tp | 197 | Tpe/16 | 20.5 | Tpe | 328 | track | 2 | current | up, | ccm: | dutyChange | 1 | Tt/16 | 20 | Tt | 320 | Tp/16 | 12.375 | Tp | 198 | Tpe/16 | 20.5 | Tpe
pwm1.current_Test:Time | 97.5 | target | 2 | battery_soc | 0.64 | pv_illumination | 1 | Vpp | 20.776 | Ipp | 1.2129 | IppL | 1.2129 | Ipp | delta | 0 | soc | 0.6391 | Vbb | 12.7989 | Vpp | 20.238 | Ipp | 2.5752 | Ipp | delta | 0 | Ibb | 4.072 | Tt/16 | 20 | Tt | 320 | Tp/16 | 12.375 | Tp | 198 | Tpe/16 | 20.5 | Tpe | 328 | track | 0 | current | dn, | ccm: | dutyChange | -1 | Tt/16 | 20 | Tt | 320 | Tp/16 | 12.3125 | Tp | 197 | Tpe/16 | 20.5 | Tpe
pwm1.current_Test:Time | 98 | target | 2 | battery_soc | 0.64 | pv_illumination | 1 | Vpp | 20.238 | Ipp | 2.5752 | IppL | 2.5752 | Ipp | delta | 0 | soc | 0.6432 | Vbb | 12.5239 | Vpp | 20.79 | Ipp | 1.1783 | Ipp | delta | 0 | Ibb | 1.956 | Tt/16 | 20 | Tt | 320 | Tp/16 | 12.3125 | Tp | 197 | Tpe/16 | 20.5 | Tpe | 328 | track | 2 | current | up, | ccm: | dutyChange | 1 | Tt/16 | 20 | Tt | 320 | Tp/16 | 12.375 | Tp | 198 | Tpe/16 | 20.5 | Tpe
pwm1.current_Test:Time | 98.5 | target | 2 | battery_soc | 0.65 | pv_illumination | 1 | Vpp | 20.79 | Ipp | 1.1783 | IppL | 1.1783 | Ipp | delta | 0 | soc | 0.6451 | Vbb | 12.8061 | Vpp | 20.241 | Ipp | 2.5675 | Ipp | delta | 0 | Ibb | 4.058 | Tt/16 | 20 | Tt | 320 | Tp/16 | 12.375 | Tp | 198 | Tpe/16 | 20.5 | Tpe | 328 | track | 0 | current | dn, | ccm: | dutyChange | -1 | Tt/16 | 20 | Tt | 320 | Tp/16 | 12.3125 | Tp | 197 | Tpe/16 | 20.5 | Tpe
pwm1.current_Test:Time | 99 | target | 2 | battery_soc | 0.65 | pv_illumination | 1 | Vpp | 20.241 | Ipp | 2.5675 | IppL | 2.5675 | Ipp | delta | 0 | soc | 0.6493 | Vbb | 12.5268 | Vpp | 20.802 | Ipp | 1.1495 | Ipp | delta | 0 | Ibb | 1.909 | Tt/16 | 20 | Tt | 320 | Tp/16 | 12.3125 | Tp | 197 | Tpe/16 | 20.5 | Tpe | 328 | track | 2 | current | up, | ccm: | dutyChange | 1 | Tt/16 | 20 | Tt | 320 | Tp/16 | 12.375 | Tp | 198 | Tpe/16 | 20.5 | Tpe
pwm1.current_Test:Time | 99.5 | target | 2 | battery_soc | 0.65 | pv_illumination | 1 | Vpp | 20.802 | Ipp | 1.1495 | IppL | 1.1495 | Ipp | delta | 0 | soc | 0.6511 | Vbb | 12.8123 | Vpp | 20.245 | Ipp | 2.5553 | Ipp | delta | 0 | Ibb | 4.038 | Tt/16 | 20 | Tt | 320 | Tp/16 | 12.375 | Tp | 198 | Tpe/16 | 20.5 | Tpe | 328 | track | 0 | current | dn, | ccm: | dutyChange | -1 | Tt/16 | 20 | Tt | 320 | Tp/16 | 12.3125 | Tp | 197 | Tpe/16 | 20.5 | Tpe
pwm1.current_Test:Time | 100 | target | 2 | battery_soc | 0.66 | pv_illumination | 1 | Vpp | 20.245 | Ipp | 2.5553 | IppL | 2.5553 | Ipp | delta | 0 | soc | 0.6553 | Vbb | 12.5304 | Vpp | 20.812 | Ipp | 1.1246 | Ipp | delta | 0 | Ibb | 1.868 | Tt/16 | 20 | Tt | 320 | Tp/16 | 12.3125 | Tp | 197 | Tpe/16 | 20.5 | Tpe | 328 | track | 2 | current | up, | ccm: | dutyChange | 1 | Tt/16 | 20 | Tt | 320 | Tp/16 | 12.375 | Tp | 198 | Tpe/16 | 20.5 | Tpe
pwm1.current_Test:Time | 100.5 | target | 2 | battery_soc | 0.66 | pv_illumination | 1 | Vpp | 20.812 | Ipp | 1.1246 | IppL | 1.1246 | Ipp | delta | 0 | soc | 0.6571 | Vbb | 12.8179 | Vpp | 20.251 | Ipp | 2.5402 | Ipp | delta | 0 | Ibb | 4.013 | Tt/16 | 20 | Tt | 320 | Tp/16 | 12.375 | Tp | 198 | Tpe/16 | 20.5 | Tpe | 328 | track | 0 | current | dn, | ccm: | dutyChange | -1 | Tt/16 | 20 | Tt | 320 | Tp/16 | 12.3125 | Tp | 197 | Tpe/16 | 20.5 | Tpe
pwm1.current_Test:Time | 101 | target | 2 | battery_soc | 0.66 | pv_illumination | 1 | Vpp | 20.251 | Ipp | 2.5402 | IppL | 2.5402 | Ipp | delta | 0 | soc | 0.6612 | Vbb | 12.5345 | Vpp | 20.821 | Ipp | 1.1025 | Ipp | delta | 0 | Ibb | 1.831 | Tt/16 | 20 | Tt | 320 | Tp/16 | 12.3125 | Tp | 197 | Tpe/16 | 20.5 | Tpe | 328 | track | 2 | current | up, | ccm: | dutyChange | 1 | Tt/16 | 20 | Tt | 320 | Tp/16 | 12.375 | Tp | 198 | Tpe/16 | 20.5 | Tpe
pwm1.current_Test:Time | 101.5 | target | 2 | battery_soc | 0.66 | pv_illumination | 1 | Vpp | 20.821 | Ipp | 1.1025 | IppL | 1.1025 | Ipp | delta | 0 | soc | 0.663 | Vbb | 12.8229 | Vpp | 20.258 | Ipp | 2.5231 | Ipp | delta | 0 | Ibb | 3.986 | Tt/16 | 20 | Tt | 320 | Tp/16 | 12.375 | Tp | 198 | Tpe/16 | 20.5 | Tpe | 328 | track | 0 | current | dn, | ccm: | dutyChange | -1 | Tt/16 | 20 | Tt | 320 | Tp/16 | 12.3125 | Tp | 197 | Tpe/16 | 20.5 | Tpe
pwm1.current_Test:Time | 102 | target | 2 | battery_soc | 0.67 | pv_illumination | 1 | Vpp | 20.258 | Ipp | 2.5231 | IppL | 2.5231 | Ipp | delta | 0 | soc | 0.6671 | Vbb | 12.5389 | Vpp | 20.829 | Ipp | 1.0823 | Ipp | delta | 0 | Ibb | 1.798 | Tt/16 | 20 | Tt | 320 | Tp/16 | 12.3125 | Tp | 197 | Tpe/16 | 20.5 | Tpe | 328 | track | 2 | current | up, | ccm: | dutyChange | 1 | Tt/16 | 20 | Tt | 320 | Tp/16 | 12.375 | Tp | 198 | Tpe/16 | 20.5 | Tpe
pwm1.current_Test:Time | 102.5 | target | 2 | battery_soc | 0.67 | pv_illumination | 1 | Vpp | 20.829 | Ipp | 1.0823 | IppL | 1.0823 | Ipp | delta | 0 | soc | 0.6688 | Vbb | 12.8277 | Vpp | 20.265 | Ipp | 2.5048 | Ipp | delta | 0 | Ibb | 3.957 | Tt/16 | 20 | Tt | 320 | Tp/16 | 12.375 | Tp | 198 | Tpe/16 | 20.5 | Tpe | 328 | track | 0 | current | dn, | ccm: | dutyChange | -1 | Tt/16 | 20 | Tt | 320 | Tp/16 | 12.3125 | Tp | 197 | Tpe/16 | 20.5 | Tpe
pwm1.current_Test:Time | 103 | target | 2 | battery_soc | 0.67 | pv_illumination | 1 | Vpp | 20.265 | Ipp | 2.5048 | IppL | 2.5048 | Ipp | delta | 0 | soc | 0.6729 | Vbb | 12.5434 | Vpp | 20.837 | Ipp | 1.0635 | Ipp | delta | 0 | Ibb | 1.767 | Tt/16 | 20 | Tt | 320 | Tp/16 | 12.3125 | Tp | 197 | Tpe/16 | 20.5 | Tpe | 328 | track | 2 | current | up, | ccm: | dutyChange | 1 | Tt/16 | 20 | Tt | 320 | Tp/16 | 12.375 | Tp | 198 | Tpe/16 | 20.5 | Tpe
pwm1.current_Test:Time | 103.5 | target | 2 | battery_soc | 0.67 | pv_illumination | 1 | Vpp | 20.837 | Ipp | 1.0635 | IppL | 1.0635 | Ipp | delta | 0 | soc | 0.6746 | Vbb | 12.8321 | Vpp | 20.272 | Ipp | 2.4856 | Ipp | delta | 0 | Ibb | 3.927 | Tt/16 | 20 | Tt | 320 | Tp/16 | 12.375 | Tp | 198 | Tpe/16 | 20.5 | Tpe | 328 | track | 0 | current | dn, | ccm: | dutyChange | -1 | Tt/16 | 20 | Tt | 320 | Tp/16 | 12.3125 | Tp | 197 | Tpe/16 | 20.5 | Tpe
pwm1.current_Test:Time | 104 | target | 2 | battery_soc | 0.68 | pv_illumination | 1 | Vpp | 20.272 | Ipp | 2.4856 | IppL | 2.4856 | Ipp | delta | 0 | soc | 0.6786 | Vbb | 12.5481 | Vpp | 20.844 | Ipp | 1.0457 | Ipp | delta | 0 | Ibb | 1.737 | Tt/16 | 20 | Tt | 320 | Tp/16 | 12.3125 | Tp | 197 | Tpe/16 | 20.5 | Tpe | 328 | track | 2 | current | up, | ccm: | dutyChange | 1 | Tt/16 | 20 | Tt | 320 | Tp/16 | 12.375 | Tp | 198 | Tpe/16 | 20.5 | Tpe
pwm1.current_Test:Time | 104.5 | target | 2 | battery_soc | 0.68 | pv_illumination | 1 | Vpp | 20.844 | Ipp | 1.0457 | IppL | 1.0457 | Ipp | delta | 0 | soc | 0.6803 | Vbb | 12.8364 | Vpp | 20.28 | Ipp | 2.4661 | Ipp | delta | 0 | Ibb | 3.896 | Tt/16 | 20 | Tt | 320 | Tp/16 | 12.375 | Tp | 198 | Tpe/16 | 20.5 | Tpe | 328 | track | 0 | current | dn, | ccm: | dutyChange | -1 | Tt/16 | 20 | Tt | 320 | Tp/16 | 12.3125 | Tp | 197 | Tpe/16 | 20.5 | Tpe
pwm1.current_Test:Time | 105 | target | 2 | battery_soc | 0.68 | pv_illumination | 1 | Vpp | 20.28 | Ipp | 2.4661 | IppL | 2.4661 | Ipp | delta | 0 | soc | 0.6843 | Vbb | 12.5528 | Vpp | 20.851 | Ipp | 1.0285 | Ipp | delta | 0 | Ibb | 1.708 | Tt/16 | 20 | Tt | 320 | Tp/16 | 12.3125 | Tp | 197 | Tpe/16 | 20.5 | Tpe | 328 | track | 2 | current | up, | ccm: | dutyChange | 1 | Tt/16 | 25.625 | Tt | 410 | Tp/16 | 12.375 | Tp | 198 | Tpe/16 | 20.5 | Tpe
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
