farmerkeith/SolarChargerTwoAmp10percent/schematic/Deba168_Solar_Charger3cmods.pdf

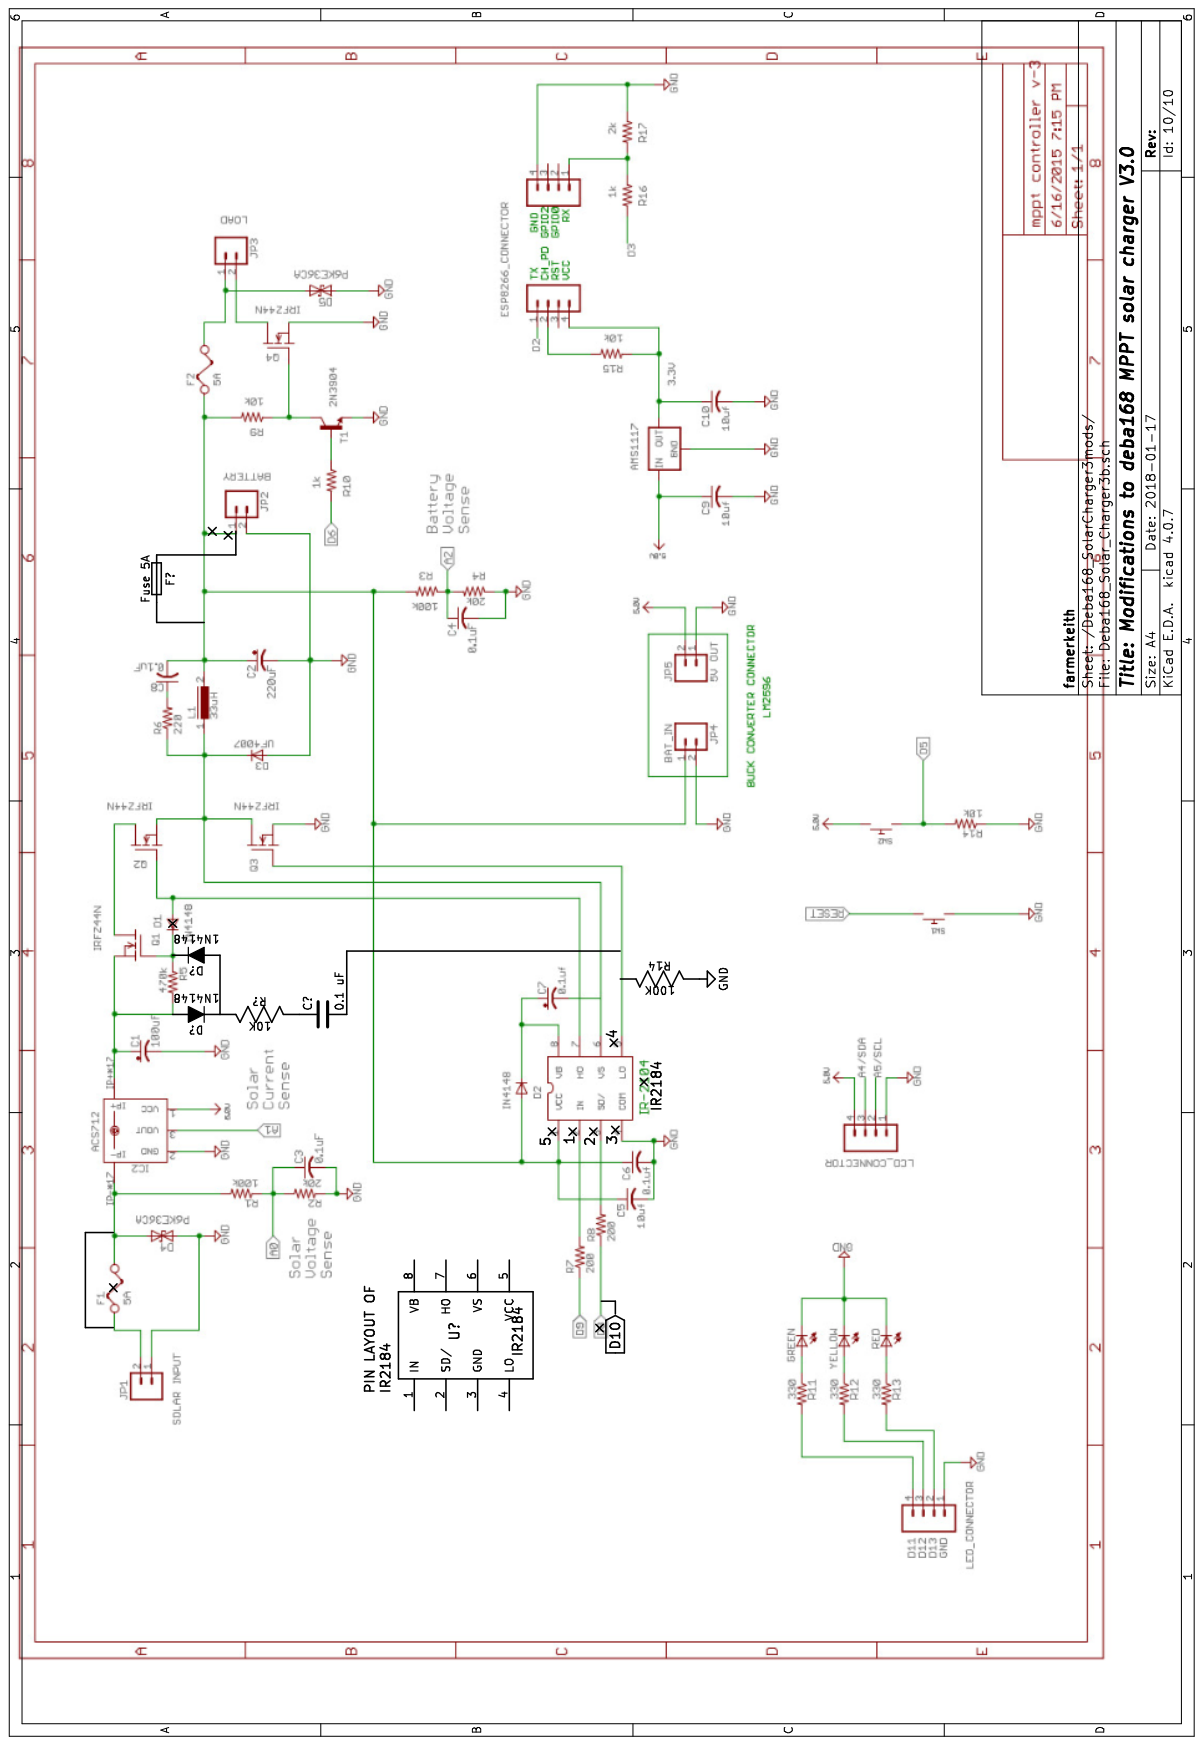
[picture p1: page 1]
