farmerkeith/SolarChargerTwoAmp10percent/(commit log)

2018-01-29 initial commit, part way through unit testing of the software
    [Deba168_Solar_Charger3b.sch, Solar_Charger3.kicad_pcb, Solar_Charger3.sch, Solar_Charger3_01.sch, Solar_charger3Nano.sch, Solar_charger3a.sch, Solar_chargerButtons.sch, Solar_chargerLCD.sch]
2018-01-30 system testing commenced
    [Results1.ods]
2018-01-31 software system testing progressed
    [TwoAmp10%Design.ods]
2018-02-01 System test debugging changes
    [TwoAmp10%Design.ods]
2018-02-02 system testing approaching complete, ready for pwm test
2018-05-13 minor updates
    [Solar_charger3a.sch, TwoAmp10%Design.ods]
